martinrybka2000/openacme-pfm/v1.0/README.md

# V1.0 — legacy prototype (reference only)

This directory is the home for the **unorganized dump** of the V1.0 work, kept for reference:

- The master's thesis as PDF (Polish and English).
- The V1.0 KiCad project (`PCB/`), firmware (`Firmware_VSCode/`) and measurement data (`pomiary/`).
- Serial Studio project files (`Serial_studio_proj/`).
- Third-party libraries used by V1.0 (`scpi-parser-master/`).

**No cleanup, no support.** These files are historical reference; active development happens at the repository root (V2.0).
