martinrybka2000/openacme-pfm/docs/protocol/modbus-map.md

# Modbus map

TBD — define the register map.

Planned sections:

- **Read:** measurement registers (Urms, Irms, P, Q, S, PF, DPF, DF, THD_U, THD_I, f, peaks, …).
- **Config:** network/IP settings, calibration factors, SOGI-PLL gains, mode selection.
- **Status:** device state, fault flags.

Work in progress — see `docs/requirements/requirements.md` (REQ-C-*).
