martinrybka2000/openacme-pfm/docs/protocol/pqdif.md

# PQDIF (IEEE 1159.3)

TBD.

Plan: export measurement records in **PQDIF** so they open directly in professional power-quality analysis tools — bringing the open-source project to parity with commercial analysers (see V1.0 thesis, section 7.3).

Notes:

- Standard: IEEE Std 1159.3.
- Reference for the format and compression (zlib).
- Decide record types to support (observations, statistics).
