martinrybka2000/openacme-pfm/v1.0/PCB/V1_0_notes.sync-conflict-20260513-040853-QFY63LB.txt

ESD footprint
TPS UV/OV resistors
VCC do fault led powinno być przed TPS
R35 zbędny, R36 prawdopodobnie też 
Odstep pomiędzy wyspami zasilań 
złe rezystory do tpsa
