martinrybka2000/openacme-pfm/v1.0/PDFs/Cyfrowy Pomiar Współczynnika Mocy_ Opis, Metody i Komponenty_.pdf

## Cyfrowy Pomiar Współczynnika Mocy: Szczegółowy Opis i Metody

### Wprowadzenie do Cyfrowego Pomiaru Współczynnika Mocy

Cyfrowy pomiar współczynnika mocy (PF) to nowoczesna metoda określania efektywności wykorzystania energii elektrycznej w obwodach prądu przemiennego (AC). W przeciwieństwie do tradycyjnych metod analogowych, cyfrowe techniki pomiarowe oferują wyższą dokładność, większą wszechstronność i możliwość analizy złożonych przebiegów napięcia i prądu.

1 Metoda ta polega na wykorzystaniu zaawansowanych układów elektronicznych i algorytmów do precyzyjnego określenia współczynnika mocy, nawet w obecności zniekształceń harmonicznych.

7

### Komponenty Wykorzystywane w Cyfrowym Pomiarze Współczynnika Mocy

Do przeprowadzenia cyfrowego pomiaru współczynnika mocy wykorzystuje się szereg komponentów elektronicznych, które współpracują ze sobą w celu akwizycji, przetwarzania i wyświetlenia danych. Typowy system pomiarowy obejmuje:
1. Czujniki Napięcia i Prądu:
- Przekładniki prądowe (CT - Current Transformers): Służą do bezpiecznego i proporcjonalnego zmniejszenia wartości prądu płynącego w obwodzie do poziomu akceptowalnego dla układów pomiarowych.

13
Umożliwiają pomiar prądów o dużych wartościach bez konieczności bezpośredniego łączenia z obwodem o wysokim napięciu.

7
- Przekładniki napięciowe (PT - Potential Transformers): Podobnie jak przekładniki prądowe, służą do zmniejszenia wysokich napięć do bezpiecznych poziomów pomiarowych.

13
- Rezystory bocznikowe (Shunt Resistors): Precyzyjne rezystory o małej rezystancji, umieszczane szeregowo w obwodzie, na których mierzony jest spadek napięcia proporcjonalny do przepływającego prądu.

13
- Sondy napięciowe i prądowe (Voltage and Current Probes): Wykorzystywane w połączeniu z oscyloskopami i analizatorami jakości energii do akwizycji przebiegów napięcia i prądu.

7 Sondy prądowe, często oparte na technologii cęgowej (clamp-on), umożliwiają pomiar prądu bez przerywania obwodu.

7
2. Układy Przetwarzania Sygnałów Analogowych:
- Wzmacniacze: Wzmacniają sygnały z czujników do poziomów odpowiednich dla przetworników analogowo-cyfrowych.

26

- Filtry: Służą do eliminacji niepożądanych składowych sygnału, takich jak szumy i zakłócenia.

26
3. Przetworniki Analogowo-Cyfrowe (ADC - Analog-to-Digital Converters):
- Przekształcają ciągłe sygnały analogowe (napięcie i prąd) na ich dyskretne reprezentacje cyfrowe w postaci próbek o określonej rozdzielczości i częstotliwości próbkowania. Wyższa rozdzielczość (liczba bitów) i wyższa częstotliwość próbkowania pozwalają na dokładniejsze odwzorowanie przebiegów, zwłaszcza w przypadku sygnałów o złożonym kształcie lub zawierających harmoniczne.

26
4. Mikrokontroler lub Cyfrowy Procesor Sygnałowy (MCU/DSP -Microcontroller Unit/Digital Signal Processor):
- Stanowi centralną jednostkę obliczeniową systemu pomiarowego. Wykonuje algorytmy do obliczania wartości skutecznych napięcia i prądu, mocy czynnej, mocy pozornej oraz współczynnika mocy na podstawie danych cyfrowych z przetworników ADC.

27 DSP są zoptymalizowane do szybkiego przetwarzania sygnałów, co jest szczególnie ważne przy analizie harmonicznych i złożonych przebiegów.

27
5. Pamięć:
- Służy do przechowywania próbek danych z przetworników ADC, wyników obliczeń oraz oprogramowania sterującego mikrokontrolerem/DSP.
6. Wyświetlacz:
- Umożliwia prezentację zmierzonej wartości współczynnika mocy oraz innych parametrów elektrycznych, takich jak napięcie, prąd, moc czynna, moc bierna, częstotliwość. Wyświetlacze mogą być numeryczne lub graczne, w zależności od złożoności miernika.
7. Interfejs Komunikacyjny (Opcjonalnie):
- Niektóre zaawansowane mierniki i analizatory posiadają interfejsy komunikacyjne (np. USB, Ethernet, Wi-Fi) do przesyłania danych do komputera w celu dalszej analizy, raportowania lub zdalnego monitorowania.

### Metody Cyfrowego Pomiaru Współczynnika Mocy i Obliczenia

Cyfrowy pomiar współczynnika mocy opiera się na analizie próbek napięcia i prądu w czasie. Podstawowe kroki i związane z nimi obliczenia obejmują:
1. Pobieranie Próbek Napięcia i Prądu:
- Czujniki napięcia i prądu dostarczają sygnały analogowe proporcjonalne do mierzonych wielkości.
- Przetworniki ADC próbkują te sygnały jednocześnie z określoną częstotliwością w ciągu jednego lub więcej cykli prądu przemiennego.

2. Obliczanie Wartości Skutecznych (RMS - Root Mean Square):
- Na podstawie zebranych próbek cyfrowych obliczane są wartości skuteczne napięcia (VRMS

) i prądu (IRMS

).

7 Wartość skuteczna jest miarą efektywnej wartości sygnału AC, odpowiadającej wartości napięcia/prądu DC, która wydzieliłaby taką samą moc na rezystancji.
- Wzór na wartość skuteczną dla dyskretnych próbek:

oraz

gdzie N to liczba próbek, a vi

i i

i to poszczególne próbki napięcia i prądu.

3. Obliczanie Mocy Czynnej (P - Real Power):
- Moc czynna reprezentuje rzeczywistą moc zużywaną przez obciążenie do wykonania użytecznej pracy.

7 W cyfrowym pomiarze, moc czynną można obliczyć na dwa sposoby:
■ Metoda bezpośrednia (przez moc chwilową): Oblicza się chwilową moc (Pi = vi * i
i) dla każdej pary próbek napięcia i prądu, a następnie wyznacza się średnią wartość mocy chwilowej w danym okresie.

7

■ Metoda wykorzystująca kąt fazowy (dla przebiegów sinusoidalnych): Jeśli przebiegi napięcia i prądu są sinusoidalne, moc czynną można obliczyć znając kąt fazowy (φ) między nimi: P = VRMS * IRMS * cos(φ).

7
Kąt fazowy jest określany na podstawie analizy czasowej przebiegów.
4. Obliczanie Mocy Pozornej (S - Apparent Power):
- Moc pozorna jest iloczynem wartości skutecznych napięcia i prądu.

7

S = VRMS * IRMS

5. Obliczanie Współczynnika Mocy (PF - Power Factor):
- Współczynnik mocy jest deniowany jako stosunek mocy czynnej do mocy pozornej.

7

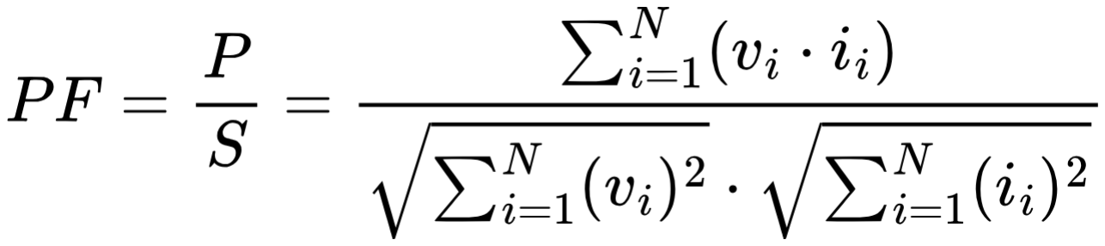
[picture p27: figure]

- Dla przebiegów sinusoidalnych: PF = cos(φ)

### Zaawansowane Aspekty Cyfrowego Pomiaru Współczynnika Mocy

W przypadku obciążeń nieliniowych, które generują harmoniczne prądu, współczynnik mocy jest bardziej złożony i obejmuje dwa komponenty:
- Współczynnik mocy przesunięcia (DPF - Displacement Power Factor): Jest to kosinus kąta fazowego między podstawowymi składowymi napięcia i prądu.

33
- Współczynnik zniekształceń (DF - Distortion Factor): Uwzględnia wpływ harmonicznych na współczynnik mocy.

34

Prawdziwy współczynnik mocy (True Power Factor) dla przebiegów niesinusoidalnych jest iloczynem współczynnika mocy przesunięcia i współczynnika zniekształceń:

True PF = DPF * DF

Analizatory jakości energii wykorzystują zaawansowane techniki, takie jak szybka transformata Fouriera (FFT), do analizy harmonicznych i dokładnego pomiaru prawdziwego współczynnika mocy.

7

### Zastosowania Cyfrowego Pomiaru Współczynnika Mocy

Cyfrowy pomiar współczynnika mocy jest szeroko stosowany w wielu aplikacjach, w tym:
- Monitorowanie i optymalizacja zużycia energii: Pozwala na identykację obciążeń o niskim współczynniku mocy i podejmowanie działań korygujących.

36
- Analiza jakości energii: Umożliwia ocenę wpływu harmonicznych na współczynnik mocy i ogólną jakość zasilania.

37
- Testowanie i certykacja urządzeń elektrycznych i elektronicznych: Sprawdzenie zgodności z normami dotyczącymi współczynnika mocy (np. IEC 61000-3-2).

44
- Diagnostyka i konserwacja systemów elektroenergetycznych: Wykrywanie problemów związanych z mocą bierną i przeciążeniami.

45

### Podsumowanie

Cyfrowy pomiar współczynnika mocy stanowi precyzyjne i wszechstronne narzędzie do oceny efektywności energetycznej systemów elektrycznych. Wykorzystanie nowoczesnych komponentów elektronicznych i zaawansowanych algorytmów umożliwia dokładny pomiar współczynnika mocy nawet w złożonych warunkach obciążenia. Zrozumienie zasady działania, wykorzystywanych komponentów oraz metod obliczeniowych jest kluczowe dla efektywnego wykorzystania tej technologii w praktyce inżynierskiej.

Cytowane prace

1. All about Power Factor Meters - A Detailed Guide - Beemet, otwierano: kwietnia 9, 2025, hps://beemet.com/power-factor-meter-guide/
2. Design of Digital power factor meter - Quest Journals, otwierano: kwietnia 9, 2025, hps://www.questjournals.org/jecer/papers/vol8-issue12/08120106.pdf
3. The Basic of Power Meter - PRODIGIT ELECTRONICS, otwierano: kwietnia 9, 2025, hps://www.prodigit.com/show/the-basic-of-power-meter.htm
4. What are the Applications and Uses of Digital Power Meter? - MEXTECH, otwierano: kwietnia 9, 2025, hps://mextechin.com/applications-uses-digital-power-meter/
5. (PDF) Digital Power Factor Meter - ResearchGate, otwierano: kwietnia 9, 2025, hps://www.researchgate.net/publication/361119529_Digital_Power_Factor_Meter
6. digital energy meter working principle - YouTube, otwierano: kwietnia 9, 2025, hps://www.youtube.com/watch?v=HcZC-_PtRk8
7. Power factor - Wikipedia, otwierano: kwietnia 9, 2025, hps://en.wikipedia.org/wiki/Power_factor
8. Fundamentals of AC Power Measurements | Tektronix, otwierano: kwietnia 9,
2025,
hps://www.tek.com/en/documents/application-note/fundamentals-ac-power-m easurements (https://www.tek.com/en/documents/application-note/fundamentals-ac-power-measurements)
9. How do you calculate the power factor of a power supply? - Electronics Stack Exchange, otwierano: kwietnia 9, 2025, hps://electronics.stackexchange.com/questions/138582/how-do-you-calculate-t he-power-factor-of-a-power-supply (https://electronics.stackexchange.com/questions/138582/how-do-you-calculate-the-power-factor-of-a-power-supply)
10. Power factor meters - how do they work, teardown, experiments - YouTube, otwierano: kwietnia 9, 2025, hps://www.youtube.com/watch?v=8WUJgbqElOc
11. Power Quality Analyzers | Instrumart, otwierano: kwietnia 9, 2025,
hps://www.instrumart.com/categories/5980/power-quality-analyzers
12. Power Analyzer: The Swiss Army Knife of Electronics Testing | Keysight Blogs,
otwierano: kwietnia 9, 2025, hps://www.keysight.com/blogs/en/tech/educ/2023/power-analyzer
13. www.uke.com, otwierano: kwietnia 9, 2025, hps://www.uke.com/en-us/learn/blog/power-quality/power-factor-formula#:~:t (https://www.fluke.com/en-us/learn/blog/power-quality/power-factor-formula)

ext=The%20lower%20the%20power%20factor,penalize%20a%20customer%20f or%20overutilization. (https://www.fluke.com/en-us/learn/blog/power-quality/power-factor-formula)
14. Fundamentals of Electric Power Measurements | Yokogawa Test&Measurement,
otwierano: kwietnia 9, 2025, hps://tmi.yokogawa.com/us/library/resources/white-papers/fundamentals-of-ele ctric-power-measurements/ (https://tmi.yokogawa.com/us/library/resources/white-papers/fundamentals-of-electric-power-measurements/)
15. Power Supply Measurement & Analysis with Bench Oscilloscopes | Tektronix,
otwierano: kwietnia 9, 2025, hps://www.tek.com/en/documents/application-note/power-supply-measuremen t-analysis-bench-oscilloscopes (https://www.tek.com/en/documents/application-note/power-supply-measurement-analysis-bench-oscilloscopes)
16. Power factor measurement and math channel for oscilloscopes - Pico Technology, otwierano: kwietnia 9, 2025, hps://www.picotech.com/library/knowledge-bases/oscilloscopes/power-factor-measurement-and-math-channel (https://www.picotech.com/library/knowledge-bases/oscilloscopes/power-factor-measurement-and-math-channel)
17. How To Measure Power Factor With An Oscilloscope, otwierano: kwietnia 9, 2025, hps://www.testandmeasuremenips.com/measure-power-factor-oscilloscope/ (https://www.testandmeasurementtips.com/measure-power-factor-oscilloscope/)
18. How to calculate Real Power and Power Factor using an Oscilloscope?, otwierano: kwietnia 9, 2025,
hps://electronics.stackexchange.com/questions/51320/how-to-calculate-real-p ower-and-power-factor-using-an-oscilloscope (https://electronics.stackexchange.com/questions/51320/how-to-calculate-real-power-and-power-factor-using-an-oscilloscope)
19. Power Factor (PF) Measurement Using a Digital Oscilloscope, otwierano: kwietnia 9, 2025,
hps://www.powerelectronicsnews.com/power-factor-pf-measurement-using-a -digital-oscilloscope/ (https://www.powerelectronicsnews.com/power-factor-pf-measurement-using-a-digital-oscilloscope/)
20. Active Power Factor Correction Verication Measurements with an Oscilloscope –– - Tektronix, otwierano: kwietnia 9, 2025, hps://download.tek.com/document/46W_60484_0_Active-Power-Factor_AN_HR .pdf (https://download.tek.com/document/46W_60484_0_Active-Power-Factor_AN_HR.pdf)
21. Measuring Power Quality with MXO Series Oscilloscopes - YouTube, otwierano: kwietnia 9, 2025, hps://www.youtube.com/watch?v=ym8kKDS3-EE
22. Measuring Power Factor with RTH Series Oscilloscopes - YouTube, otwierano: kwietnia 9, 2025, hps://www.youtube.com/watch?v=L_ebmznKGXc
23. Power factor with scope - YouTube, otwierano: kwietnia 9, 2025, hps://www.youtube.com/watch?v=x2rMCsJwAfc
24. Power Measurement Oscilloscope Style - Hackaday, otwierano: kwietnia 9, 2025, hps://hackaday.com/2019/04/24/power-measurement-oscilloscope-style/
25. PS5000 Graphical Power Quality Analyzer - PowerSight, otwierano: kwietnia 9, 2025, hps://powersight.com/products/power-analyzers/ps5000/
26. Explaining Power Factor Correction and Its Importance - Schneider Electric, otwierano: kwietnia 9, 2025, hps://eshop.se.com/in/blog/post/explaining-power-factor-correction-and-its-im portance.html (https://eshop.se.com/in/blog/post/explaining-power-factor-correction-and-its-importance.html)
27. www.uke.com, otwierano: kwietnia 9, 2025, hps://www.uke.com/en-us/learn/blog/power-quality/power-factor-formula#:~:t ext=Power%20factor%20is%20an%20expression,in%20kilovolt%20amperes%20 (https://www.fluke.com/en-us/learn/blog/power-quality/power-factor-formula)

(kVA). (https://www.fluke.com/en-us/learn/blog/power-quality/power-factor-formula)
28. What is Power Factor? | How to Calculate Power Factor Formula, otwierano:
kwietnia 9, 2025,
hps://www.uke.com/en-us/learn/blog/power-quality/power-factor-formula (https://www.fluke.com/en-us/learn/blog/power-quality/power-factor-formula)
29. Determining Power Factor Using the Two-Wameter Method - Technical Articles
- EEPower, otwierano: kwietnia 9, 2025, hps://eepower.com/technical-articles/determining-power-factor-using-the-two -wameter-method/ (https://eepower.com/technical-articles/determining-power-factor-using-the-two-wattmeter-method/)
30. Power Factor Formula: Understanding AC Circuit Eciency - The Electricity Forum, otwierano: kwietnia 9, 2025, hps://electricityforum.com/iep/power-quality/power-factor-formula
31. How do you practically nd power factor? : r/askanelectrician - Reddit, otwierano: kwietnia 9, 2025,
hps://www.reddit.com/r/askanelectrician/comments/lymglr/how_do_you_practic ally_nd_power_factor/ (https://www.reddit.com/r/askanelectrician/comments/lymglr/how_do_you_practically_find_power_factor/)
32. Power Factor - Mike Holt's Forum, otwierano: kwietnia 9, 2025, hps://forums.mikeholt.com/threads/power-factor.39833/
33. Understanding Power Factor in a UPS System: Why It Maers for Your Power Backup, otwierano: kwietnia 9, 2025, hps://www.ore-power.com/post/understanding-power-factor-in-a-ups-system -why-it-maers-for-your-power-backup (https://www.ore-power.com/post/understanding-power-factor-in-a-ups-system-why-it-matters-for-your-power-backup)
34. What is power factor | Eaton, otwierano: kwietnia 9, 2025,
hps://www.eaton.com/us/en-us/products/low-voltage-power-distribution-contr ol-systems/power-factor-correction-capacitors/what-is-power-factor.html (https://www.eaton.com/us/en-us/products/low-voltage-power-distribution-control-systems/power-factor-correction-capacitors/what-is-power-factor.html)
35. Why do we use capacitors for power factor correction and not inductors? -Reddit, otwierano: kwietnia 9, 2025, hps://www.reddit.com/r/ElectricalEngineering/comments/18zb051/why_do_we_u se_capacitors_for_power_factor/ (https://www.reddit.com/r/ElectricalEngineering/comments/18zb051/why_do_we_use_capacitors_for_power_factor/)
36. Electrodynamometer Type Power Factor Meter | PDF - Scribd, otwierano: kwietnia
9, 2025, hps://www.scribd.com/document/364107703/Power-Factor-Meters
37. Power Factor Meter To Improve Eciency - The Electricity Forum, otwierano: kwietnia 9, 2025,
hps://electricityforum.com/iep/power-quality/power-factor-meter
38. Power Quality Analyzer / Power Analyzer | PCE Instruments, otwierano: kwietnia 9,
2025,
hps://www.pce-instruments.com/us/measuring-instruments/test-meters/power -quality-analyzer-power-analyzer-kat_40071.htm (https://www.pce-instruments.com/us/measuring-instruments/test-meters/power-quality-analyzer-power-analyzer-kat_40071.htm)
39. Power Analyzers and Power Meters | Yokogawa Test&Measurement, otwierano:
kwietnia 9, 2025,
hps://tmi.yokogawa.com/us/solutions/products/power-analyzers/
40. Power Quality Data Loggers and Analyzers - MicroDAQ, otwierano: kwietnia 9, 2025, hps://microdaq.com/data-loggers/power-quality.php
41. PQube® 3 Power Analyzers - Powerside, otwierano: kwietnia 9, 2025, hps://powerside.com/products/power-quality-measurement-solutions/pqube-3 -power-analyzers/ (https://powerside.com/products/power-quality-measurement-solutions/pqube-3-power-analyzers/)

42. POWER QUALITY ANALYZER PQ3198 - Hioki, otwierano: kwietnia 9, 2025, hps://www.hioki.com/global/products/pqa/power-quality/id_6735
43. Power quality: Analyzers, meters, recorders, loggers - Fluke Corporation, otwierano: kwietnia 9, 2025, hps://www.uke.com/en-us/products/electrical-testing/power-quality (https://www.fluke.com/en-us/products/electrical-testing/power-quality)
44. Power Factor Explained - The Engineering Mindset, otwierano: kwietnia 9, 2025, hps://theengineeringmindset.com/power-factor-explained/
45. Determining power factor to use for load calculation from utility bills, otwierano: kwietnia 9, 2025,
hps://forums.mikeholt.com/threads/determining-power-factor-to-use-for-load-calculation-from-utility-bills.132045/ (https://forums.mikeholt.com/threads/determining-power-factor-to-use-for-load-calculation-from-utility-bills.132045/)
