martinrybka2000/openacme-pfm/v1.0/pomiary/FLIR0620.jpg

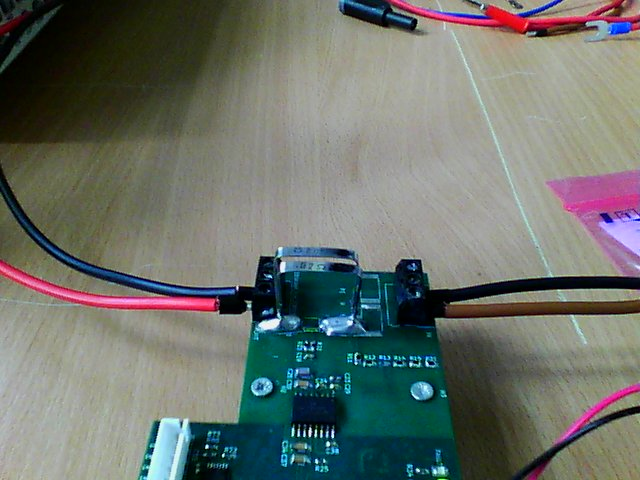
v1.0/pomiary/FLIR0620.jpg
