martinrybka2000/openacme-pfm/v1.0/pomiary/FLIR0624.jpg

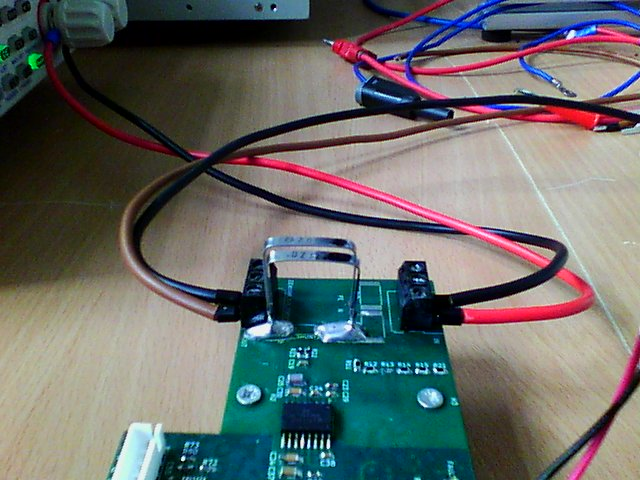
v1.0/pomiary/FLIR0624.jpg
