martinrybka2000/openacme-pfm/v1.0/pomiary/FLuke Zarowka LED/11.bmp

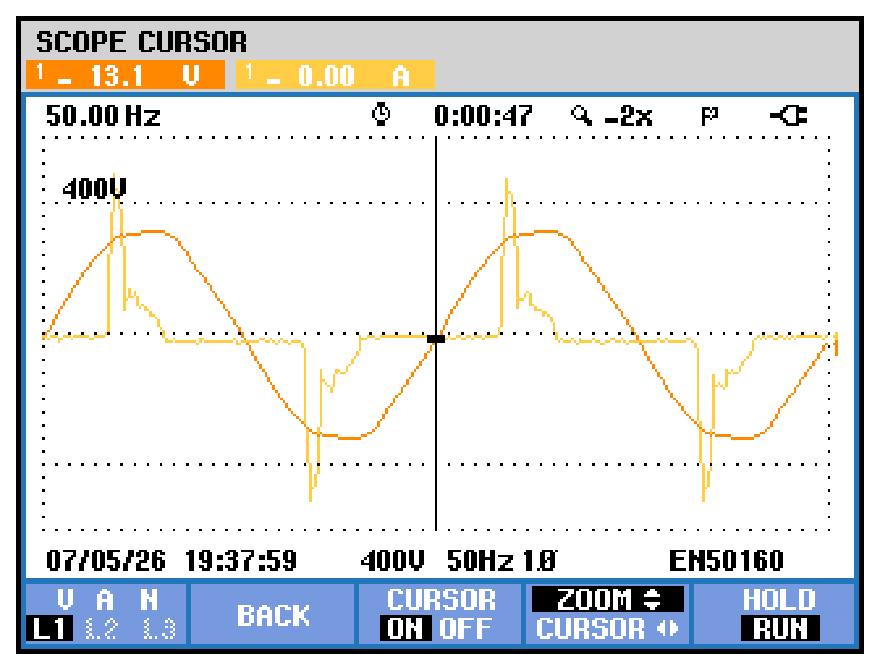
v1.0/pomiary/FLuke Zarowka LED/11.bmp
