martinrybka2000/openacme-pfm/v1.0/pomiary/FLuke Zarowka LED/all.png

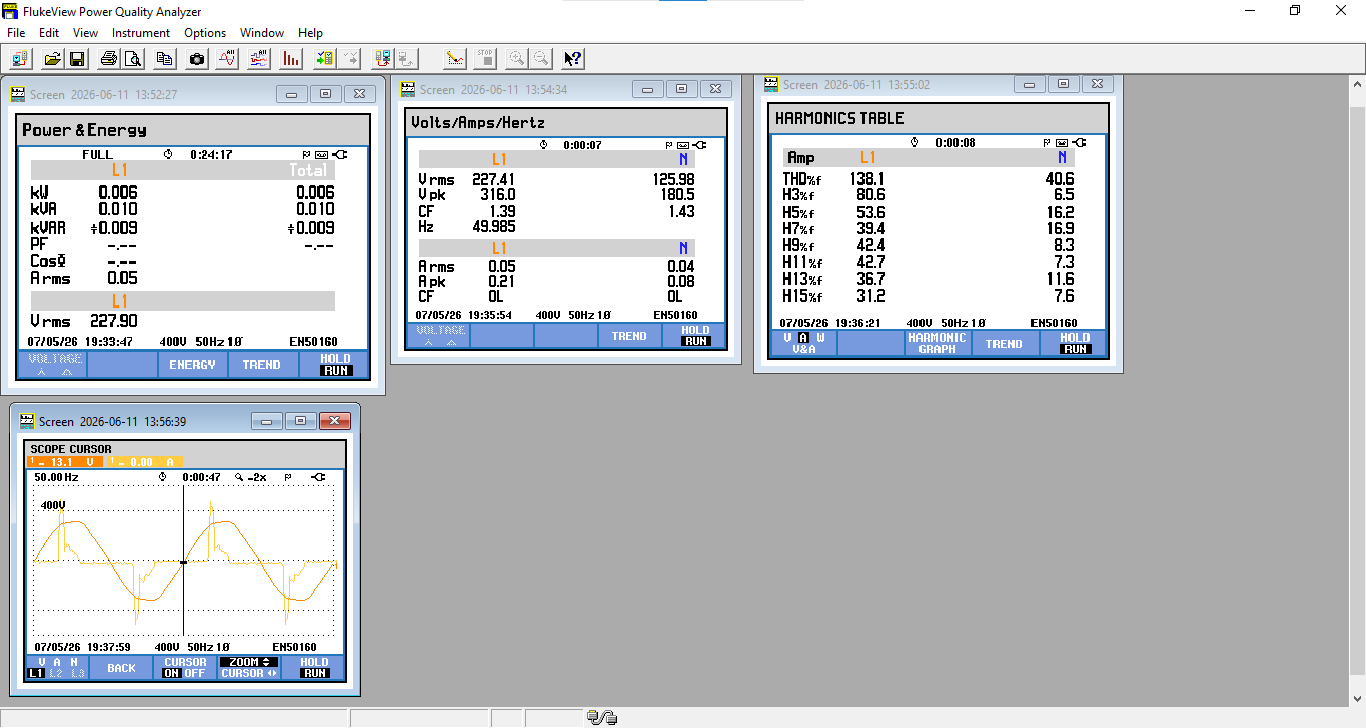
v1.0/pomiary/FLuke Zarowka LED/all.png
