martinrybka2000/openacme-pfm/v1.0/pomiary/FLuke Zarowka LED/Current.png

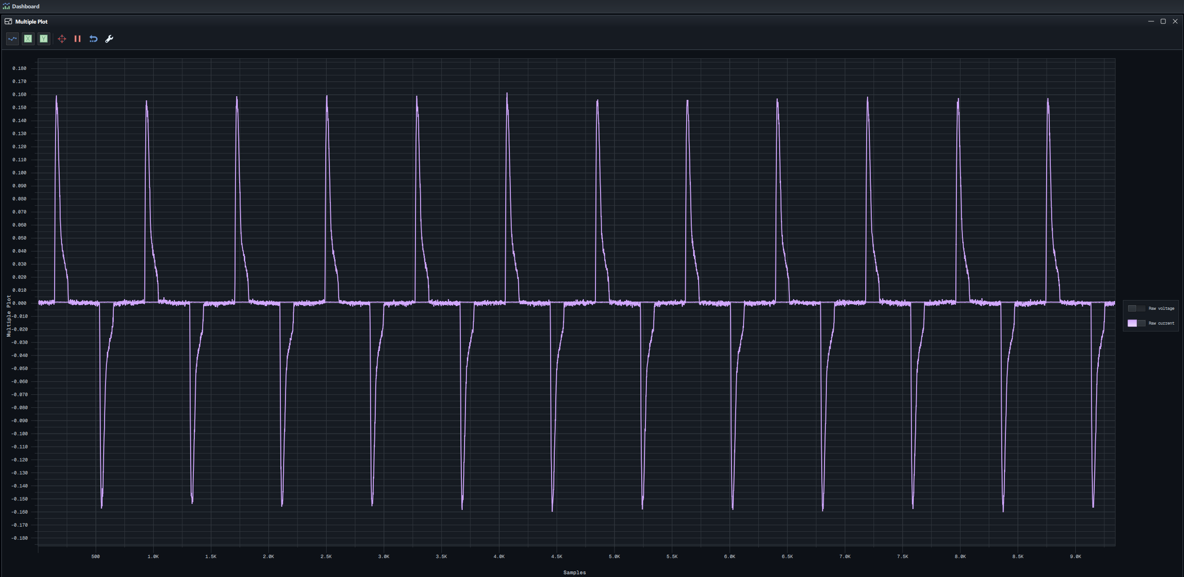
v1.0/pomiary/FLuke Zarowka LED/Current.png
