martinrybka2000/openacme-pfm/v1.0/pomiary/FLuke Zarowka LED/Mine_all.jpg

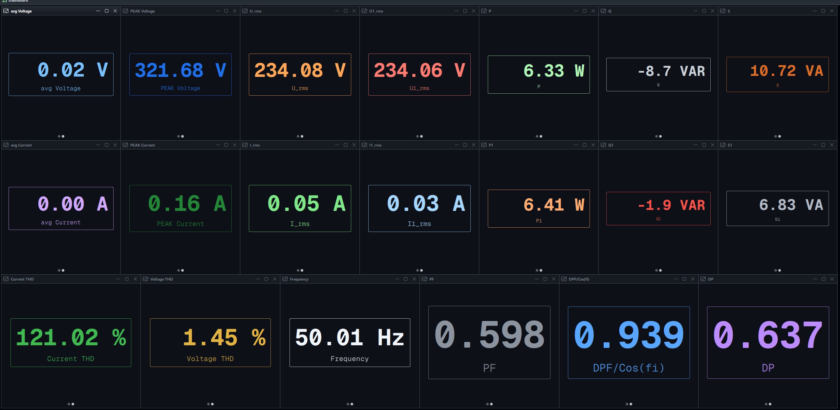
v1.0/pomiary/FLuke Zarowka LED/Mine_all.jpg
