martinrybka2000/openacme-pfm/v1.0/pomiary/Pomiary urzadzen/Grid/Bieżnia 2/Bieżnia 2_Czestotliwosc.png

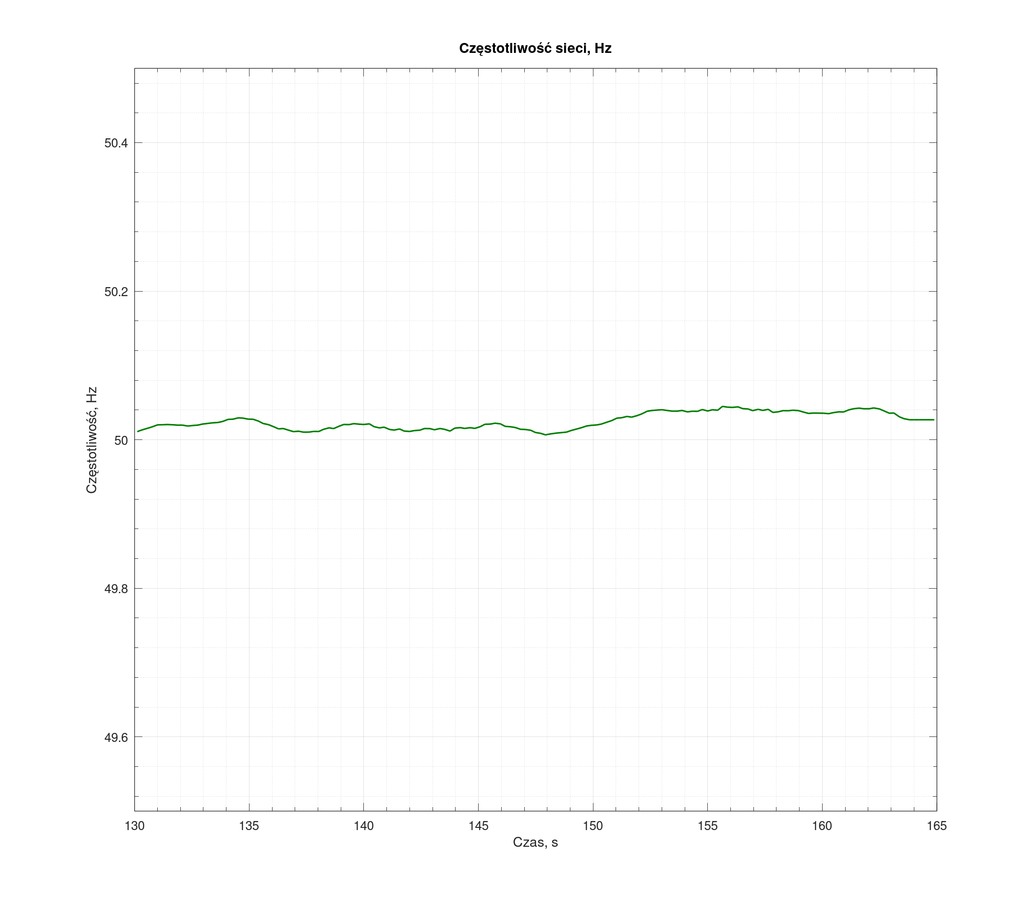
v1.0/pomiary/Pomiary urzadzen/Grid/Bieżnia 2/Bieżnia 2_Czestotliwosc.png
