martinrybka2000/openacme-pfm/v1.0/pomiary/Pomiary urzadzen/Grid/Bieżnia 2/Bieżnia 2_I_rms.png

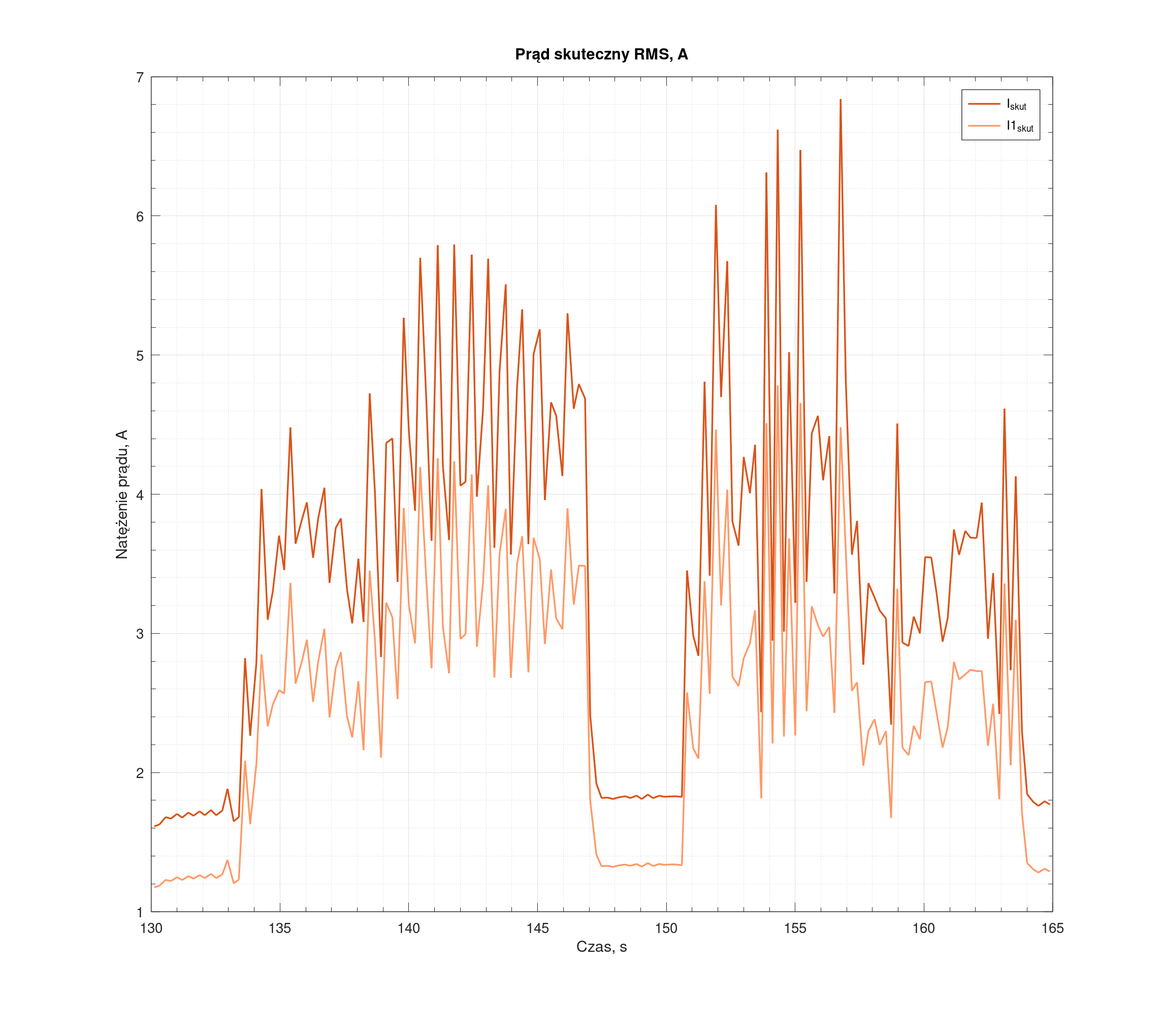
v1.0/pomiary/Pomiary urzadzen/Grid/Bieżnia 2/Bieżnia 2_I_rms.png
