martinrybka2000/openacme-pfm/v1.0/pomiary/Pomiary urzadzen/Grid/Bieżnia 2/Bieżnia 2_Peak.png

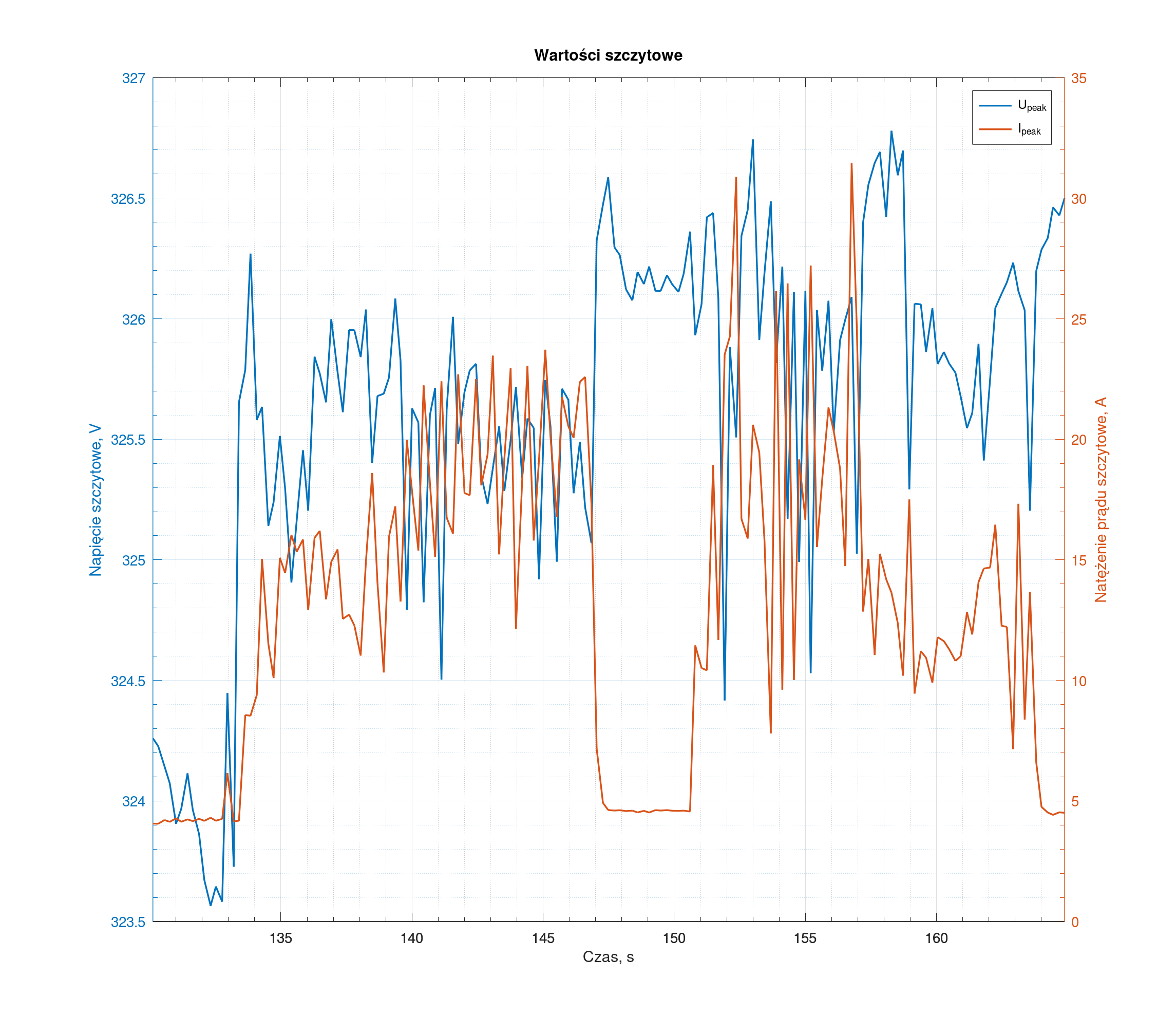
v1.0/pomiary/Pomiary urzadzen/Grid/Bieżnia 2/Bieżnia 2_Peak.png
