martinrybka2000/openacme-pfm/v1.0/pomiary/Pomiary urzadzen/Grid/Bieżnia/Bieżnia_Czestotliwosc.png

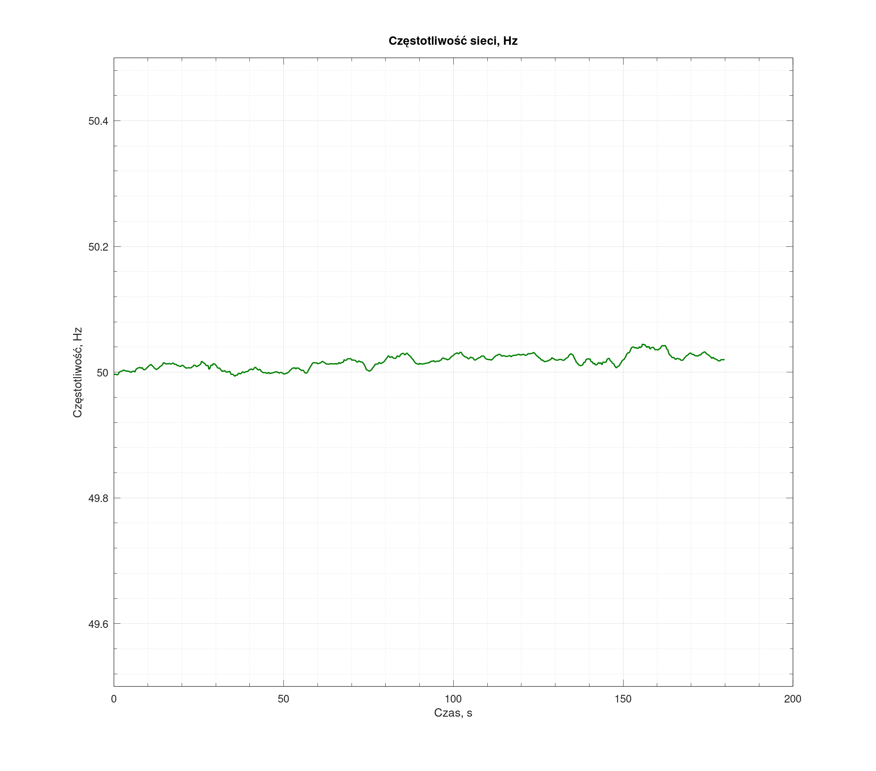
v1.0/pomiary/Pomiary urzadzen/Grid/Bieżnia/Bieżnia_Czestotliwosc.png
