martinrybka2000/openacme-pfm/v1.0/pomiary/Pomiary urzadzen/Grid/Bieżnia/Bieżnia_Moc_Calkowita.png

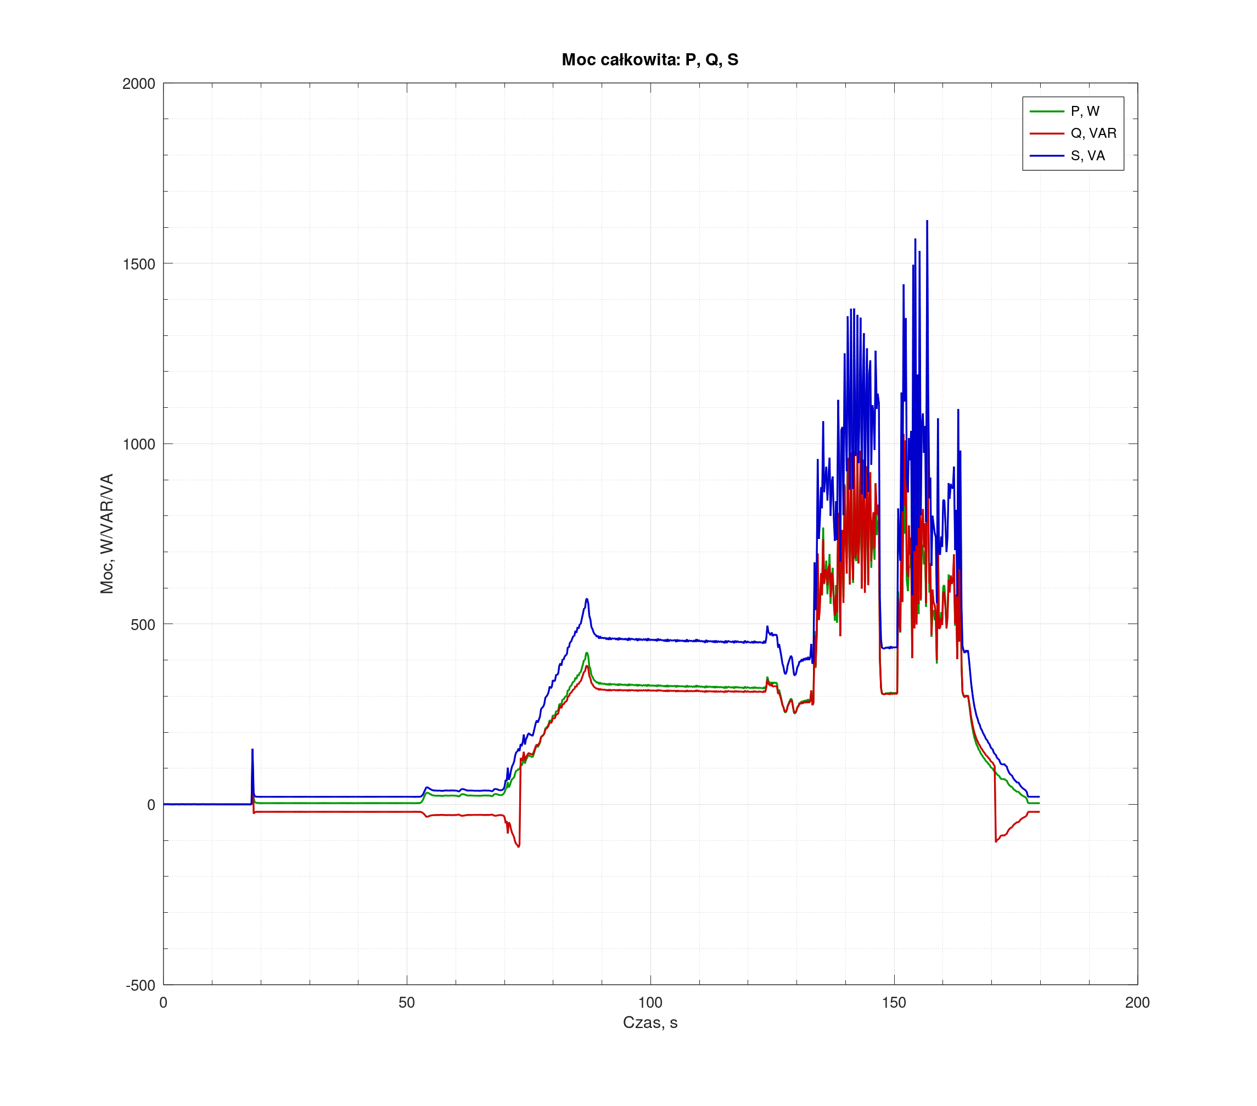
v1.0/pomiary/Pomiary urzadzen/Grid/Bieżnia/Bieżnia_Moc_Calkowita.png
