martinrybka2000/openacme-pfm/v1.0/pomiary/Pomiary urzadzen/Grid/Bieżnia/Bieżnia_THD.png

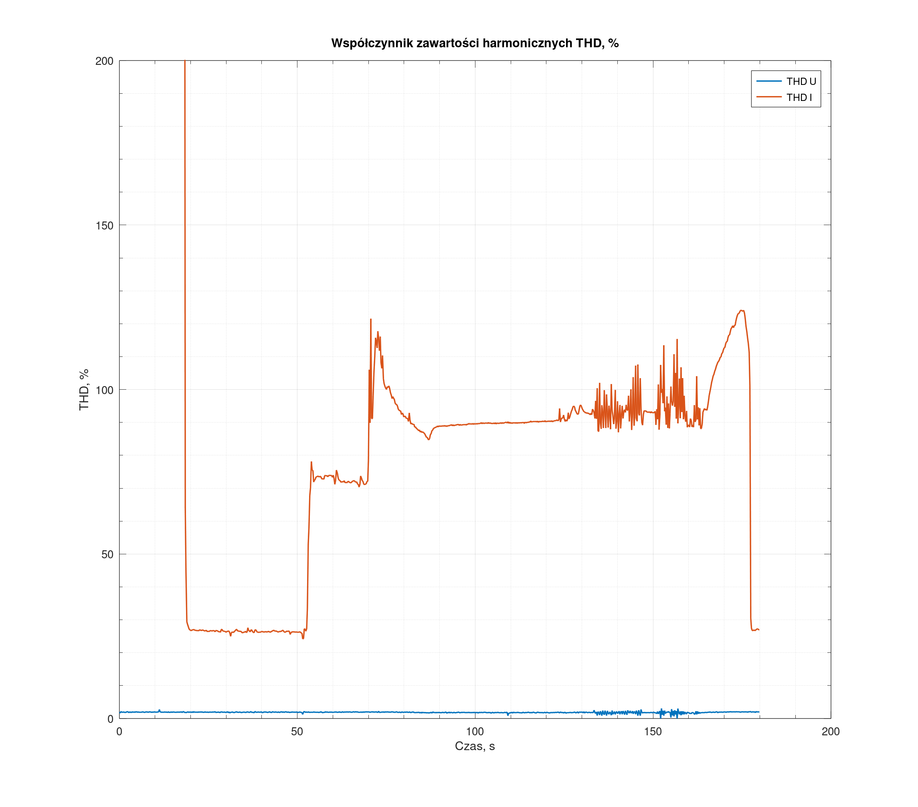
v1.0/pomiary/Pomiary urzadzen/Grid/Bieżnia/Bieżnia_THD.png
