martinrybka2000/openacme-pfm/v1.0/pomiary/Pomiary urzadzen/Grid/Bieżnia/Bieżnia_U_rms.png

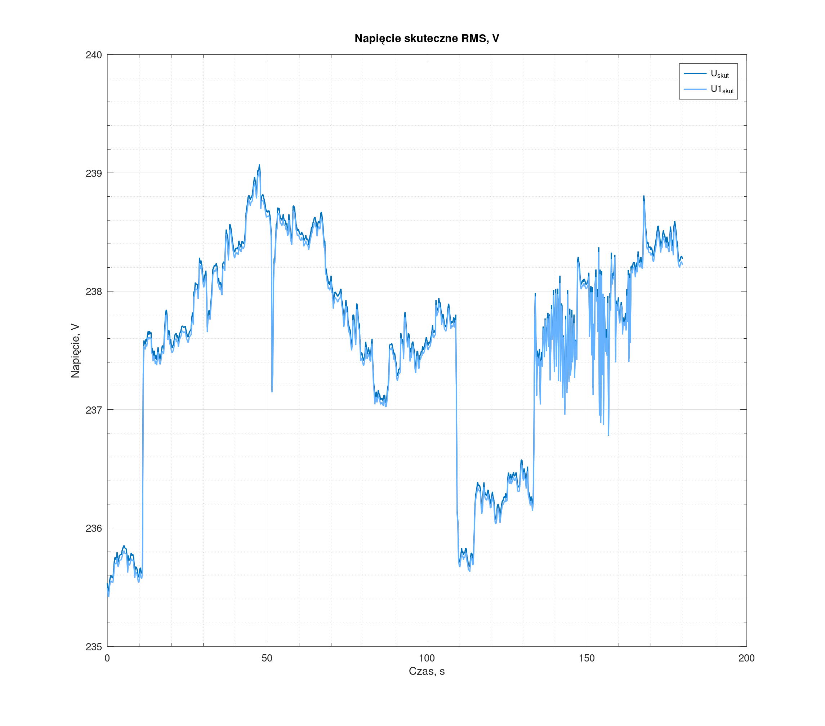
v1.0/pomiary/Pomiary urzadzen/Grid/Bieżnia/Bieżnia_U_rms.png
