martinrybka2000/openacme-pfm/v1.0/pomiary/Pomiary urzadzen/Grid/Bieżnia/Bieżnia_Zbiorczy_RMS.png

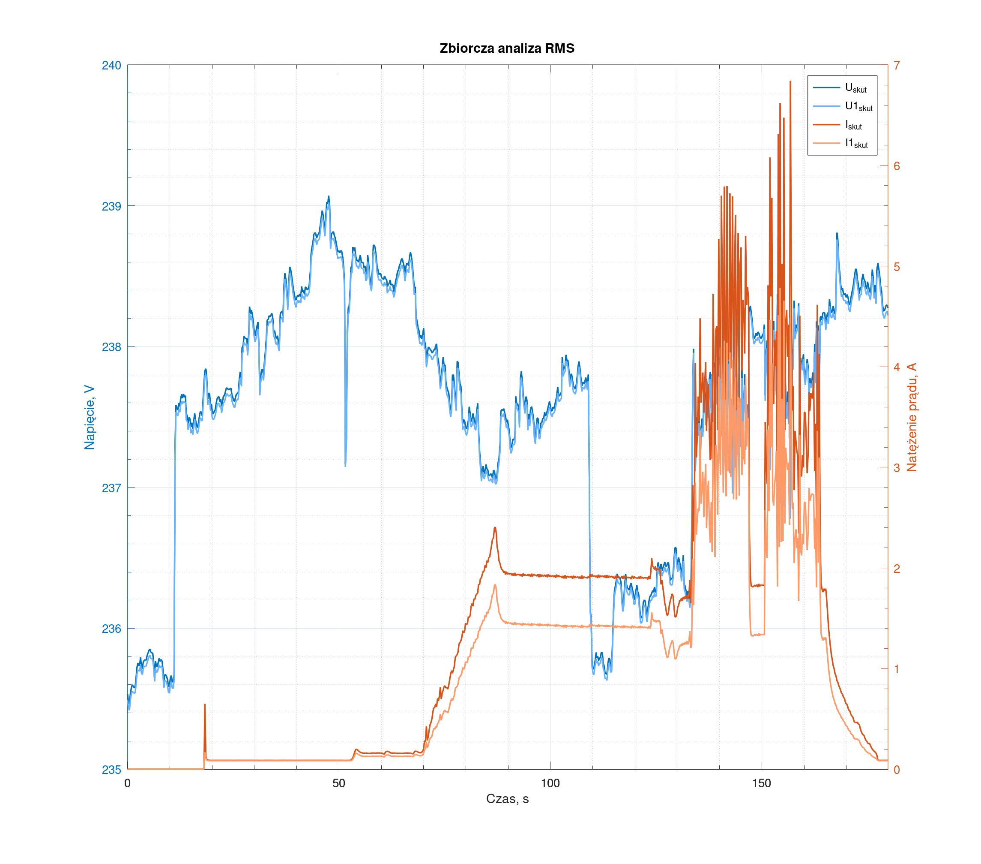
v1.0/pomiary/Pomiary urzadzen/Grid/Bieżnia/Bieżnia_Zbiorczy_RMS.png
