martinrybka2000/openacme-pfm/v1.0/pomiary/Pomiary urzadzen/Grid/Czajnik/Czajnik_Moc_Pelna.png

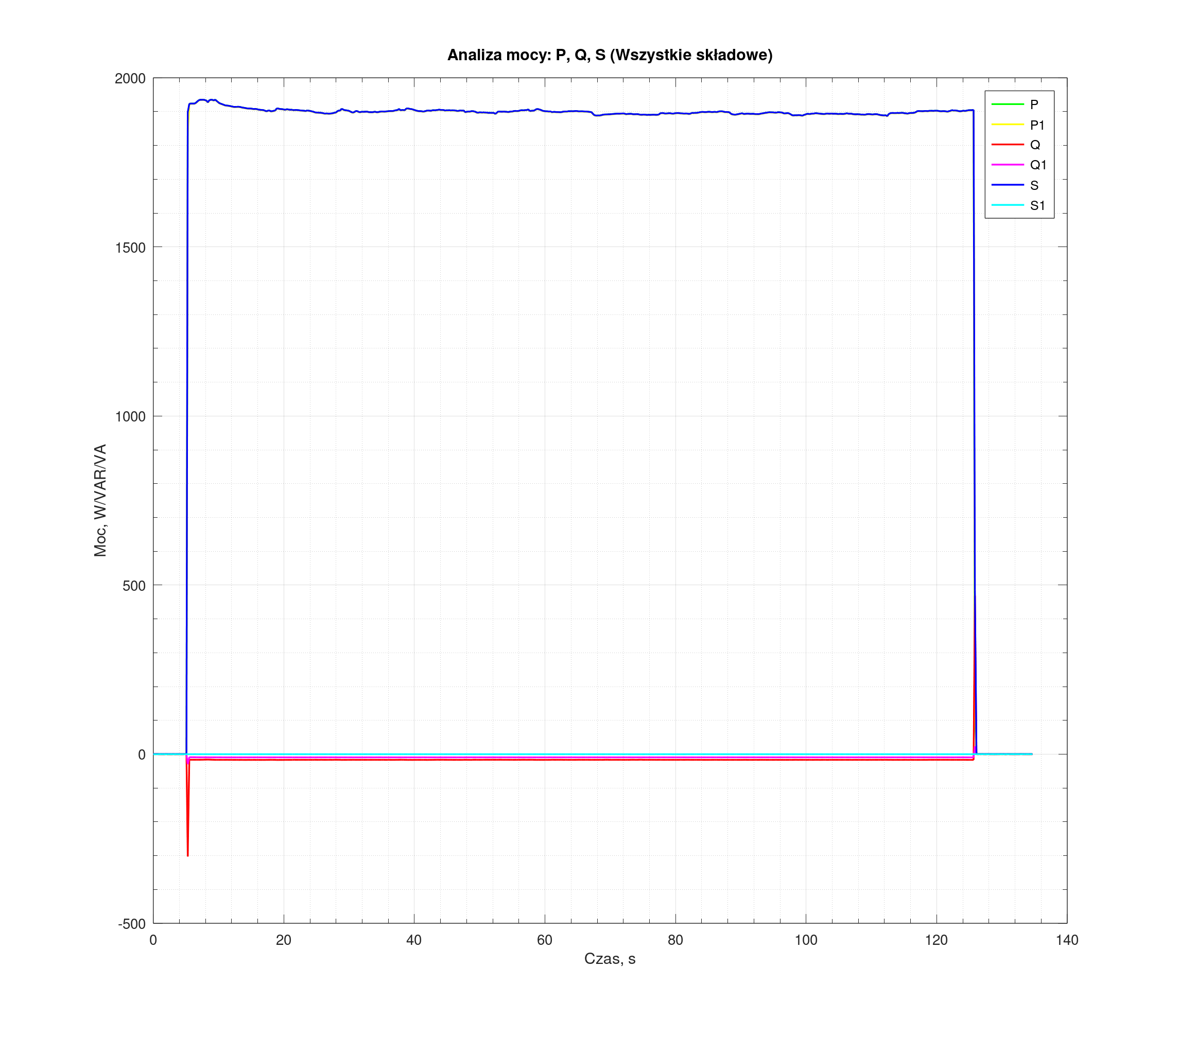
v1.0/pomiary/Pomiary urzadzen/Grid/Czajnik/Czajnik_Moc_Pelna.png
