martinrybka2000/openacme-pfm/v1.0/pomiary/Pomiary urzadzen/Grid/Komputer stacionarny/Komputer stacionarny_Moc_Pelna.png

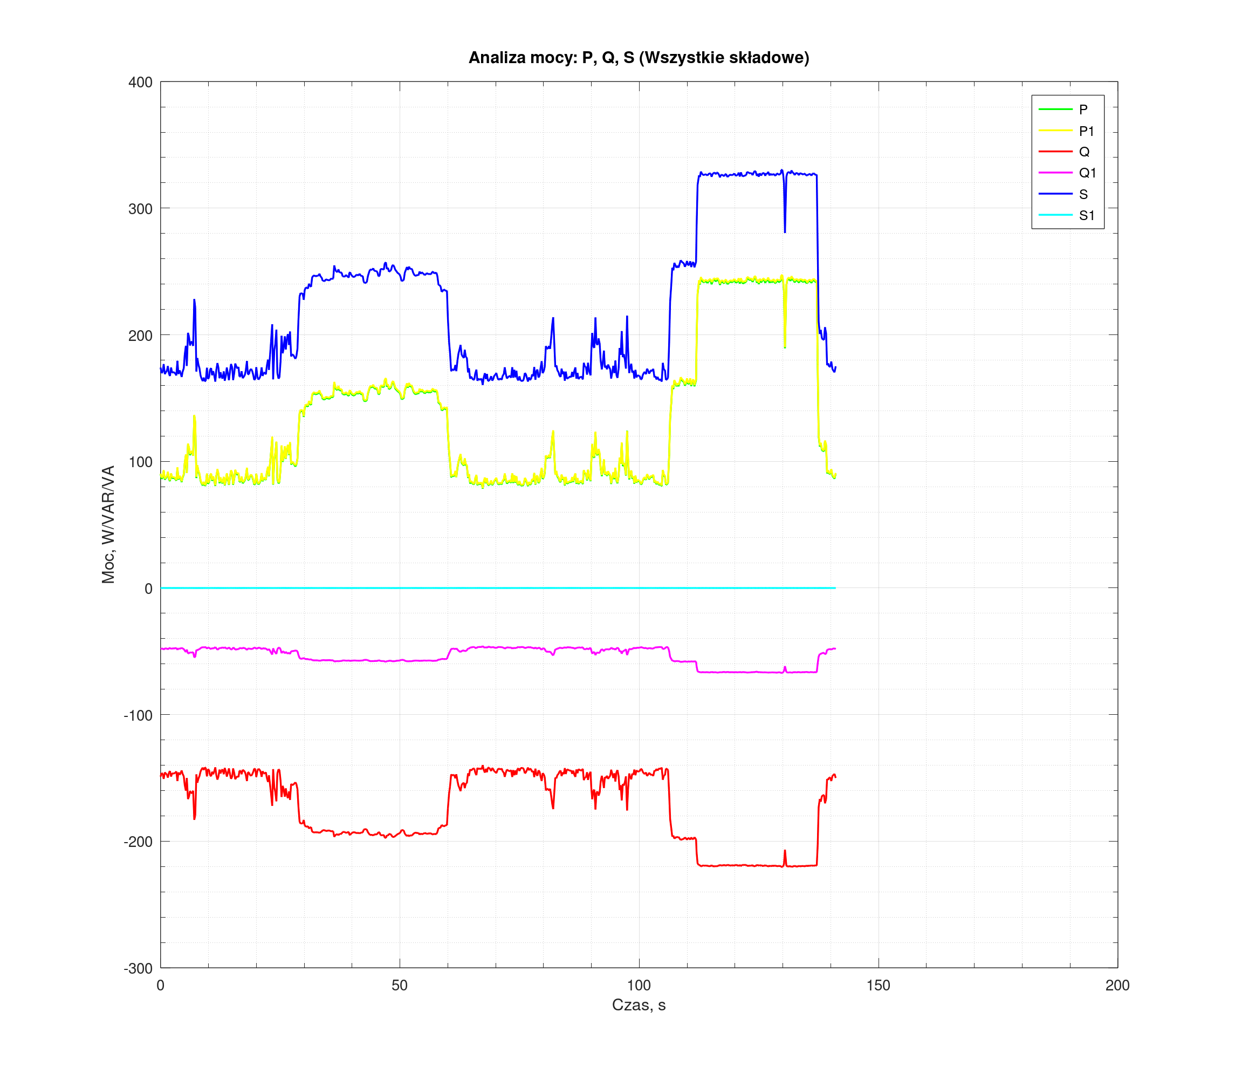
v1.0/pomiary/Pomiary urzadzen/Grid/Komputer stacionarny/Komputer stacionarny_Moc_Pelna.png
