martinrybka2000/openacme-pfm/v1.0/pomiary/Pomiary urzadzen/Grid/ladowarka_Lenowo_on.png

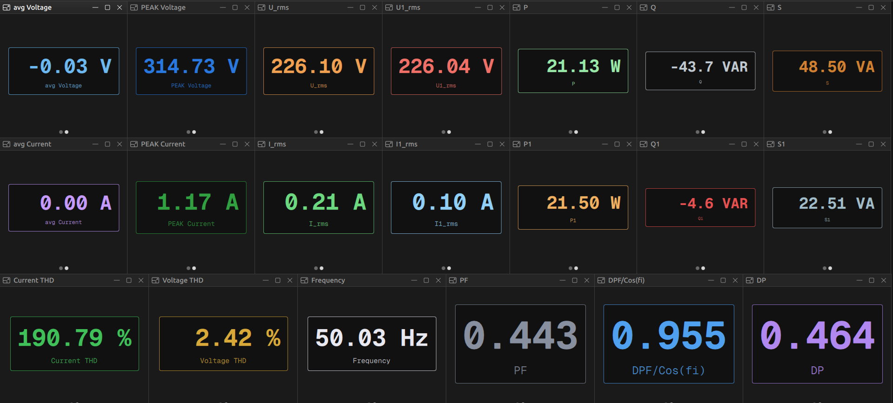
v1.0/pomiary/Pomiary urzadzen/Grid/ladowarka_Lenowo_on.png
