martinrybka2000/openacme-pfm/v1.0/pomiary/Pomiary urzadzen/Grid/Lampka nocna/Lampka nocna_Peak.png

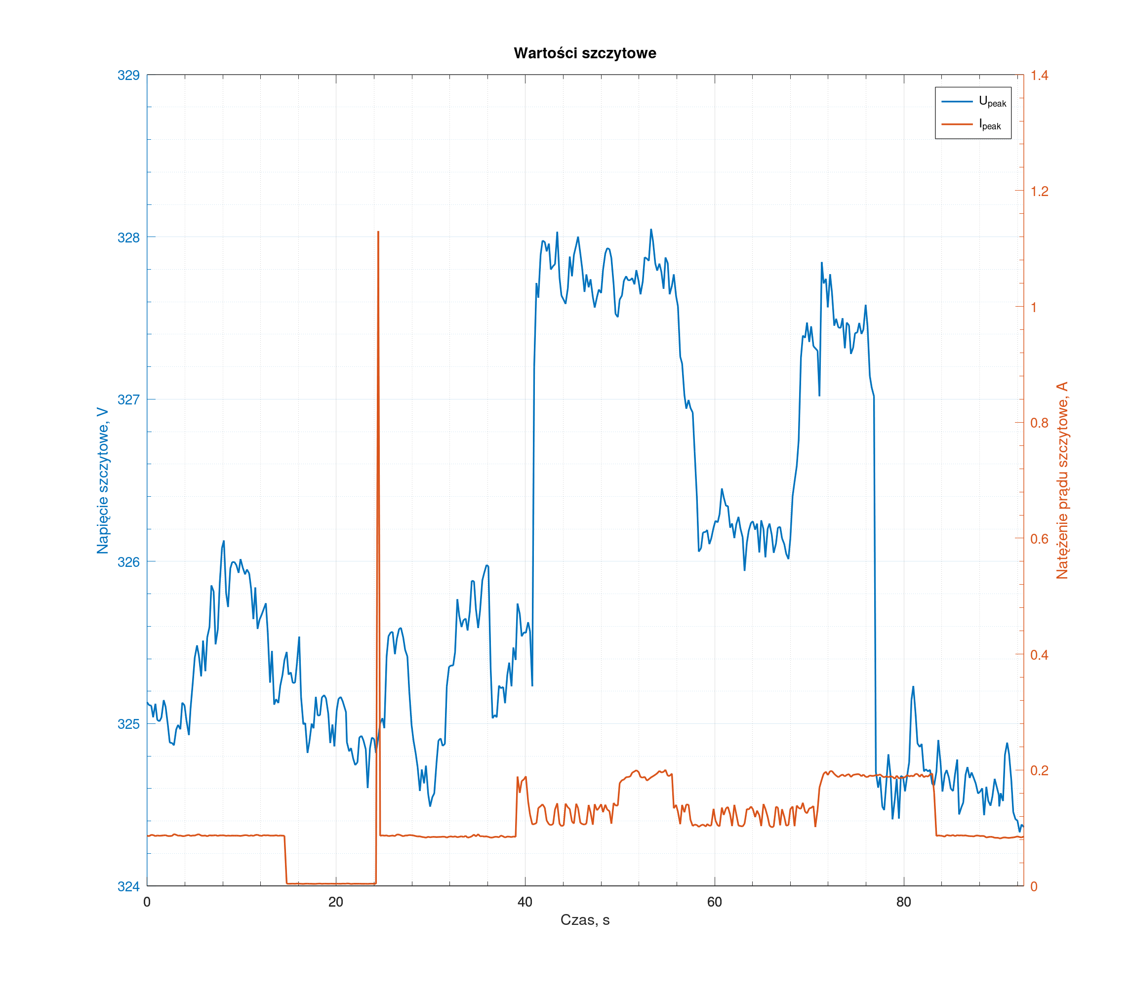
v1.0/pomiary/Pomiary urzadzen/Grid/Lampka nocna/Lampka nocna_Peak.png
