martinrybka2000/openacme-pfm/v1.0/pomiary/Pomiary urzadzen/Grid/Lampka nocna/Lampka nocna_Srednie_Symetryczne.png

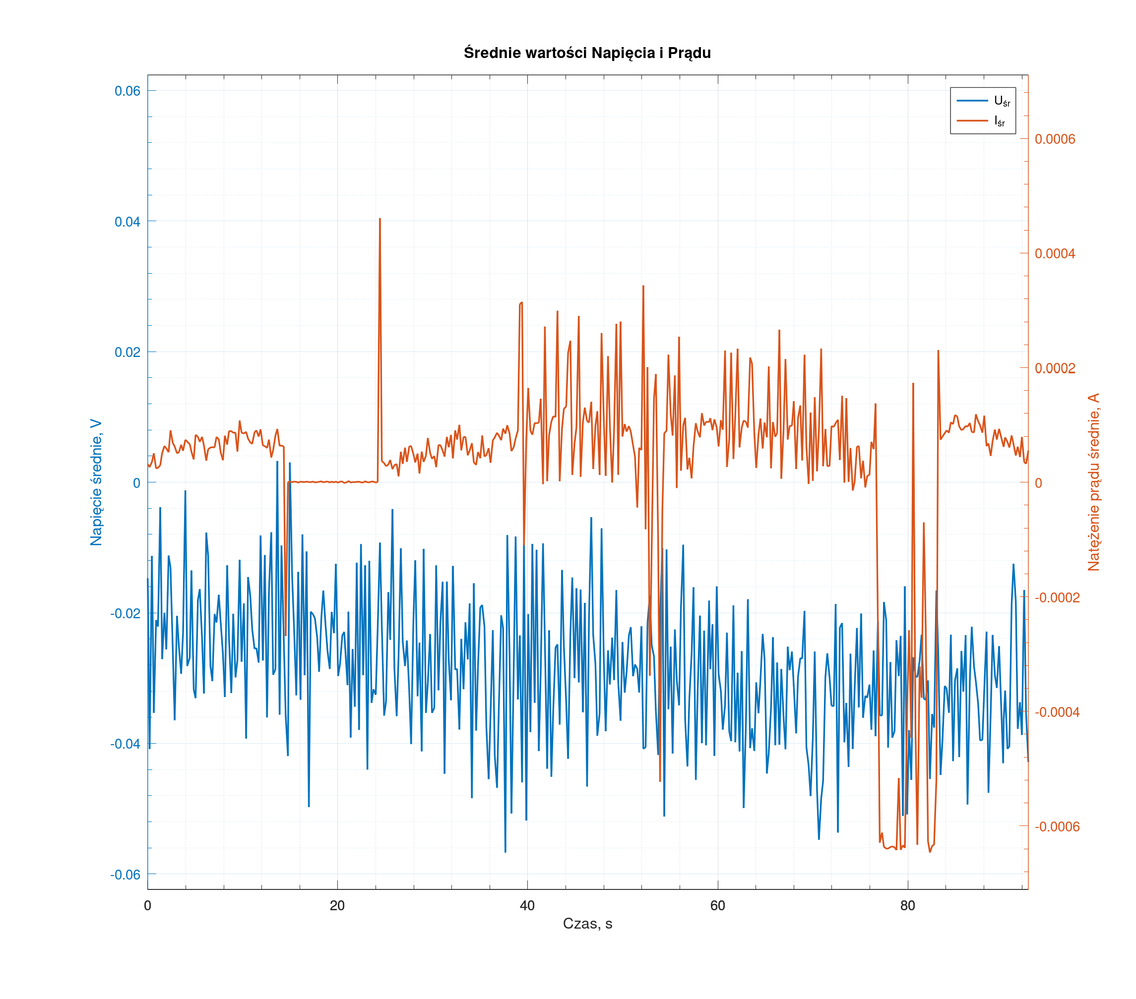
v1.0/pomiary/Pomiary urzadzen/Grid/Lampka nocna/Lampka nocna_Srednie_Symetryczne.png
