martinrybka2000/openacme-pfm/v1.0/pomiary/Pomiary urzadzen/Grid/Odkurzacz 1/Odkurzacz 1_I_rms.png

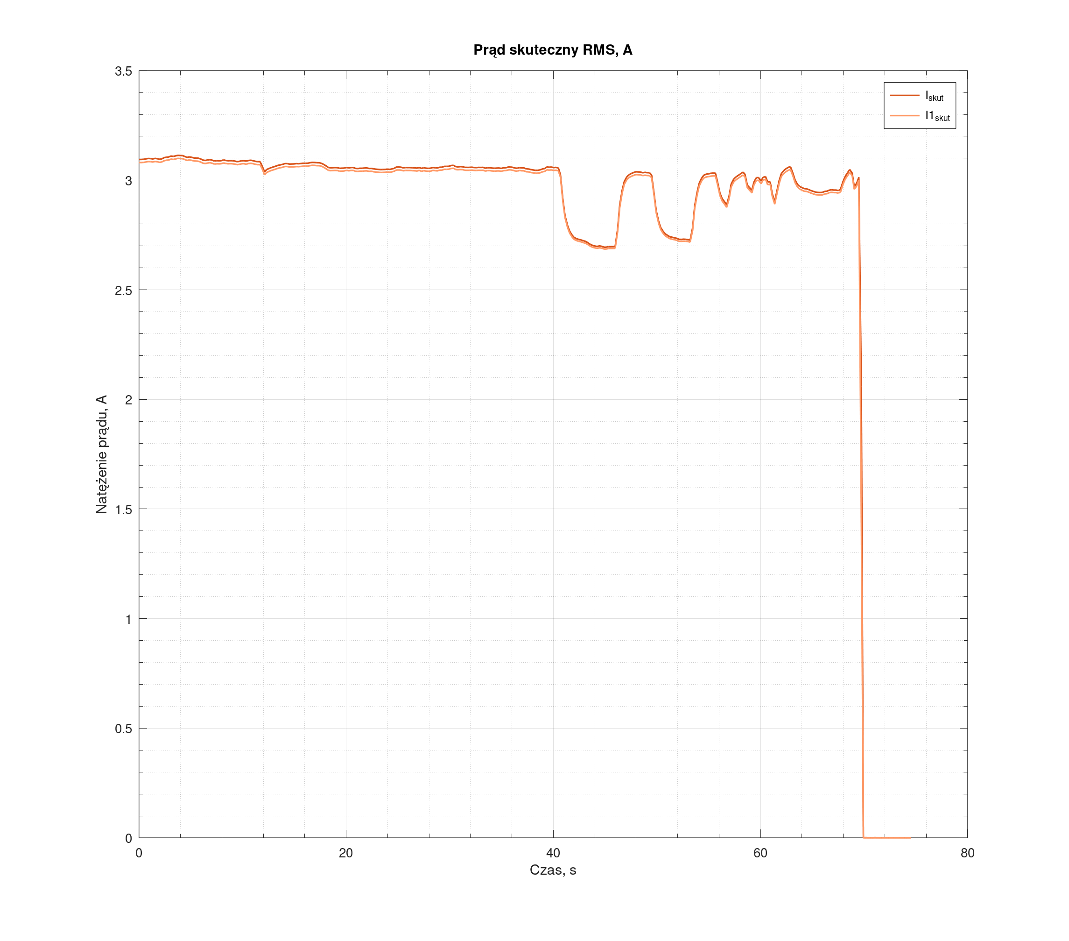
v1.0/pomiary/Pomiary urzadzen/Grid/Odkurzacz 1/Odkurzacz 1_I_rms.png
