martinrybka2000/openacme-pfm/v1.0/pomiary/Pomiary urzadzen/Grid/Odkurzacz 1/Odkurzacz 1_Srednie_Symetryczne.png

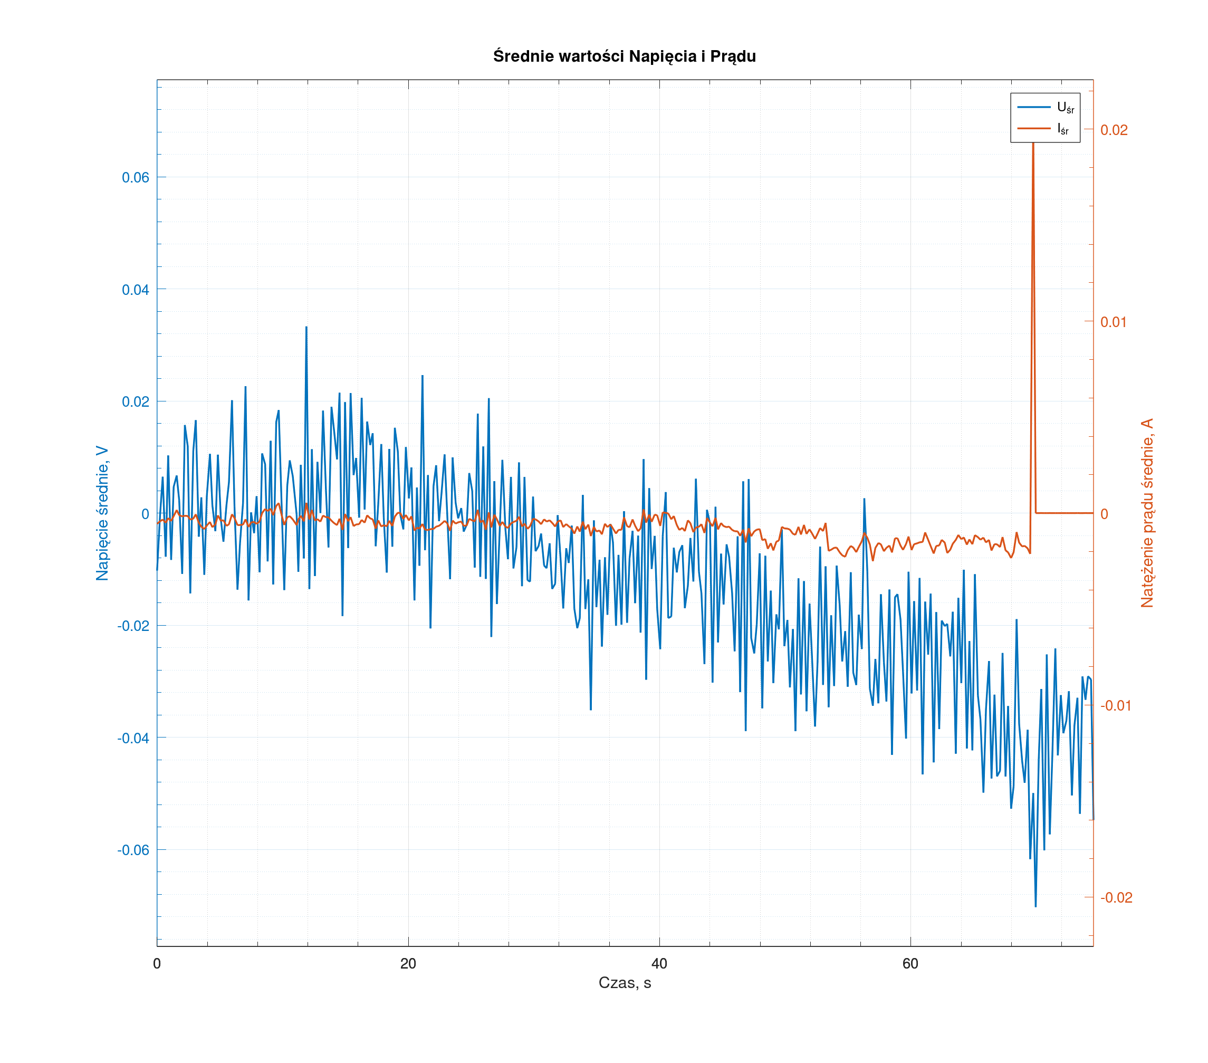
v1.0/pomiary/Pomiary urzadzen/Grid/Odkurzacz 1/Odkurzacz 1_Srednie_Symetryczne.png
