martinrybka2000/openacme-pfm/v1.0/pomiary/Pomiary urzadzen/Grid/Odkurzacz 2/Odkurzacz 2_I_rms.png

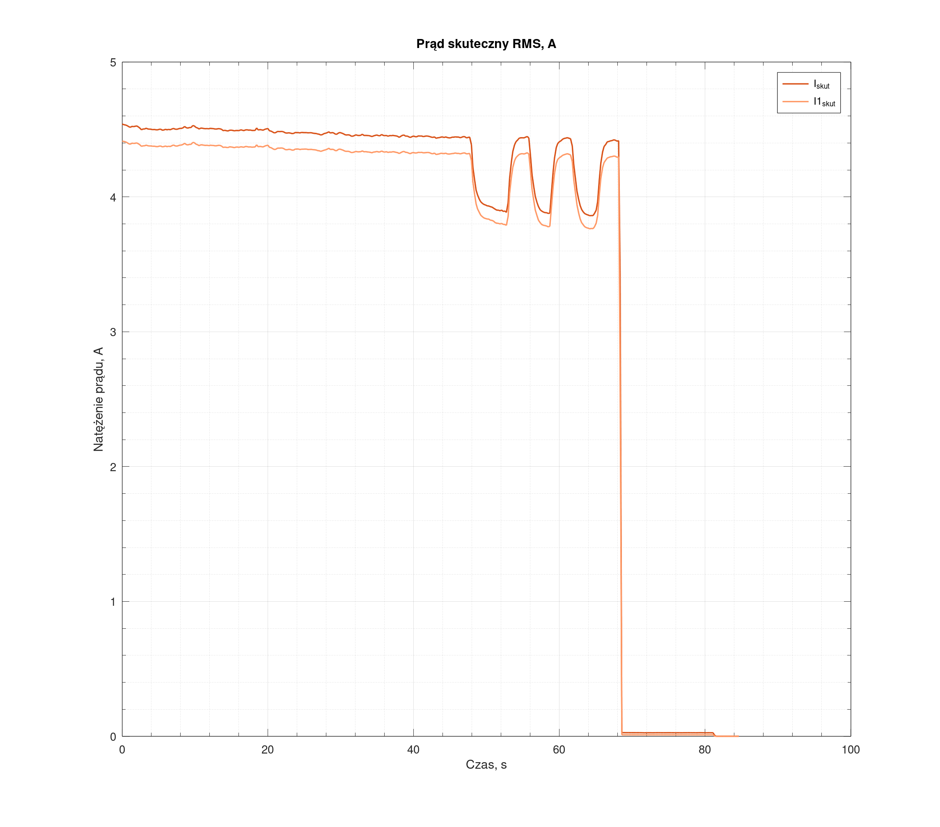
v1.0/pomiary/Pomiary urzadzen/Grid/Odkurzacz 2/Odkurzacz 2_I_rms.png
