martinrybka2000/openacme-pfm/v1.0/pomiary/Pomiary urzadzen/Grid/Odkurzacz 2/Odkurzacz 2_Srednie_Symetryczne.png

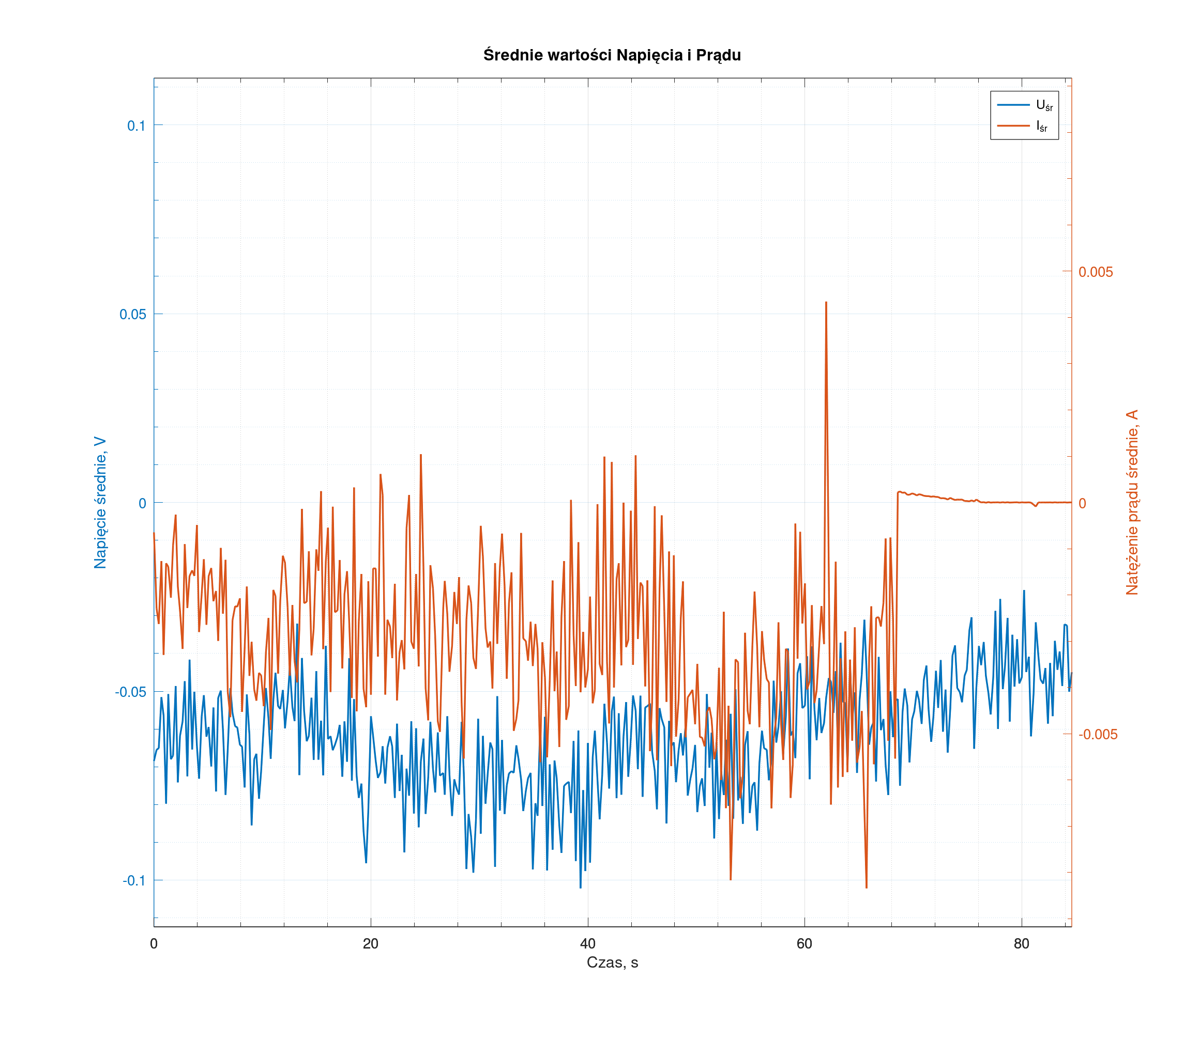
v1.0/pomiary/Pomiary urzadzen/Grid/Odkurzacz 2/Odkurzacz 2_Srednie_Symetryczne.png
