martinrybka2000/openacme-pfm/v1.0/pomiary/Pomiary urzadzen/Grid/Odkurzacz 2/odkurzacz_duzy.png

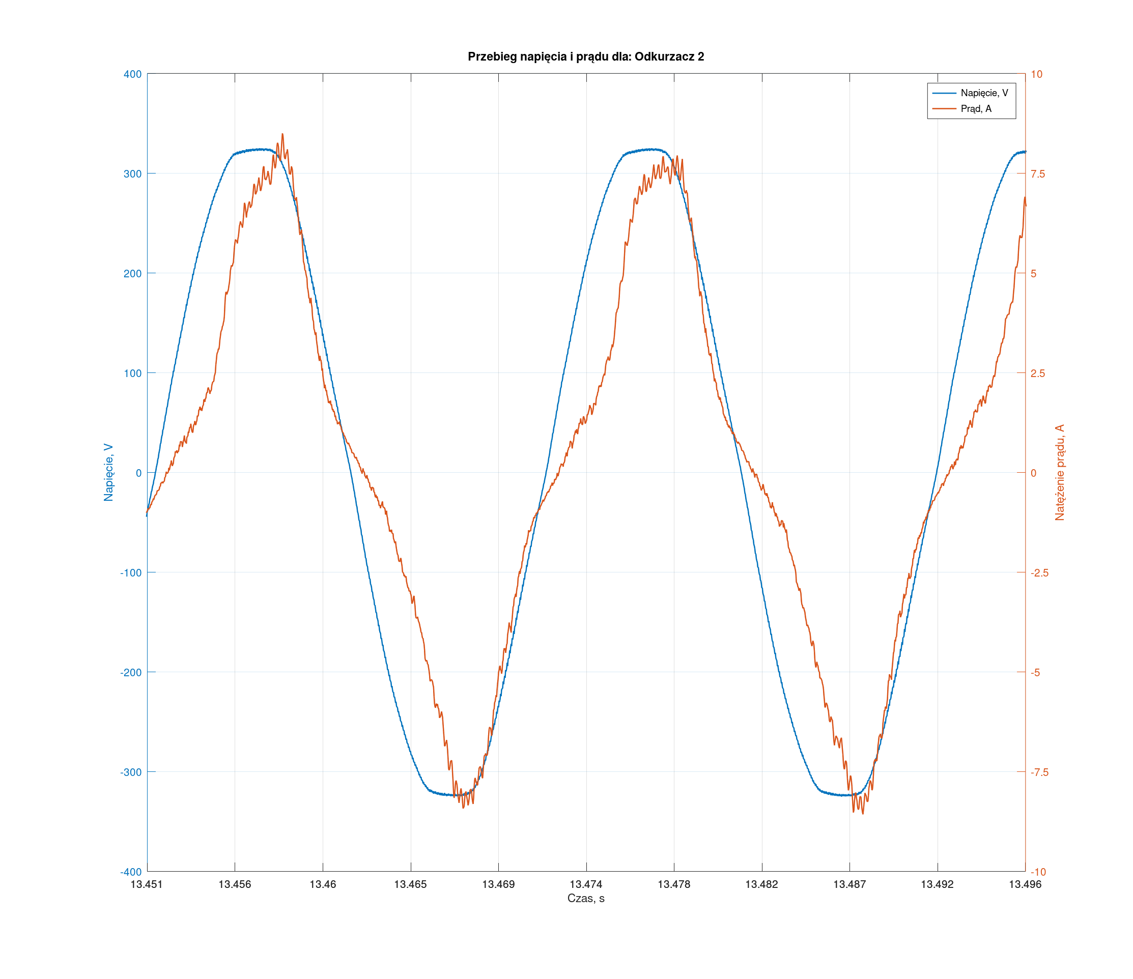
v1.0/pomiary/Pomiary urzadzen/Grid/Odkurzacz 2/odkurzacz_duzy.png
