martinrybka2000/openacme-pfm/v1.0/pomiary/Pomiary urzadzen/Grid/Wyżynarka/Wyzynarka.png

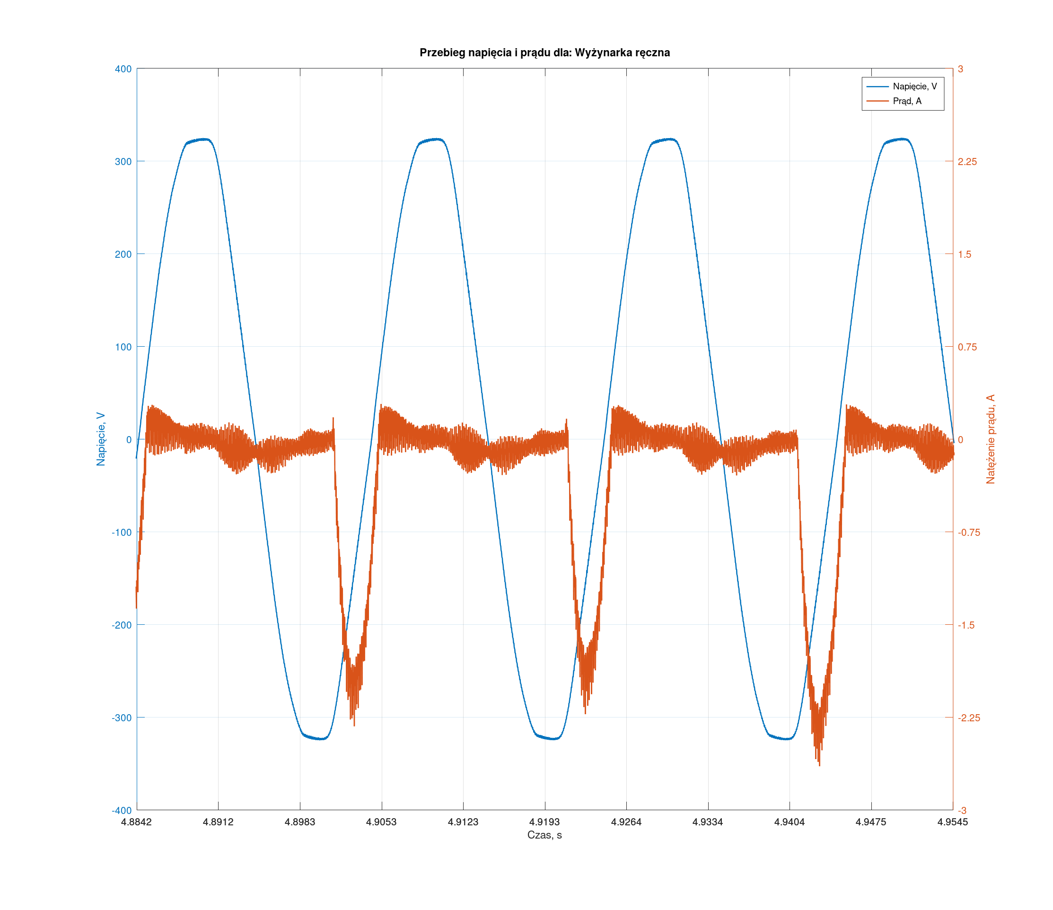
v1.0/pomiary/Pomiary urzadzen/Grid/Wyżynarka/Wyzynarka.png
