martinrybka2000/openacme-pfm/v1.0/pomiary/Pomiary urzadzen/Grid/Wyżynarka/Wyżynarka_Peak.png

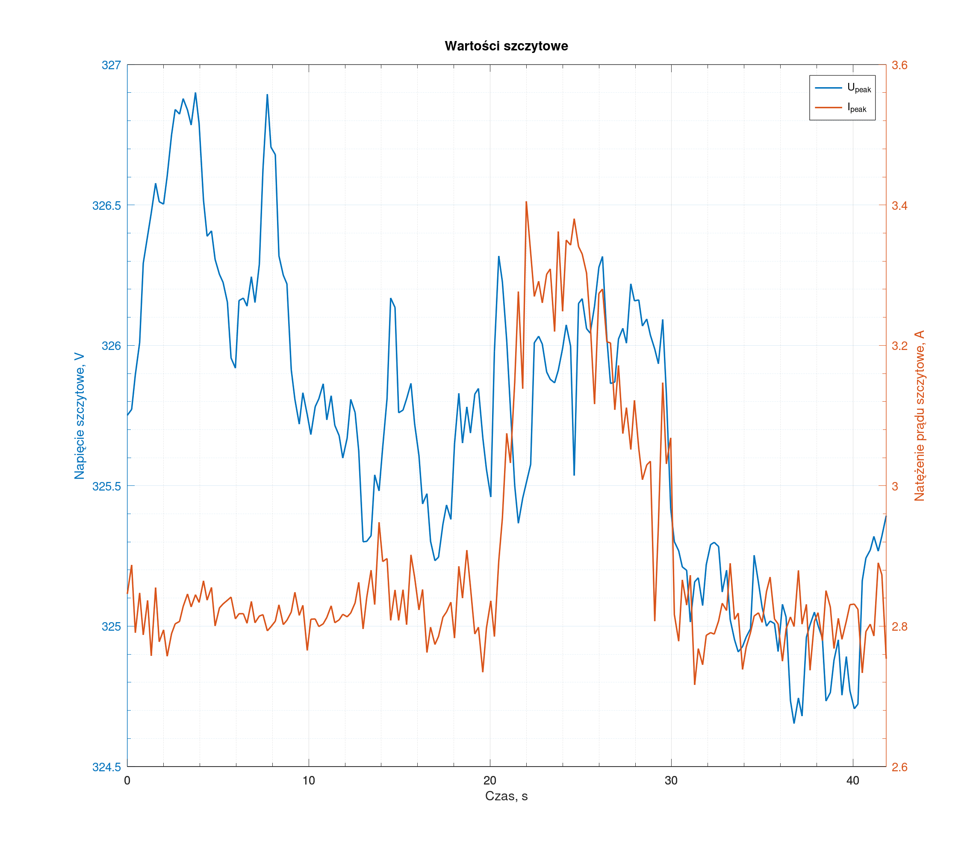
v1.0/pomiary/Pomiary urzadzen/Grid/Wyżynarka/Wyżynarka_Peak.png
