martinrybka2000/openacme-pfm/v1.0/pomiary/Pomiary urzadzen/Grid/Wyżynarka/Wyżynarka_Srednie_Symetryczne.png

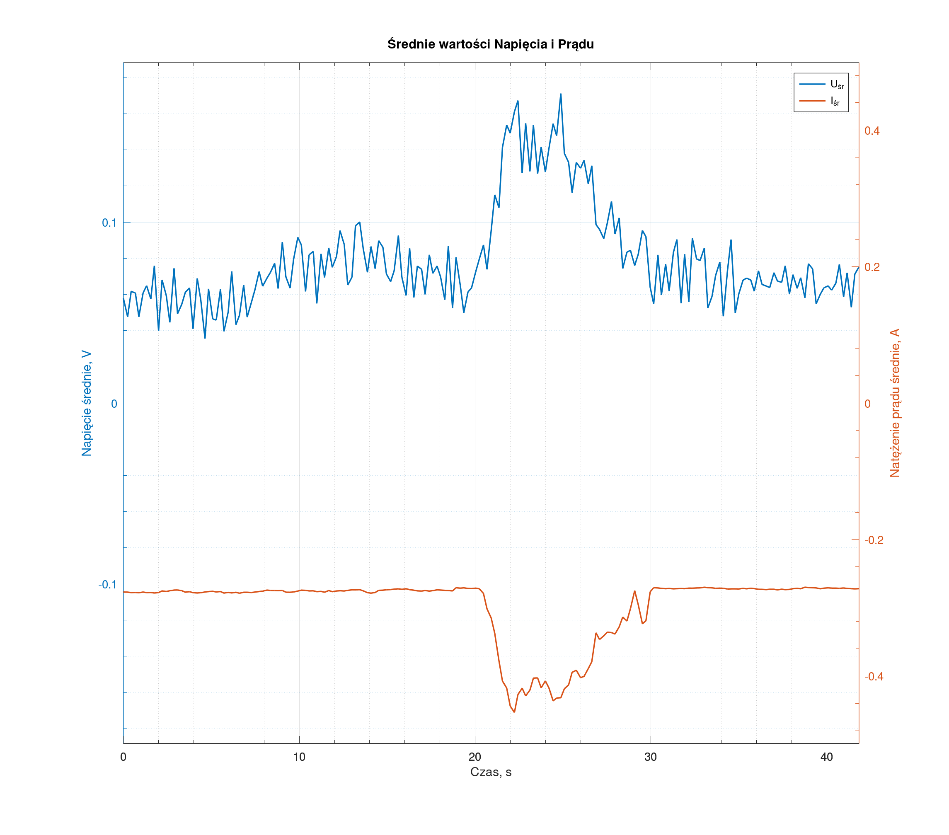
v1.0/pomiary/Pomiary urzadzen/Grid/Wyżynarka/Wyżynarka_Srednie_Symetryczne.png
