martinrybka2000/openacme-pfm/v1.0/pomiary/Pomiary urzadzen/Grid/zarowka_LED.png

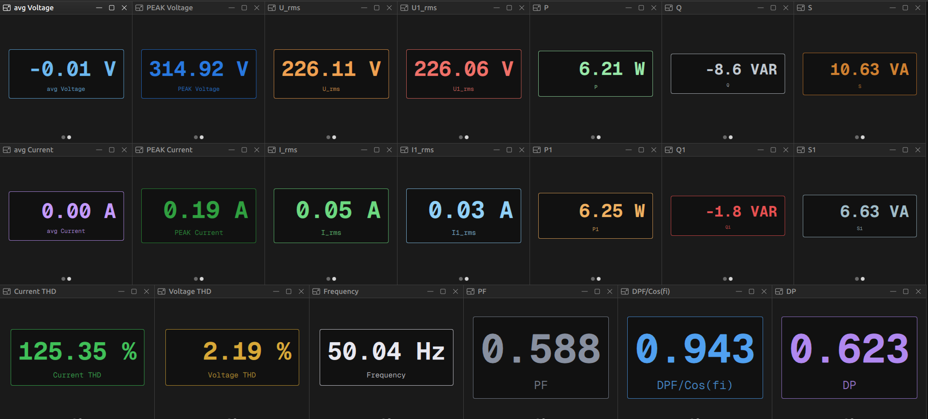
v1.0/pomiary/Pomiary urzadzen/Grid/zarowka_LED.png
