martinrybka2000/openacme-pfm/v1.0/pomiary/Pomiary urzadzen/Grid_dom/Dzien, mieszkanie/Dzien, mieszkanie_Moc_Calkowita.png

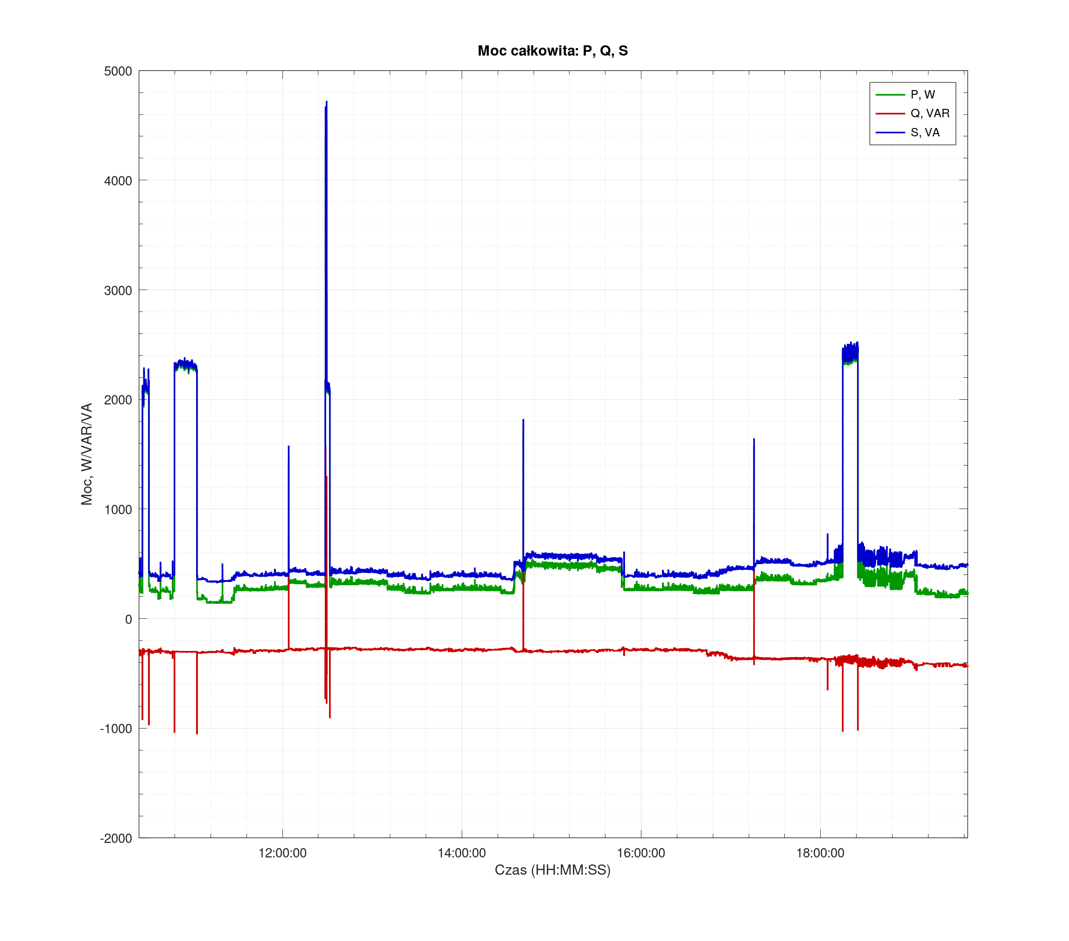
v1.0/pomiary/Pomiary urzadzen/Grid_dom/Dzien, mieszkanie/Dzien, mieszkanie_Moc_Calkowita.png
