martinrybka2000/openacme-pfm/v1.0/pomiary/Pomiary urzadzen/Grid_dom/Dzien, mieszkanie/Dzien, mieszkanie_Peak.png

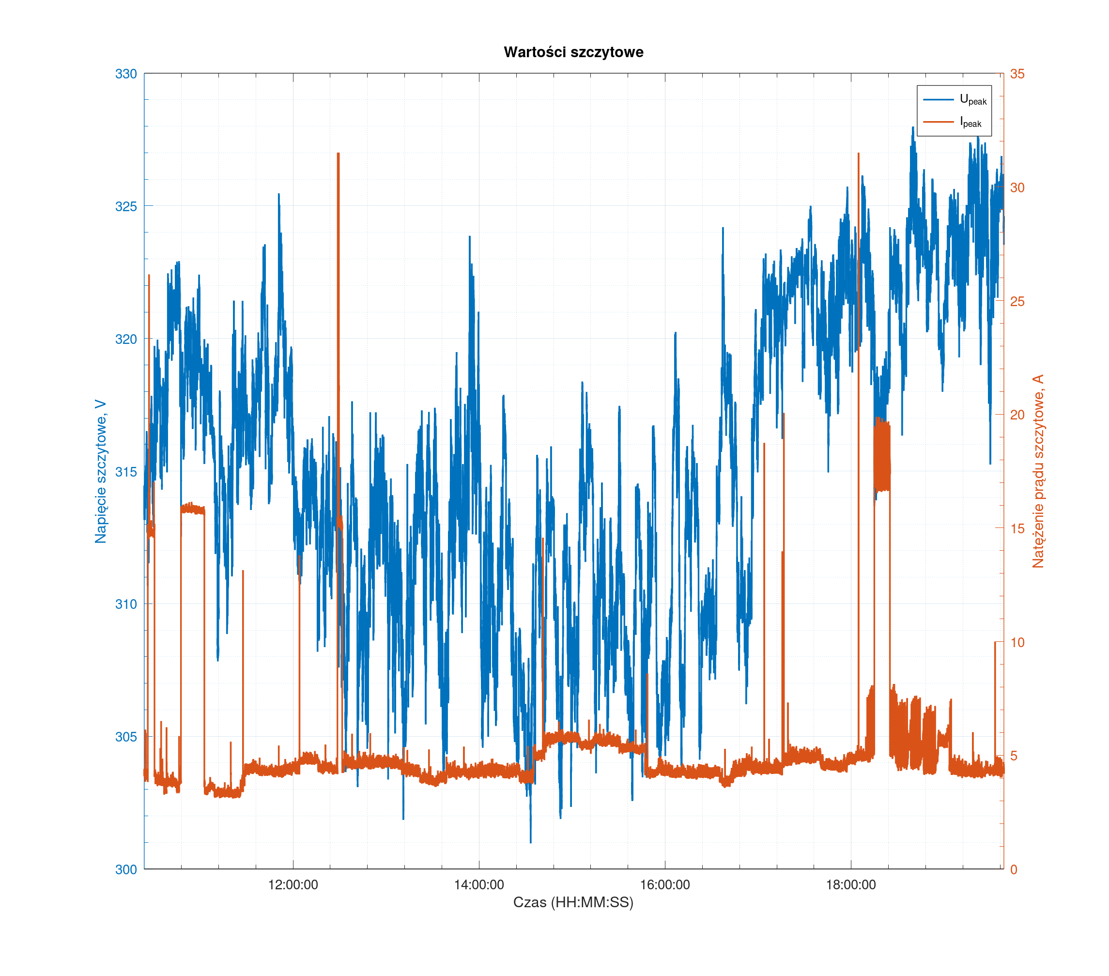
v1.0/pomiary/Pomiary urzadzen/Grid_dom/Dzien, mieszkanie/Dzien, mieszkanie_Peak.png
