martinrybka2000/openacme-pfm/v1.0/pomiary/Pomiary urzadzen/Grid_dom/Noc, mieszkanie/Noc, mieszkanie_Moc_Pelna.png

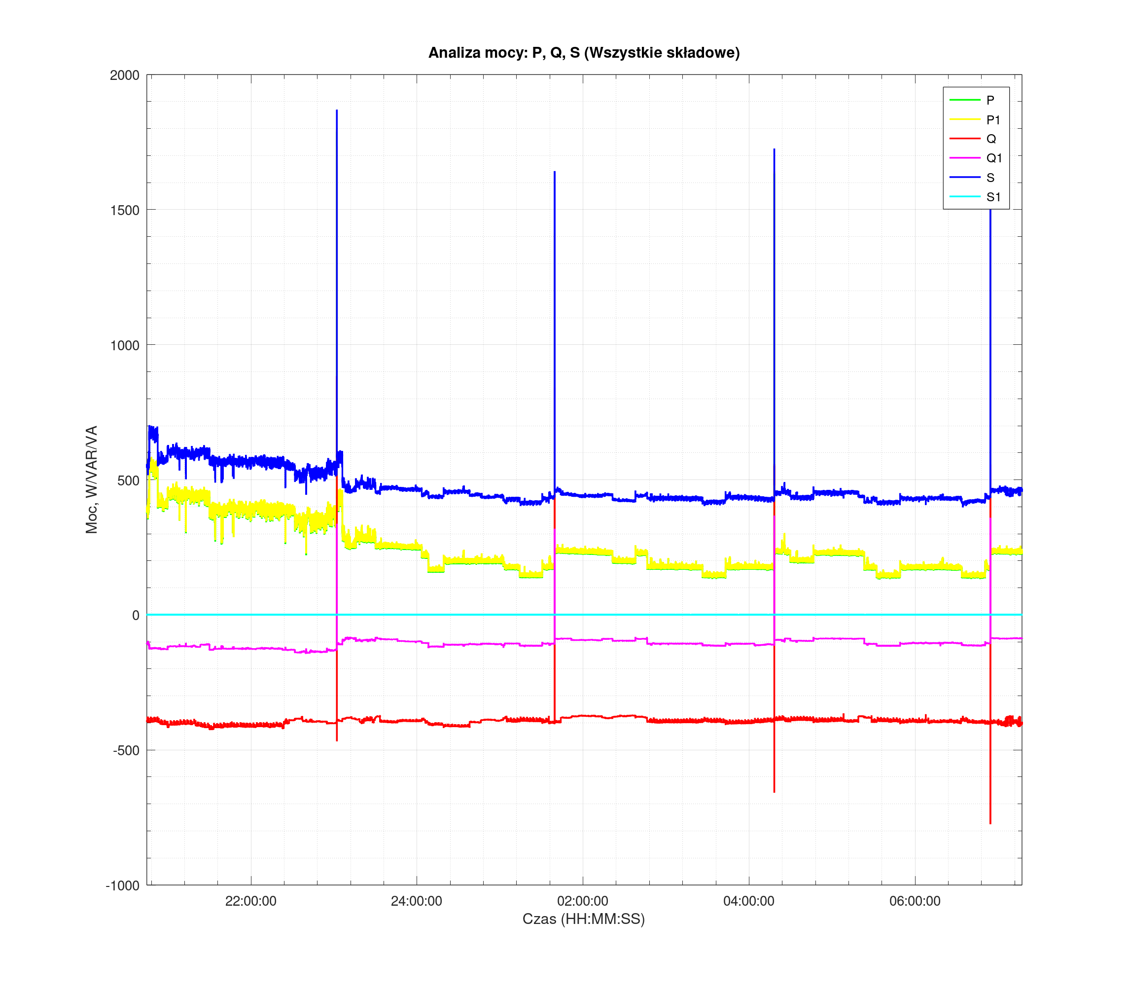
v1.0/pomiary/Pomiary urzadzen/Grid_dom/Noc, mieszkanie/Noc, mieszkanie_Moc_Pelna.png
