martinrybka2000/openacme-pfm/v1.0/pomiary/Pomiary urzadzen/Grid_dom/Noc, mieszkanie/Noc, mieszkanie_Srednie_Symetryczne.png

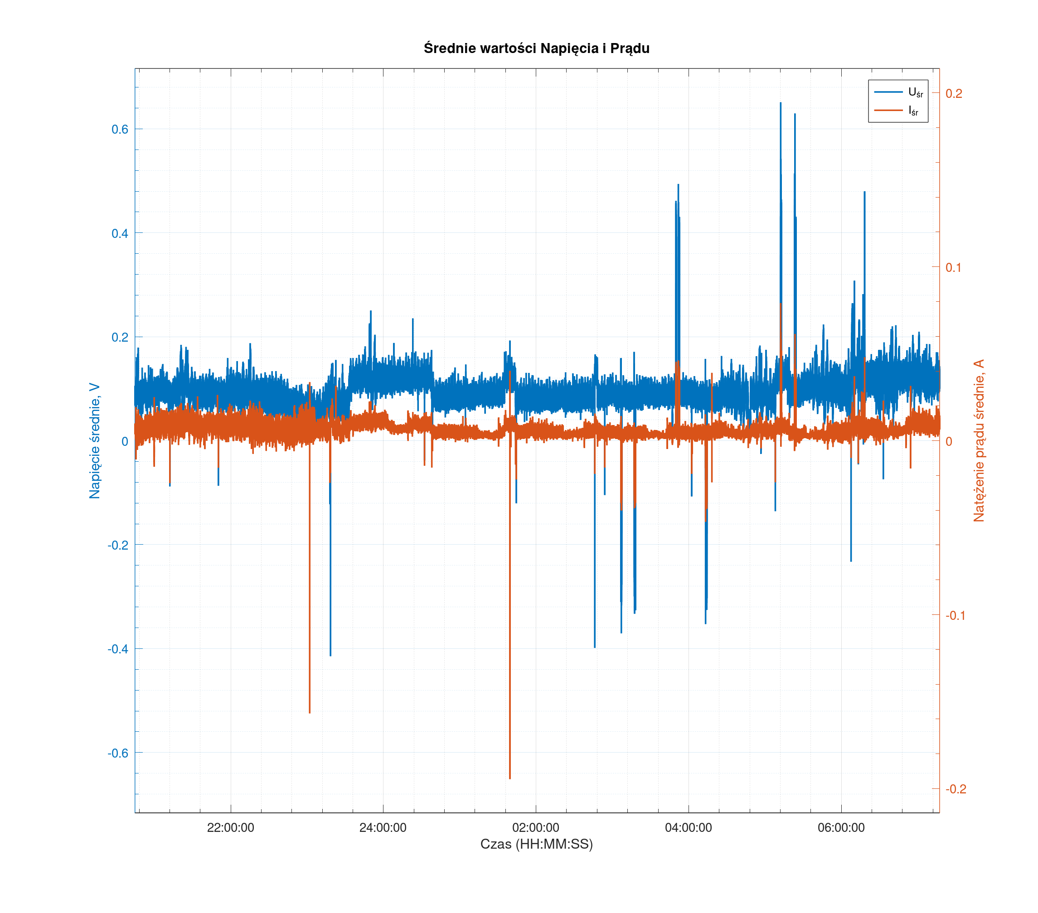
v1.0/pomiary/Pomiary urzadzen/Grid_dom/Noc, mieszkanie/Noc, mieszkanie_Srednie_Symetryczne.png
