martinrybka2000/openacme-pfm/v1.0/pomiary/Pomiary urzadzen/Grid_dom/Rano krotkie, mieszkanie/Rano krotkie, mieszkanie_Czestotliwosc.png

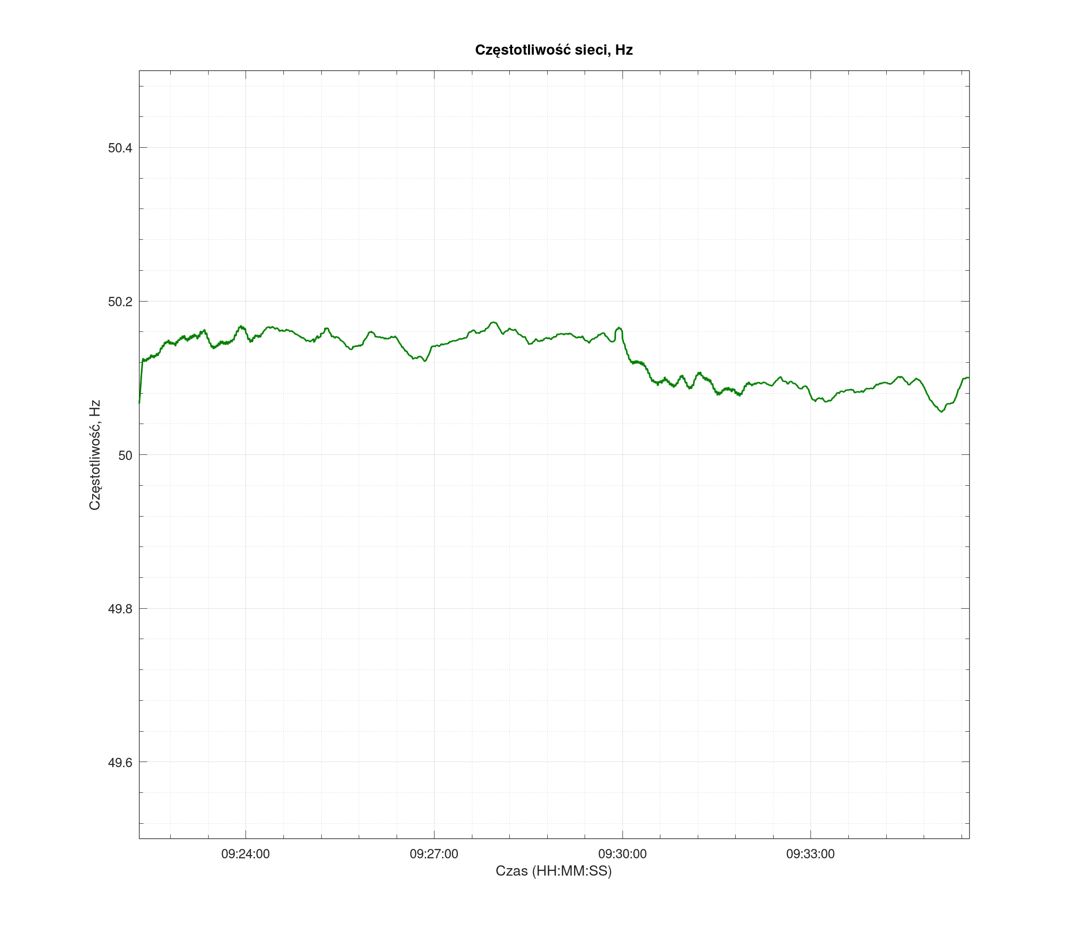
v1.0/pomiary/Pomiary urzadzen/Grid_dom/Rano krotkie, mieszkanie/Rano krotkie, mieszkanie_Czestotliwosc.png
