martinrybka2000/openacme-pfm/v1.0/pomiary/Pomiary urzadzen/Grid_dom/Rano krotkie, mieszkanie/Rano krotkie, mieszkanie_Peak.png

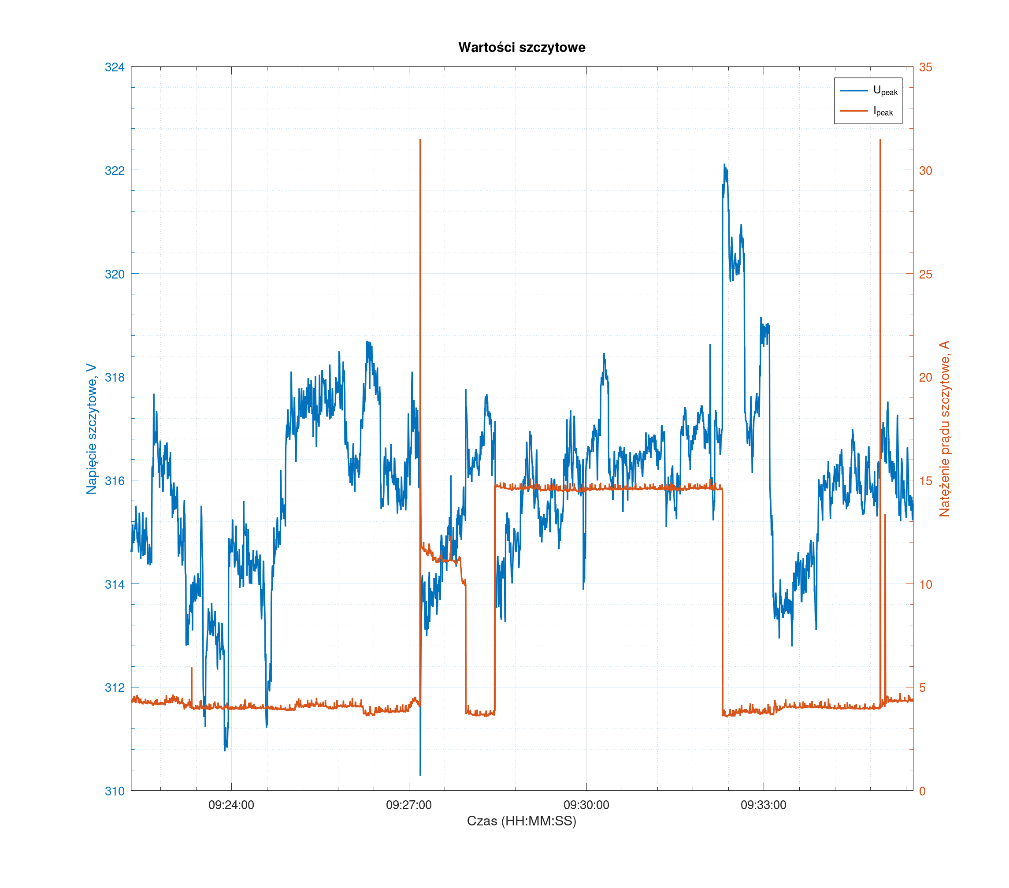
v1.0/pomiary/Pomiary urzadzen/Grid_dom/Rano krotkie, mieszkanie/Rano krotkie, mieszkanie_Peak.png
