martinrybka2000/openacme-pfm/v1.0/pomiary/Pomiary urzadzen/Grid_dom/Rano krotkie, mieszkanie/Rano krotkie, mieszkanie_Srednie_Symetryczne.png

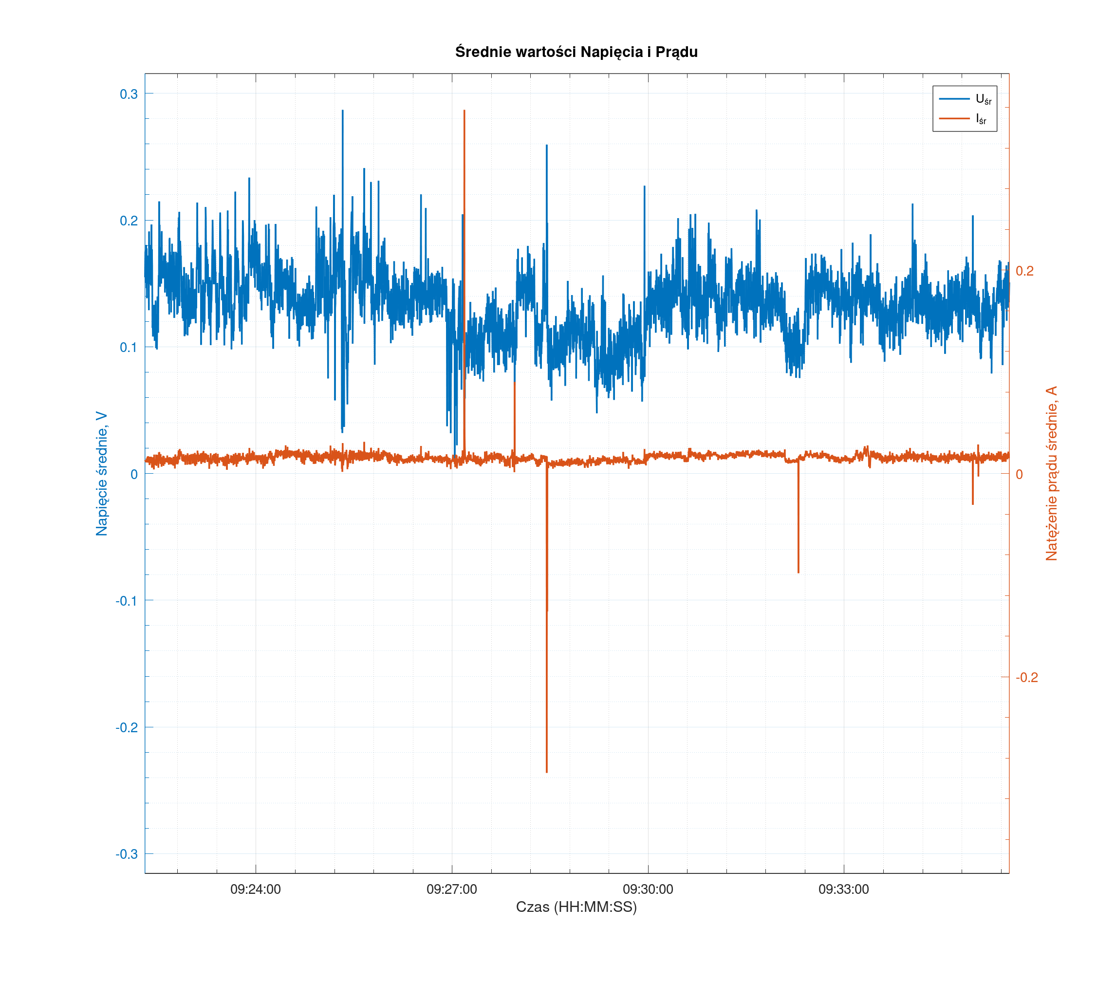
v1.0/pomiary/Pomiary urzadzen/Grid_dom/Rano krotkie, mieszkanie/Rano krotkie, mieszkanie_Srednie_Symetryczne.png
