martinrybka2000/openacme-pfm/v1.0/pomiary/Pomiary urzadzen/Grid_dom/Wieczor 3h, mieszkanie/Wieczor 3h, mieszkanie_Srednie_Symetryczne.png

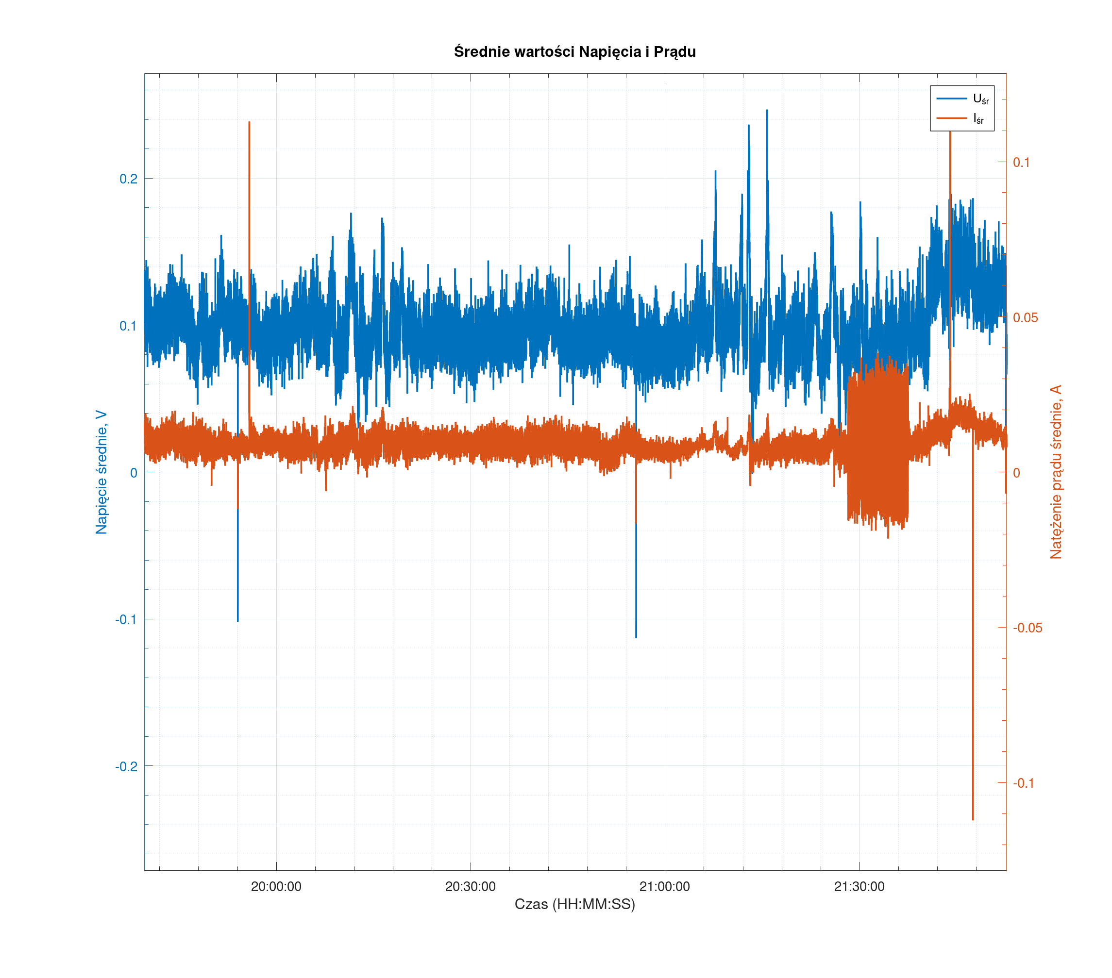
v1.0/pomiary/Pomiary urzadzen/Grid_dom/Wieczor 3h, mieszkanie/Wieczor 3h, mieszkanie_Srednie_Symetryczne.png
