martinrybka2000/openacme-pfm/v1.0/pomiary/Pomiary urzadzen/Raw/grzalka.png

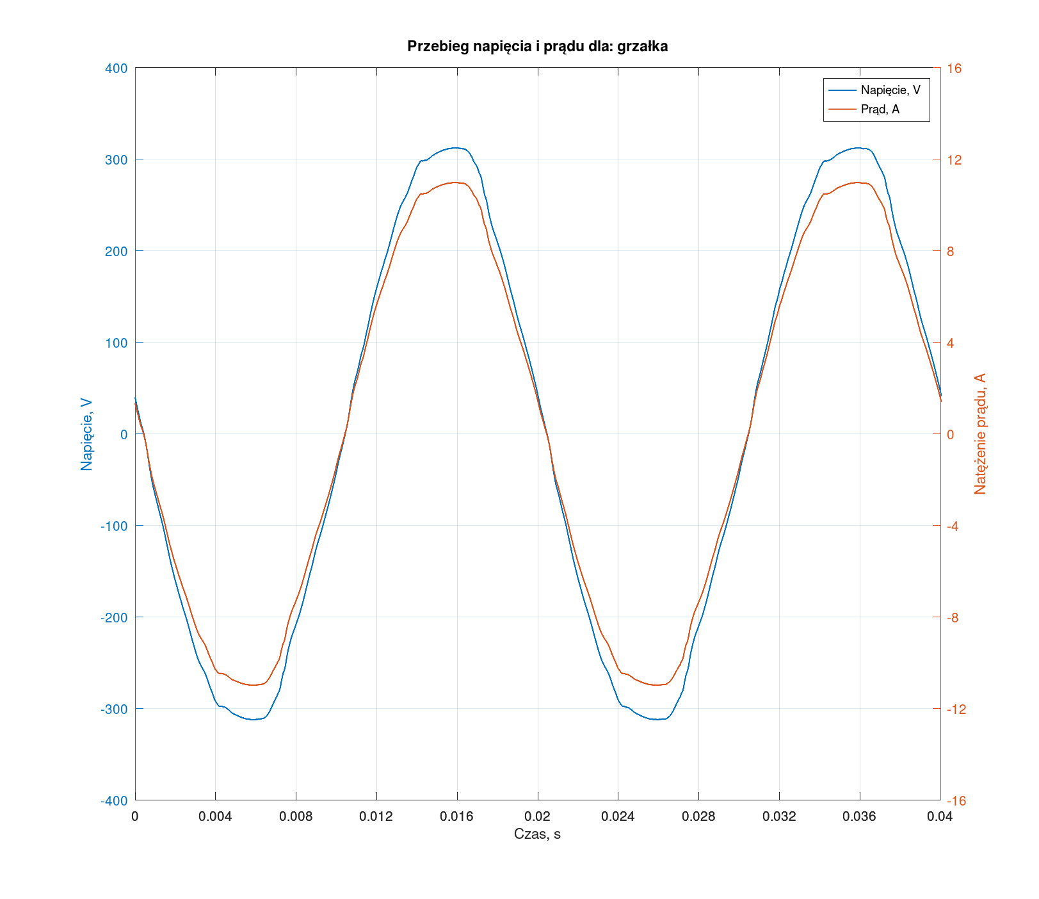
v1.0/pomiary/Pomiary urzadzen/Raw/grzalka.png
