martinrybka2000/openacme-pfm/v1.0/pomiary/Pomiary urzadzen/Raw/kompresor.png

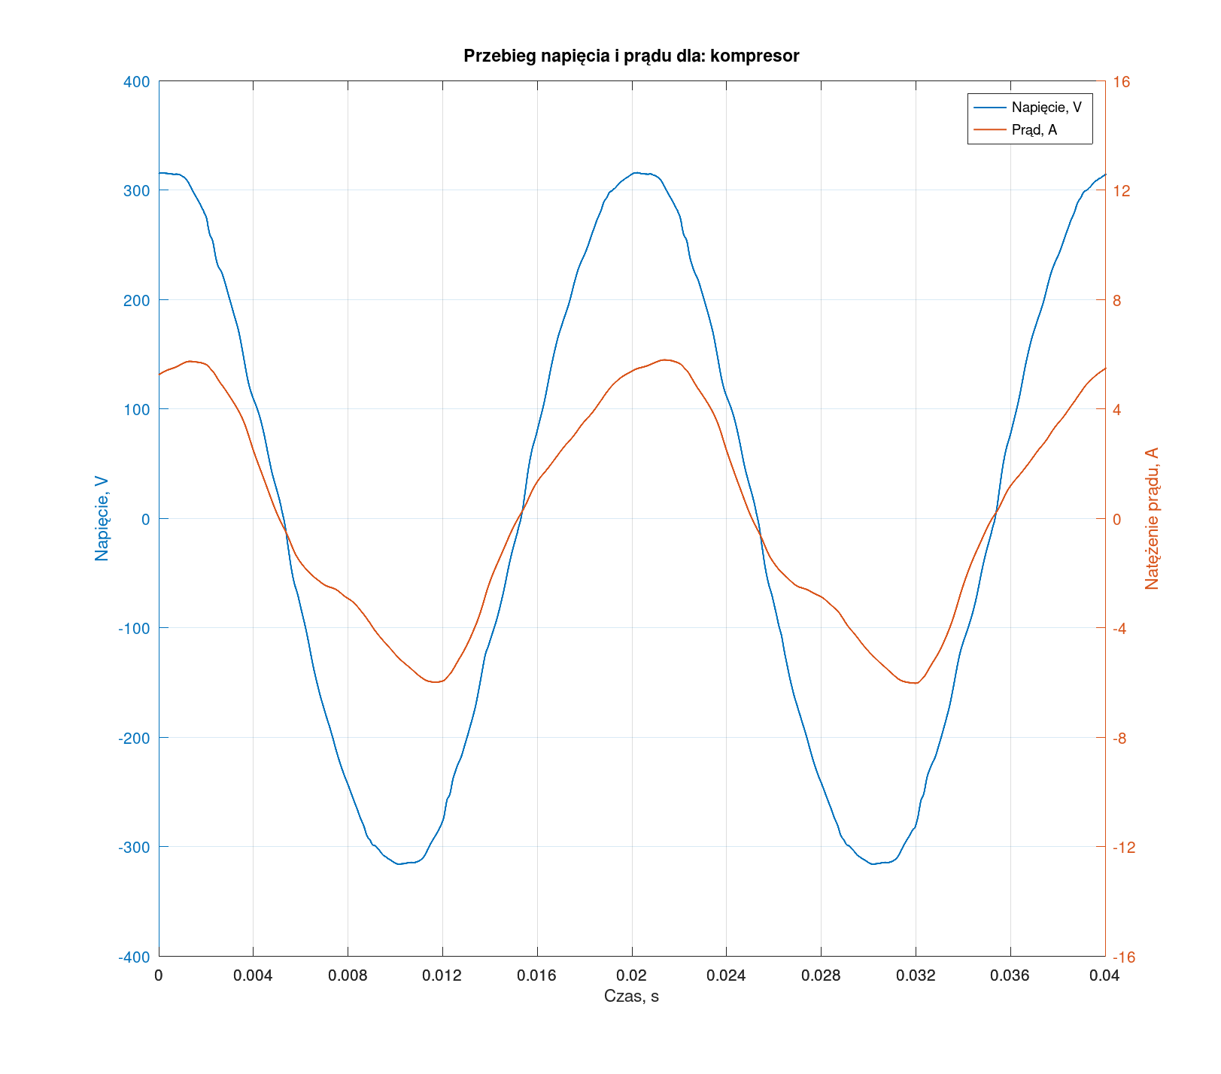
v1.0/pomiary/Pomiary urzadzen/Raw/kompresor.png
