martinrybka2000/openacme-pfm/v1.0/pomiary/Pomiary urzadzen/Raw/Ladowarka_lenovo_off.png

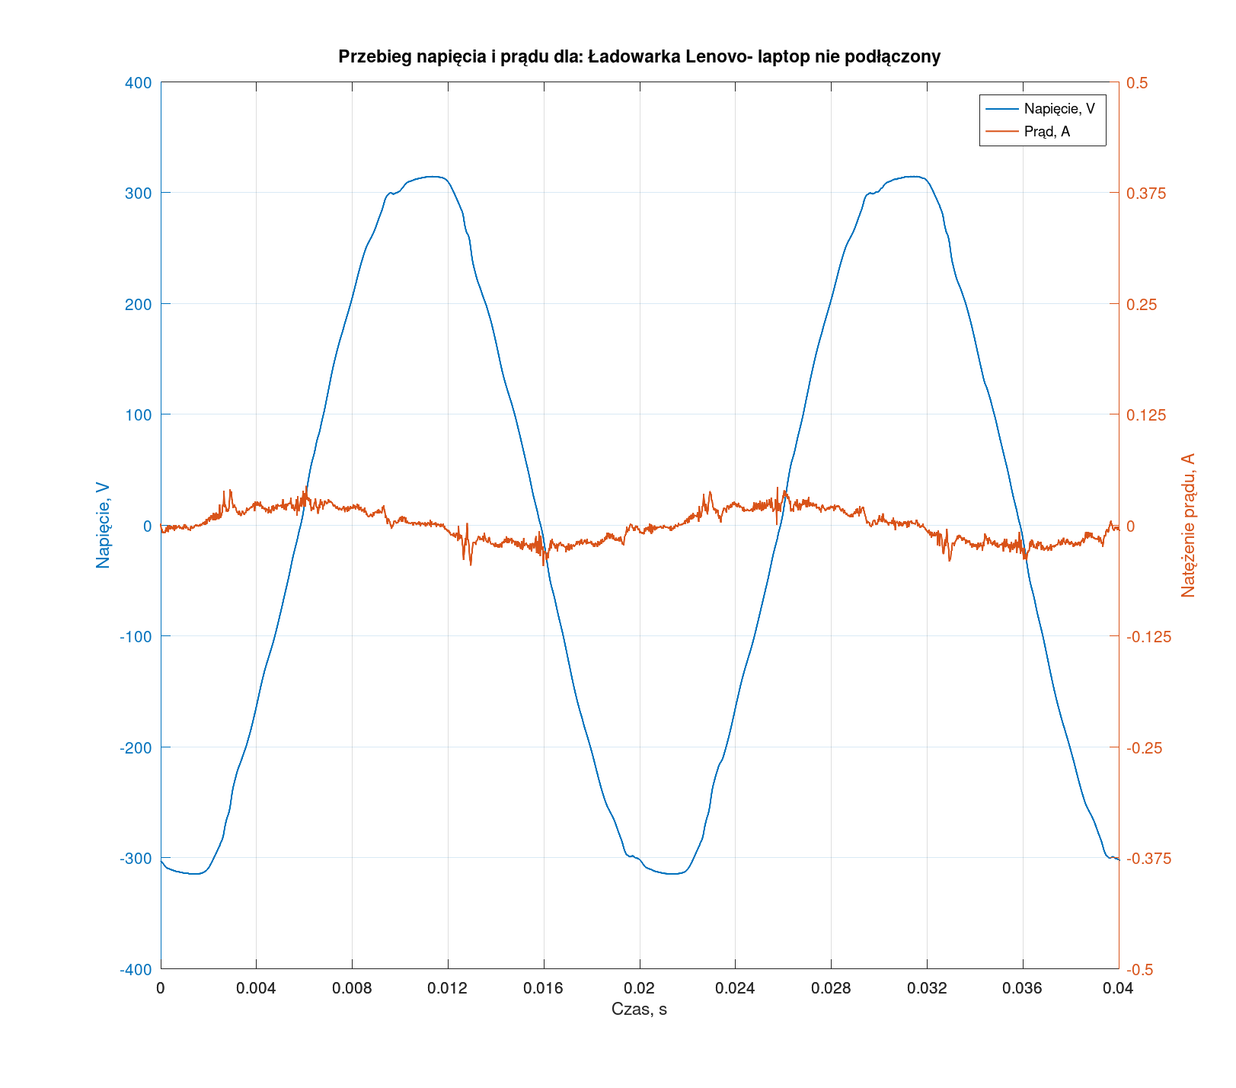
v1.0/pomiary/Pomiary urzadzen/Raw/Ladowarka_lenovo_off.png
