martinrybka2000/openacme-pfm/v1.0/pomiary/Pomiary urzadzen/Raw/Ladowarka_lenovo_on.png

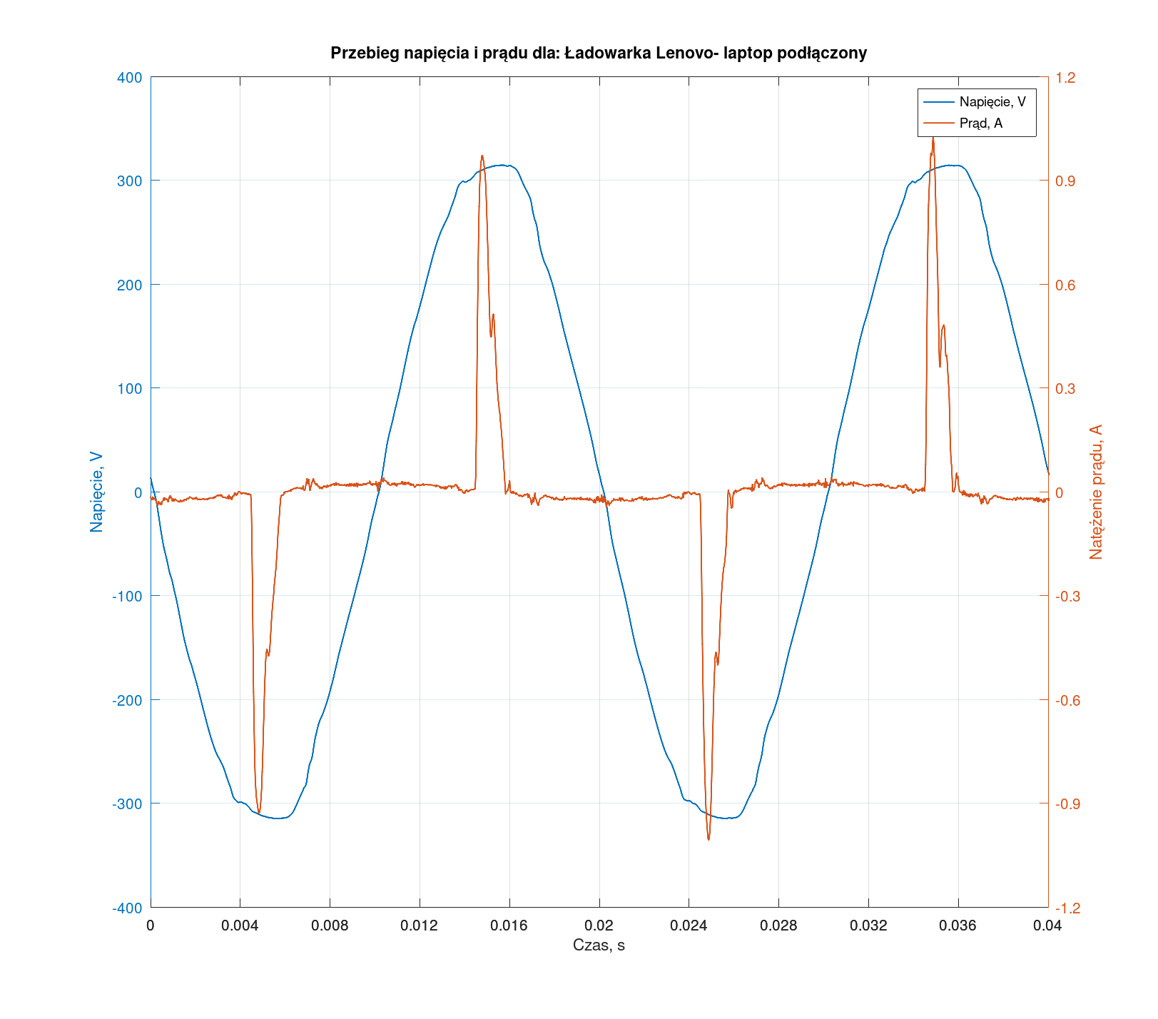
v1.0/pomiary/Pomiary urzadzen/Raw/Ladowarka_lenovo_on.png
