martinrybka2000/openacme-pfm/v1.0/pomiary/Pomiary urzadzen/Raw/ladowarka_telefon_2.png

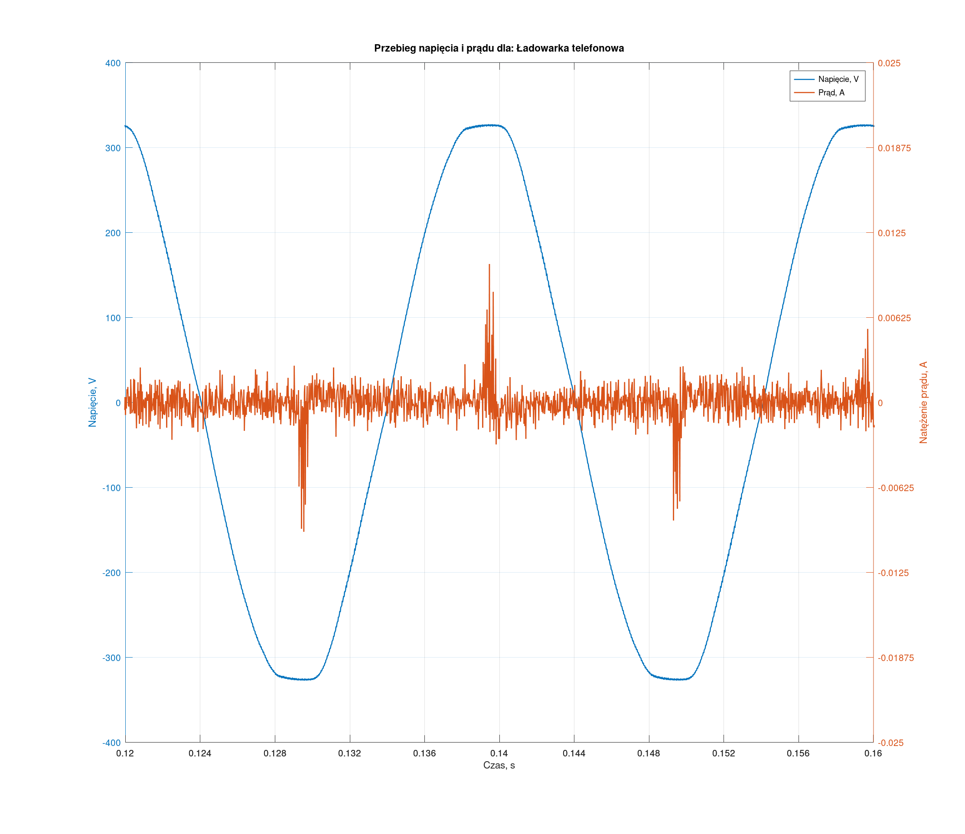
v1.0/pomiary/Pomiary urzadzen/Raw/ladowarka_telefon_2.png
