martinrybka2000/openacme-pfm/v1.0/pomiary/Pomiary urzadzen/Raw/lampka_lozkowa.png

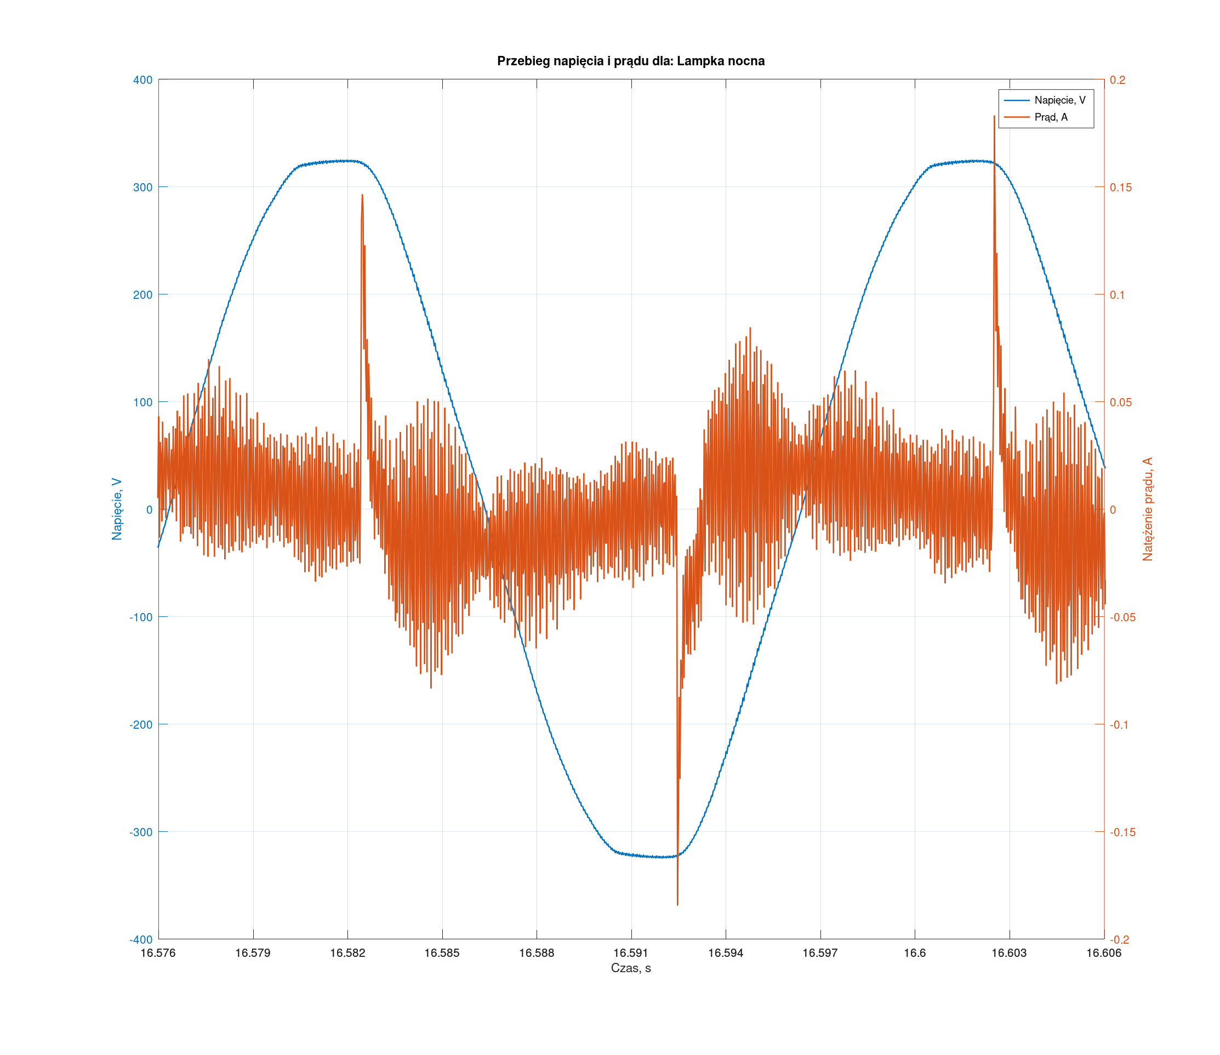
v1.0/pomiary/Pomiary urzadzen/Raw/lampka_lozkowa.png
