martinrybka2000/openacme-pfm/v1.0/pomiary/Pomiary urzadzen/Raw/odkurzacz_maly.png

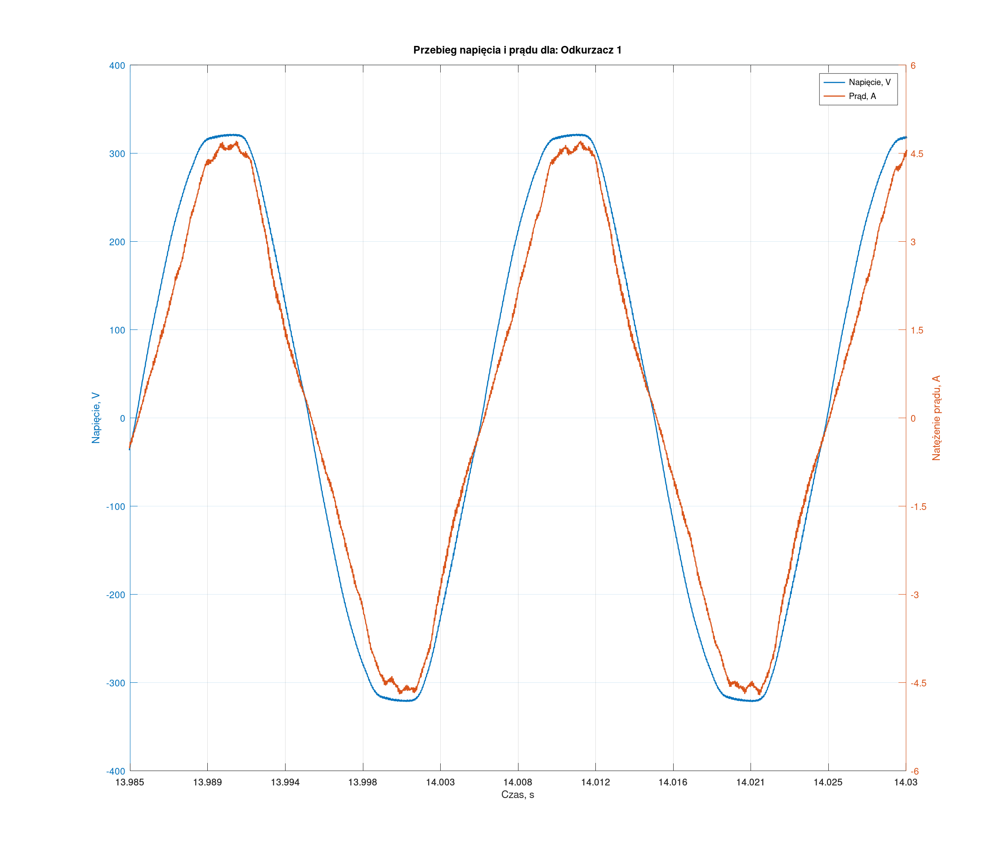
v1.0/pomiary/Pomiary urzadzen/Raw/odkurzacz_maly.png
