martinrybka2000/openacme-pfm/v1.0/pomiary/Pomiary urzadzen/Raw/PC.png

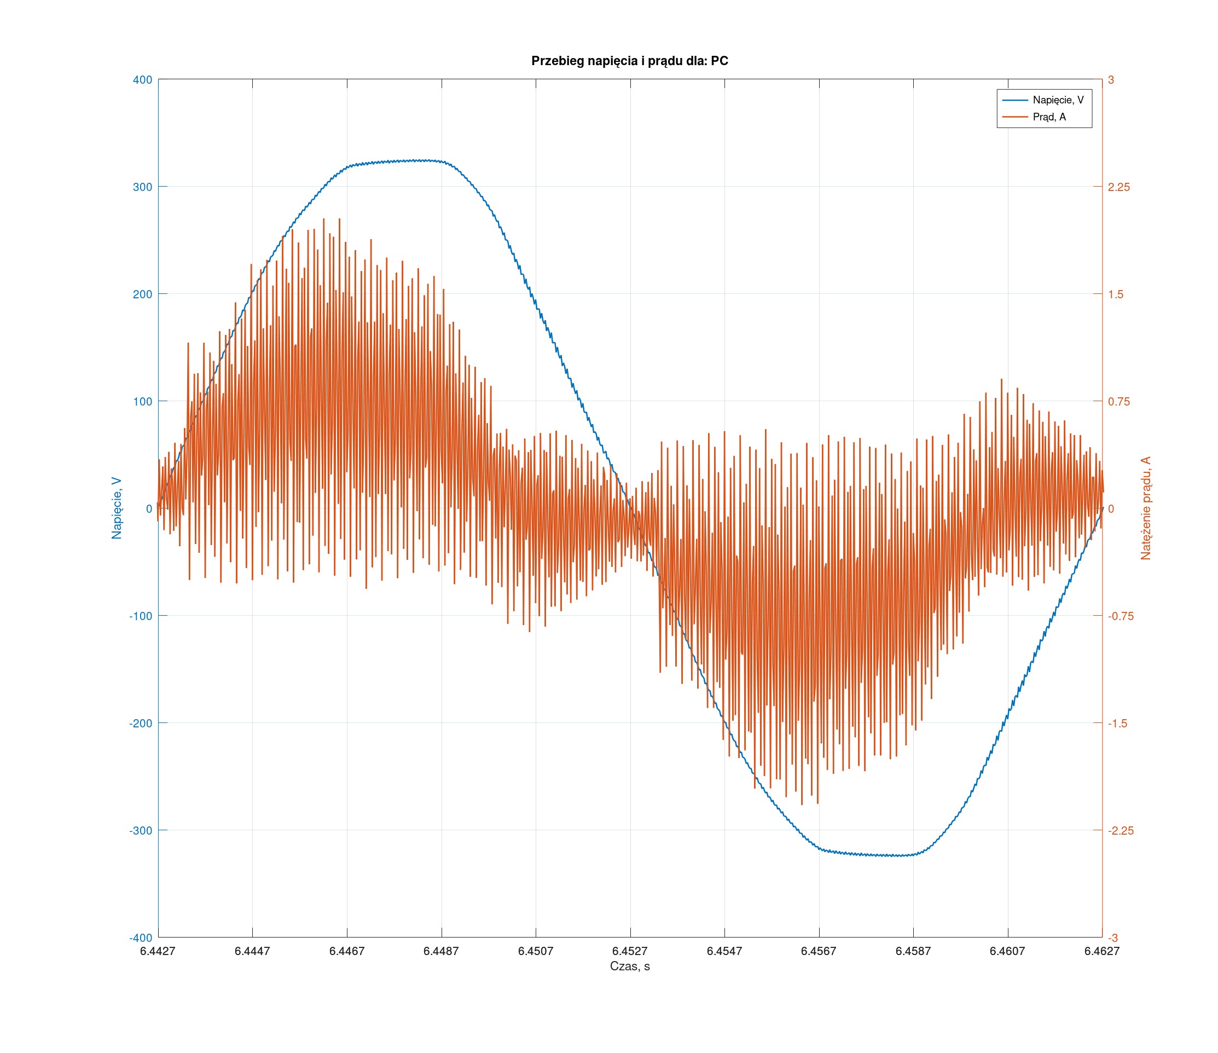
v1.0/pomiary/Pomiary urzadzen/Raw/PC.png
