martinrybka2000/openacme-pfm/v1.0/pomiary/Pomiary urzadzen/Raw/Silnik_50Hz.png

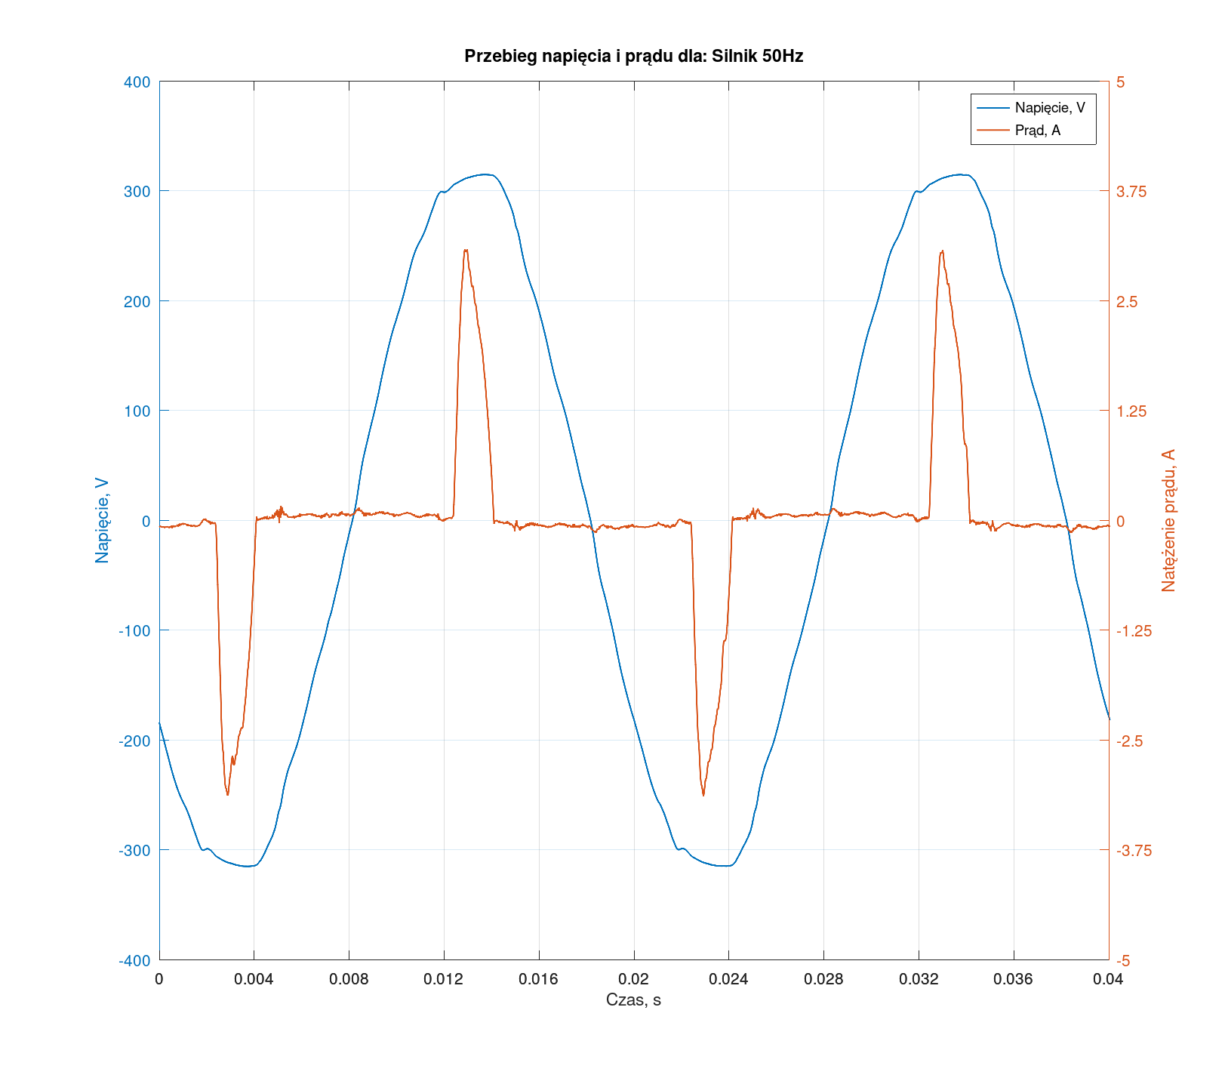
v1.0/pomiary/Pomiary urzadzen/Raw/Silnik_50Hz.png
