martinrybka2000/openacme-pfm/v1.0/pomiary/Pomiary urzadzen/Raw/Swietlowka.png

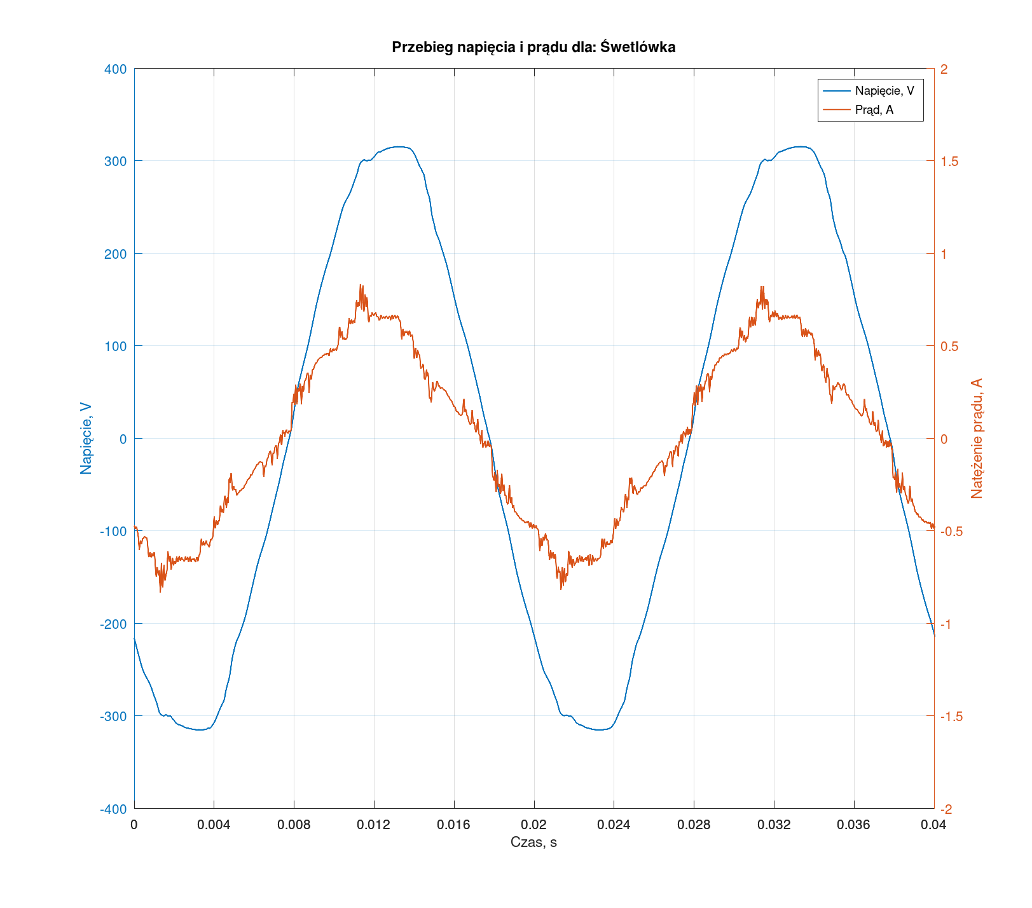
v1.0/pomiary/Pomiary urzadzen/Raw/Swietlowka.png
