martinrybka2000/openacme-pfm/v1.0/pomiary/Pomiary urzadzen/Raw/Wentylator.png

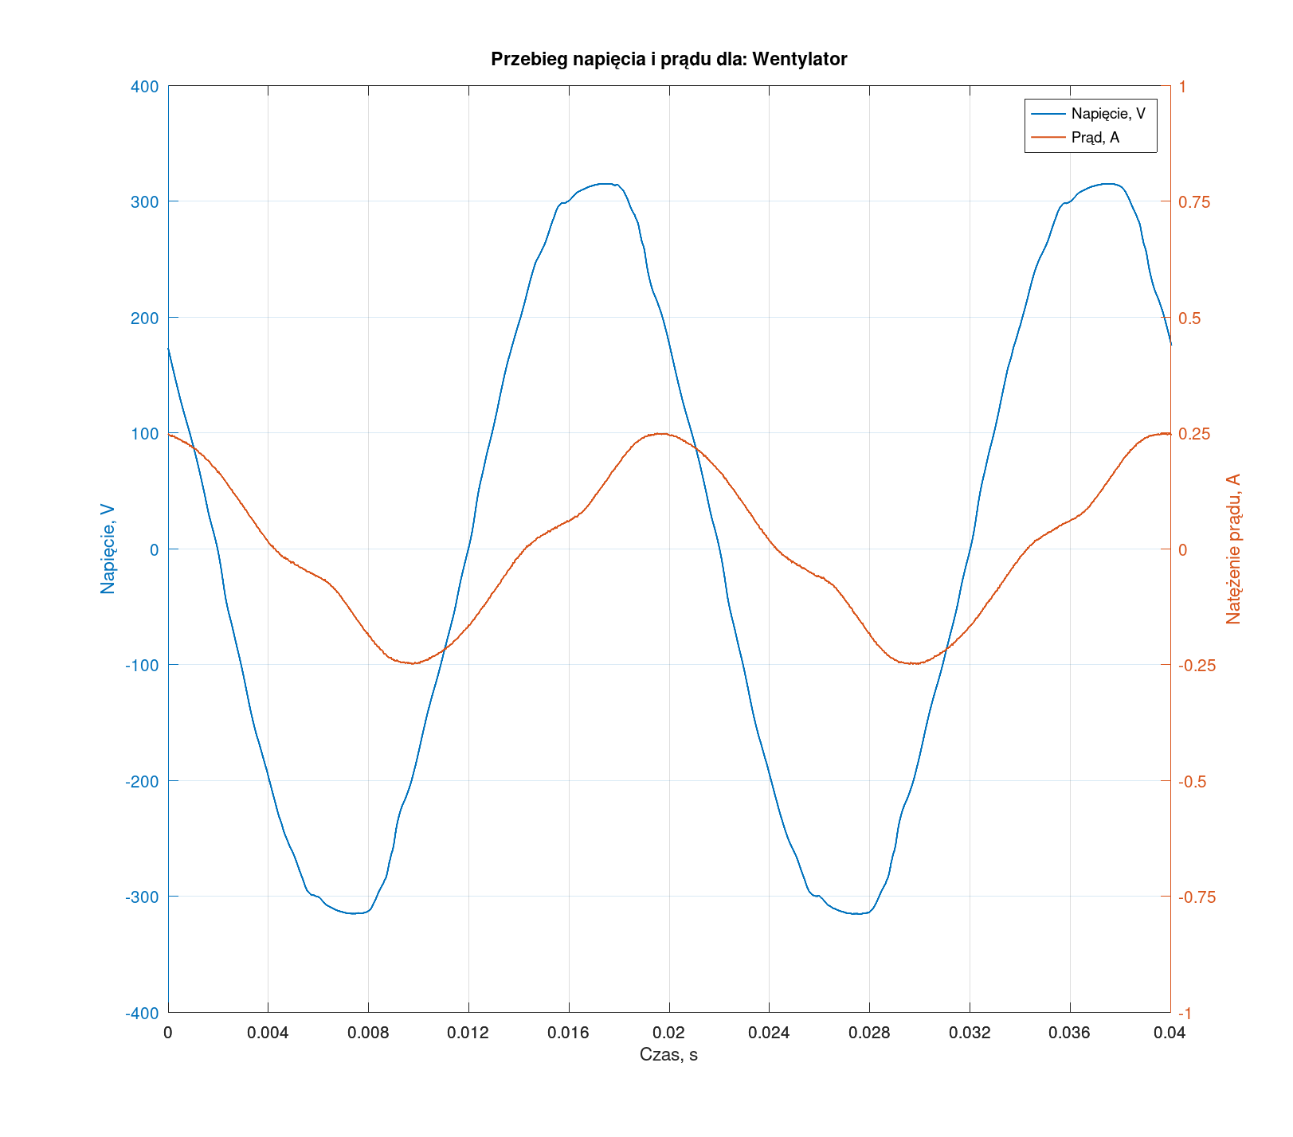
v1.0/pomiary/Pomiary urzadzen/Raw/Wentylator.png
