martinrybka2000/openacme-pfm/v1.0/pomiary/Pomiary urzadzen/Raw/Zarowka_led.png

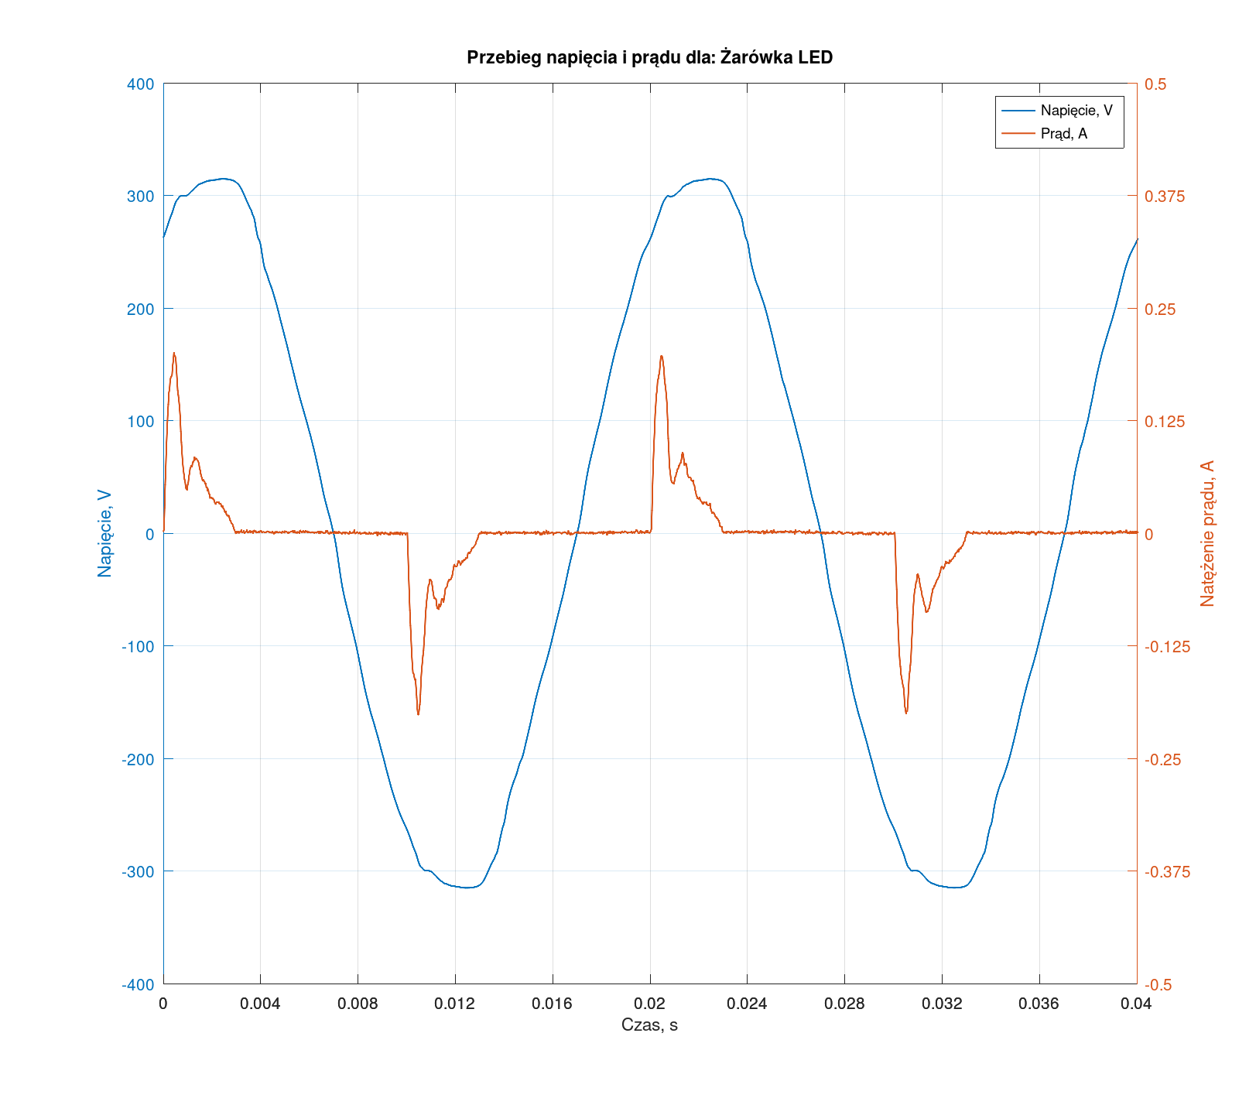
v1.0/pomiary/Pomiary urzadzen/Raw/Zarowka_led.png
