martinrybka2000/openacme-pfm/v1.0/pomiary/Pomiary urzadzen/wentylator_porownanie.png

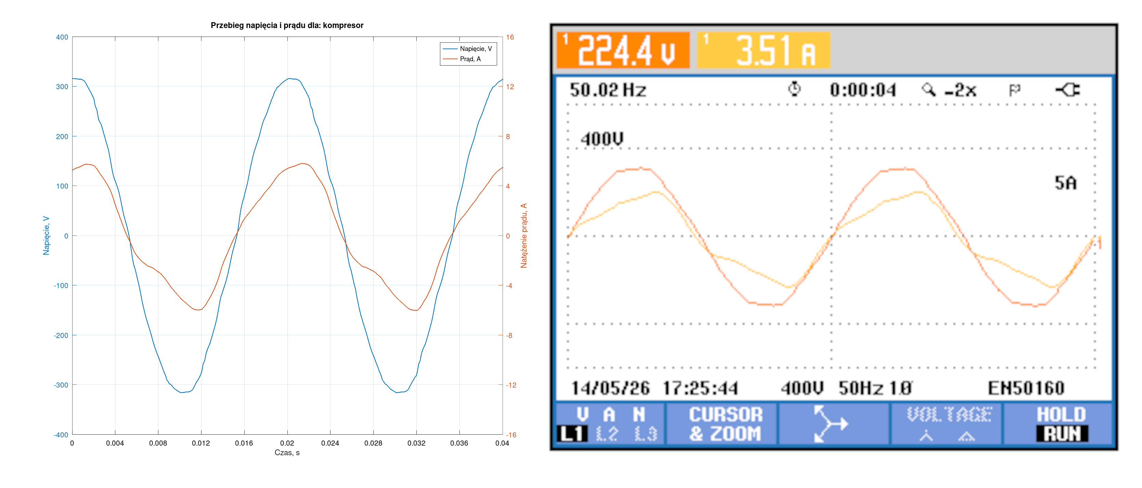
v1.0/pomiary/Pomiary urzadzen/wentylator_porownanie.png
