martinrybka2000/openacme-pfm/v1.0/PCB/BOM.txt

Ref	Qnty	Value	MPN
C1, C2, C3, C4, C5, C7, C9, C10, C11, C12, , C47, C55, C56, C57, C58, C59, C60, C61,	18	100n	On Stan
C24, C27, C36, C38	4	100n	C0603C104K5RACAUTO
C6,	1	4.7u	On Stan
C13, C14,	2	1n, 2KV	8,85342E+11
C16,	1	22n	AC0402KRX7R9BB223
C17,	1	4.7n, 2kV	1210B472K202CT
C18, C42, C43, C44,	4	10p	8,85392E+11
C19,	1	10n	06035C103JAT2A
C20, C25,	2	100n	C3216NP01H104J160AA
C21, C35, C37, C40, C51,	5	1u	12063C105KAT2A
C22,	1	22u	CL31A226MOCLNNC
C23, C26,	2	1u	CGA3E1X7R1E105K080AC
C28, C30, C33, C34,	4	1n	12065C102KAT2A
C29, C31, C32,	3	1n	C0603C102K5RAC7411
C39, C41, C49, C50,	4	2.2u	On Stan
C45, C46, C48,	3	100n	GRM155R61A104KA01J
C52,	1	470p	KGM05ACG1H471JN
C53, C54,	2	5n	08051C502KAT2A
D1,	1	LED_5V	On Stan
D2,	1	LED_RED	On Stan
D3,	1	D_TVS	ESD203B102ELE6327XTMA1
D4,	1	D_TVS	GG040205100N2P
D5,	1	LED_GR	On Stan
D6,	1	LED_USB_PW	On Stan
D7,	1	LED_3V3	On Stan
D8,	1	LED_EFAULT	On Stan
D9, D10,	2	ESDA5V3L	771-PESD36VS2UT215
FB1, FB2,	2	1000Ohm	On Stan
IC1,	1	LAN8740AI-EN-TR	579-LAN8740AI-EN-TR
IC2,	1	SN74LVC14APWRG3	595-SN74LVC14APWRG3
IC3, IC4,	2	PS2802-1-F3-A	On Stan
J1,	1	Boot	On Stan
J2,	1	USB_OTG	538-47590-0001
J3,	1	GRID_term	710-691502710003
J4,	1	5V_term	On Stan
J5,	1	OUT_term	710-691502710003
J6,	1	PROG_DEBUG	On Stan
J7,	1	RJHSE-5380	On Stan
J8,	1	UART_DEBUG	On Stan
J9,	1	OLED_I2C	On Stan
J10,	1	ADC_EXT_CONN	TBC05-03-1-G-G
J11,	1	SPI_EXT	On Stan
J12,	1	OUT_1	On Stan
J13,	1	OUT_2	On Stan
J15,	1	Free_pins	On Stan
J17,	1	Butts_conn	On Stan
Q2,	1	SI3493DDV-T1-GE3	On Stan
R3, R4, R5, R6,	4	75	ERA-2AEB750X
R7,	1	1M	RC2512JK-071ML
R8, R9, R10, R37, R64, R65,	6	49.9	On Stan
R11, R12, R14, R15, R21,	5	715k	667-ERA-6AEB7153V
R13,	1	10k, 0.1%	667-ERA-3AEB103V
R16, R17,	2	94,2	RN73H1JTTD94R2F50
R18, R24, R25, R35,	4	47k	On Stan
R19, R36,	2	1k	On Stan
R20, R27, R28, R31, R41, R69, R70, R71, R72, R73, R80,	11	10k	On Stan
R22, R23,	2	10	RCA060310R0FKEAHP
R26, R29, R30, R32, R33, R34,	6	680	On Stan
R38,	1	12.1k	RT0603FRE0712K1L
R39, R40,	2	33	On Stan
R42, R43, R44, R45, R46, R47, R48, R56, R57, R58, R59,	11	56	RT0402DRE0756RL
R49, R61,	2	1.5k	MCS04020C1501FE000
R50, R51, R52, R53, R54, R55,	6	100	RR0510P-101-D
R60,	1	4.7k	MCS04020C4701FE000
R67, R74, R75, R76,	4	150	On Stan
R_SHUNT2,	1	25m	279-TLRP3A30DR025FTE
RESET1,	1	RESET_SW	On Stan
RV1, RV2, RV3,	3	Varistor	MOVS4032V230
T1,	1	ALANL100X1-DE12DT	815-ALANL100X1DE12DT
U1,	1	STM32H750VBTx	STM32H750VBT6
U2,	1	DSC1001DI1-025.0000	998-1001DI1-025.0000
U3,	1	AMC3306M25DWE	AMC3306M25DWER
U4,	1	TPS259620DDAR	595-TPS259620DDAR
U5,	1	AMC3336	AMC3336DWER
U6,	1	USBLC6-4SC6	511-USBLC6-4SC6Y
U7,	1	TLV1117-33	595-TLV1117LV33DCYR
