martinrybka2000/openacme-pfm/v1.0/Main_ (version 1).ods

Sheet: Main
Learing tabel
Title | Type | Link | Read | Notes
PFC & LLC Ti controllers | Ti site | Link (https://www.ti.com/power-management/pfc-llc.html?keyMatch=PFC&tisearch=universal_search) | TODO
Power Factor Correction (PFC) Circuit Basics | Ti seminar | PDF (https://www.ti.com/lit/ml/zhcp224/zhcp224.pdf?ts=1744789466314) | DONE
How to Meet the Stringent Requirement for Power Factor and iTHD of Three-Phase ac Input system With Vienna PFC | Ti whitepaper | PDF (https://www.ti.com/lit/wp/slaaeo0/slaaeo0.pdf?ts=1744748959679) | TODO
Power Factor Correction (PFC) basics and classifying topologies | Ti Videos | Videos (https://www.ti.com/video/series/power-factor-correction-circuit-basics.html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) | TODO
Digitally controlled high efficiency and high power density PFC circuits | Ti Videos | Videos (https://www.ti.com/video/series/digitally-controlled-high-efficiency-and-high-power-density-pfc-.html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) | TODO
Power factor correct (PFC) basics and design considerations | Ti Videos | Videos (https://www.ti.com/video/series/power-factor-correct--pfc--basics-and-design-considerations.html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) | TODO
Power factor correction using peak current-mode control | Ti Analog Journal paper | PDF (https://www.ti.com/lit/an/slyt838/slyt838.pdf?ts=1744749107774) | DONE
Improve power density with a baby boost converter in a PFC circuit | Ti Analog Journal paper | PDF (https://www.ti.com/lit/an/slyt830/slyt830.pdf?ts=1744749204299) | DONE
How to improve PFC light-load efficiency | Ti Analog Journal paper | PDF (https://www.ti.com/lit/an/slyt785/slyt785.pdf?ts=1744749283813) | DONE
A comparative analysis of topologies for a bridgeless-boost PFC circuit | Ti Analog Journal paper | PDF (https://www.ti.com/lit/an/slyt750/slyt750.pdf?ts=1744749354744) | TODO
Control challenges in a totem-pole PFC | Ti Analog Journal paper | PDF (https://www.ti.com/lit/an/slyt718/slyt718.pdf?ts=1744749377174) | TODO
Increase power factor by digitally compensating for PFC EMI-capacitor reactive current | Ti Analog Journal paper | PDF (https://www.ti.com/lit/an/slyt673/slyt673.pdf?ts=1744749401460) | TODO
How to reduce current spikes at AC zero-crossing for totem-pole PFC | Ti Analog Journal paper | PDF (https://www.ti.com/lit/an/slyt650/slyt650.pdf?ts=1744749407505) | TODO
Design a transition-mode, bridgeless PFC with a standard PFC controller | Ti Analog Journal paper | PDF (https://www.ti.com/lit/an/slyt599/slyt599.pdf?ts=1744749414485) | TODO
AC cycle skipping improves PFC light-load efficiency | Ti Analog Journal paper | PDF (https://www.ti.com/lit/an/slyt585/slyt585.pdf?ts=1744749421217) | DONE
Digital current balancing for an interleaved boost PFC | Ti Analog Journal paper | PDF (https://www.ti.com/lit/an/slyt517/slyt517.pdf?ts=1744749428013) | TODO
UCC28517 100-W PFC power converter with 12-V, 8-W bias supply, Part 1 | Ti Analog Journal paper | PDF (https://www.ti.com/lit/an/slyt097/slyt097.pdf?ts=1744664074590) | TODO
UCC28517 100-W PFC power converter with 12-V, 8-W bias supply, Part 2 | Ti Analog Journal paper | PDF (https://www.ti.com/lit/an/slyt092/slyt092.pdf?ts=1744749432884) | TODO
ANALOG DESIGN JOURNAL article archive | Ti site | PDF (https://www.ti.com/lit/sg/slyt778c/slyt778c.pdf) | DONE
Współczynnik Mocy i PFC_ | Gemini DeepsSearch Doc | PDF | TODO
Pomiar Współczynnika Mocy_ Metody i Sposoby_ | Gemini DeepsSearch Doc | PDF | TODO
Cyfrowy Pomiar Współczynnika Mocy_ Opis, Metody i Komponenty_ | Gemini DeepsSearch Doc | PDF | TODO
PFC for not dummies | Ti Videos | Videos (https://www.ti.com/video/5567966309001?keyMatch=HVI%20PFC%20Not%20For%20Dummies&tisearch=universal_search) | TODO

Sheet: PF_I_V_isolated_measurment_
Założenia
 | Pomiar prądu I napięcia → komunikacja z prockiem → komunikacja z kompem
 | Zasilanie z sieci
 | Wysiwetlacz oled albo LCD
 | Ethernet ? |  | https://www.ti.com/video/series/precision-labs/ti-precision-labs-ethernet.html
 | USB
STM32H750B-DK | discover board z tym prockiem
 |  |  |  | Suma
 |  |  |  | 155.71 zł
Type | MPN | Datasheet | Mouser | Price
Isol ADC V | AMC3336 | Link (https://www.ti.com/lit/ds/symlink/amc3336.pdf?ts=1744696834220) | AMC3336DWER (https://www.mouser.pl/ProductDetail/Texas-Instruments/AMC3336DWER?qs=TuK3vfAjtkUFYNEetxZbpg%3D%3D) | 35.00 zł
Isol ADC I | AMC3306M25 | Link (https://www.ti.com/lit/ds/symlink/amc3306m25.pdf?ts=1744716572560) | AMC3306M25DWER (https://www.mouser.pl/ProductDetail/Texas-Instruments/AMC3306M25DWER) | 31.70 zł
Procek | Stm32 | Link (https://www.mouser.pl/datasheet/2/389/stm32h750ib-1761001.pdf) | STM32H750VBT6 (https://www.mouser.pl/ProductDetail/STMicroelectronics/STM32H750VBT6?qs=%252BEew9%252B0nqrBAeuu%2FsQQSzQ%3D%3D) | 36.70 zł
Input connector | 691502710003 | Link (https://www.we-online.com/components/products/datasheet/691502710003.pdf) | 710-691502710003 (https://www.mouser.pl/ProductDetail/Wurth-Elektronik/691502710003?qs=3RJ0PdSuLVkj2fkNlWx2NA%3D%3D) | 4.21 zł
Shunt R | TLRP3A30DR025FTE | Link (https://www.mouser.pl/datasheet/2/418/8/ENG_DS_1773449_4_C-2492014.pdf) | 279-TLRP3A30DR025FTE (https://www.mouser.pl/ProductDetail/TE-Connectivity-Holsworthy/TLRP3A30DR025FTE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) | 2.00 zł
R div BIG | ERA-6AEB7153V | Link (https://industrial.panasonic.com/cdbs/www-data/pdf/RDM0000/AOA0000C307.pdf) | 667-ERA-6AEB7153V (https://www.mouser.pl/ProductDetail/Panasonic/ERA-6AEB7153V) | 2.00 zł
R div SMALL | ERA-3AEB103V | Link (https://industrial.panasonic.com/cdbs/www-data/pdf/RDM0000/AOA0000C307.pdf) | 667-ERA-3AEB103V (https://www.mouser.pl/ProductDetail/Panasonic/ERA-3AEB103V) | 0.50 zł
eFuse | TPS259620DDAR | Link (https://www.ti.com/lit/ds/symlink/tps2596.pdf?ts=1745769595888) | 595-TPS259620DDAR | 3.00 zł
25M crystal | DSC1001DI1-025.0000 | Link (https://www.mouser.pl/datasheet/2/268/DSC1001_3_4_1_8V_3_3V_Low_Power_Precision_CMOS_Osc-3314582.pdf) | 998-1001DI1-025.0000 (https://www.mouser.pl/ProductDetail/Microchip-Technology/DSC1001DI1-025.0000?qs=moDRE%2FDosU0aQZ7kAZYZlg%3D%3D) | 3.00 zł
Usb connector | 47590-0001 | Link (https://www.molex.com/en-us/products/part-detail-pdf/475900001?display=pdf) | 538-47590-0001 (https://www.mouser.pl/ProductDetail/Molex/47590-0001?qs=B2dI1vFk2x%252BDCUfk3sC4bA%3D%3D) | 3.00 zł
USB TVS | USBLC6-4SC6Y | Link (https://www.mouser.pl/datasheet/2/389/usblc6_4sc6y-1852703.pdf) | 511-USBLC6-4SC6Y (https://www.mouser.pl/ProductDetail/STMicroelectronics/USBLC6-4SC6Y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) | 1.50 zł
3V3 LDO | TLV1117LV33DCYR | Link (https://www.ti.com/lit/ds/symlink/tlv1117lv.pdf?ts=1745918401461) | 595-TLV1117LV33DCYR (https://www.mouser.pl/ProductDetail/Texas-Instruments/TLV1117LV33DCYR?qs=tEz3BkPb1rwzXMb8FiWhow%3D%3D) | 1.00 zł
Etherenet mag | ALANL100X1-DE12DT | Link (https://www.mouser.pl/datasheet/2/3/ALANL100X1-1652341.pdf) | 815-ALANL100X1DE12DT | 10.00 zł
Etherenet PHY | LAN8740AI | Link (https://www.mouser.pl/ProductDetail/Microchip-Technology/LAN8740AI-EN-TR?qs=6qKXPk0vzx1pdBrIaNrUbA%3D%3D) | 579-LAN8740AI-EN-TR (https://www.mouser.pl/datasheet/2/268/00001987A-3443048.pdf) | 9.00 zł
SSR | VO1400AEFTR | Link (https://www.mouser.pl/datasheet/2/408/TLP176AM_datasheet_en_20230821-1320854.pdf) | 782-VO1400AEFTR (https://www.mouser.pl/ProductDetail/Vishay-Semiconductors/VO1400AEFTR) | 9.00 zł
Schmitt inv | SN74LVC14APWRG3 | Link (https://www.ti.com/lit/ds/symlink/sn74lvc14a.pdf?ts=1746355189739) | 595-SN74LVC14APWRG3 (https://www.mouser.pl/ProductDetail/Texas-Instruments/SN74LVC14APWRG3) | 1.60 zł
Out TVS | PESD36VS2UT,215 | LInk (https://assets.nexperia.com/documents/data-sheet/PESD36VS2UT.pdf) | 771-PESD36VS2UT215 (https://www.mouser.pl/ProductDetail/Nexperia/PESD36VS2UT215?qs=GcY6OjH1zdmTNUVlmhpatA%3D%3D) | 2.50 zł
 |  |  |  |  | TM4C1294NCPDT: Ethernet connection to transformer - center taps - Arm-based microcontrollers forum - Arm-based microcontrollers - TI E2E support forums
I_ADC calculation
 |  |  | REAL
Vclip | 320 | mV | 320 | mV
Vfs | 250 | mV | 250 | mV
Vshunt | 240 | mV | 240 | mV
I nom | 10 | A | 9.6 | A
I overc | 13.33 | A | 12.8 | A
Rshunt | 24 | mOhm | 25 | mOhm
Pshunt | 2.4 | W | 2.304 | W
V_ADC calculations
TPS Efuse Calculation |  |  | REAL
Ilim | 1 | A | 0.914 | A
Rlim | 913.23 | Ohm | 1000 | Ohm
UVLO | 2 | V | 2.00 | V
OVLO | 6 | V | 6.01 | V
R1 | 94.00 | Ohm | 94.2 | Ohm
R2 | 94.00 | Ohm | 94.2 | Ohm
R3 | 47 | Ohm | 47 | Ohm
R1 + R2 | 188.00 | Ohm | 188.4 | Ohm
Cd | 2200000 | pF
SR | 0.0190909090909091 | mv/us
Vin | 5 | V
Trise | 261.904761904762 | ms
Cout | 22 | uF
Irush | 0.42 | mA
Pinrush | 1.05 | mW

Sheet: USB_
Diff 90Ohm

Sheet: Ethernet
 | https://www.ti.com/video/series/precision-labs/ti-precision-labs-ethernet.html
 | https://www.mouser.pl/datasheet/2/268/00001987A-3443048.pdf
 | https://www.mouser.pl/ProductDetail/Amphenol-Commercial-Products/RJHSE-5380?qs=rM3ofmSYd5RUaPrWD7oMhw%3D%3D
 | https://www.mouser.pl/ProductDetail/ABRACON/ALANS100X1-2F10ET?qs=mAH9sUMRCttQXbNrFkUJng%3D%3D
TM4C1294NCPDT: Ethernet connection to transformer - center taps - Arm-based microcontrollers forum - Arm-based microcontrollers - TI E2E support forums
LAN schematic checklist
https://ww1.microchip.com/downloads/aemDocuments/documents/UNG/ProductDocuments/DesignChecklist/LAN8740AQFNRevASchematicChecklist.pdf

Sheet: I shunt calculations
 |  |  |  |  |  |  |  |  |  | R mOhm
 |  |  |  |  |  |  |  |  |  | 1m | R para, mOhm | 1/R | Ir, A | Pr, W | Sum 1/R | 0.208333333333333
 |  |  |  |  |  |  |  |  |  | 2m | 40 | 0.0250 | 1.92 | 0.147 | Rz, mOhm | 4.8
 |  |  |  |  |  |  |  |  |  |  | 40 | 0.0250 | 1.92 | 0.147
 |  |  |  |  |  |  |  |  |  |  | 40 | 0.0250 | 1.92 | 0.147
 |  |  |  |  |  |  |  |  |  |  | 40 | 0.0250 | 1.92 | 0.147
 |  |  |  |  |  |  |  |  |  |  | 40 | 0.0250 | 1.92 | 0.147
 |  |  |  |  |  |  |  |  |  |  | 36 | 0.0278 | 2.13 | 0.164
max shunt V | 0.25 | V |  |  |  |  |  |  |  |  | 36 | 0.0278 | 2.13 | 0.164
max RMS I | 16 | A | chosen RMS I | 16 | A | I meas | 16 | A |  |  | 36 | 0.0278 | 2.13 | 0.164
max peak I | 22.63 | A | chosen R | 0.0048 | Ohm | nom R | 0.0048 | Ohm
 |  |  |  |  |  |  |  |  | 0.0110485434560398
shunt R | 0.0110485434560398 | Ohm | max V | 0.1086 | V | tem chan | 75 | *C
shunt R | 11.05 | mOhm | shunt P | 1.2288 | W | PPM | 50
shut power | 2.83 | W |  |  |  | R diff | 0.000018 | Ohm
 |  |  |  |  |  | new R | 0.004818 | Ohm
pow div | 8 |  |  |  |  | new V | 0.077088 | V
P each | 0.1536 | W |  |  |  | new I meas | 16.06 | A
 |  |  |  |  |  | I diff | 0.0599999999999987 | A
