martinrybka2000/openacme-pfm/v1.0/PCB/BOOM.sync-conflict-20260513-040855-QFY63LB.xlsx

Sheet: PFM
Reference, | Value | MPN | Price, PLN | Footprint | Datasheet | Qty | DNP | Exclude from BOM | Exclude from Board
C1,C2,C3,C4,C5,C7,C9,C10,C11,C12,C45,C46,C47,C48,C55,C56,C57,C58,C59,C60,C61, | 100n | On Stan | 0.00 zł | Capacitor_SMD:C_0603_1608Metric_Pad1.08x0.95mm_HandSolder | ~ | 25
C24,C27,C36,C38, | 100n | C0603C104K5RACAUTO (https://www.mouser.pl/ProductDetail/KEMET/C0603C104K5RACAUTO?qs=8xX%252BF9%252BWV6EZsgKw9G0PqQ%3D%3D) | 2.00 zł | Capacitor_SMD:C_0603_1608Metric_Pad1.08x0.95mm_HandSolder
C6, | 4.7u | On Stan | 0.00 zł | Capacitor_SMD:C_0805_2012Metric_Pad1.18x1.45mm_HandSolder | ~ | 1
,C22 | 22u | CL31A226MOCLNNC (https://www.mouser.pl/ProductDetail/Samsung-Electro-Mechanics/CL31A226MOCLNNC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) | 5.00 zł | Capacitor_SMD:C_1206_3216Metric_Pad1.33x1.80mm_HandSolder
C8,C21,C35,C37,C40,,C51, | 1u | 12063C105KAT2A (https://www.mouser.pl/ProductDetail/KYOCERA-AVX/12063C105KAT2A?qs=v27vNPZSEuYOHibjub0%2F2A%3D%3D) | 6.00 zł | Capacitor_SMD:C_1206_3216Metric_Pad1.33x1.80mm_HandSolder | ~ | 10
C13,C14,C15, | 1n, 2KV | 885342208024 (https://www.mouser.pl/ProductDetail/Wurth-Elektronik/885342208024) | 1.50 zł | Capacitor_SMD:C_1206_3216Metric_Pad1.33x1.80mm_HandSolder | ~ | 3
C16, | 22n | CL05C220JB51PNC (https://www.mouser.pl/ProductDetail/Samsung-Electro-Mechanics/CL05C220JB51PNC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) | 1.90 zł | Capacitor_SMD:C_0402_1005Metric_Pad0.74x0.62mm_HandSolder | ~ | 1
C17, | 4.7n, 2kV | 1210B472K202CT (https://www.mouser.pl/ProductDetail/Walsin/1210B472K202CT) | 1.70 zł | Capacitor_SMD:C_1210_3225Metric_Pad1.33x2.70mm_HandSolder | ~ | 1
C18,C42,C43,C44, | 10p | 885392005106 (https://www.mouser.pl/ProductDetail/Wurth-Elektronik/885392005106) | 2.50 zł | Capacitor_SMD:C_0402_1005Metric_Pad0.74x0.62mm_HandSolder | ~ | 4
C19, | 10n | 06035C103JAT2A (https://www.mouser.pl/ProductDetail/KYOCERA-AVX/06035C103JAT2A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) | 1.50 zł | Capacitor_SMD:C_0603_1608Metric_Pad1.08x0.95mm_HandSolder | ~ | 1
C20,C25, | 100n | C3216NP01H104J160AA (https://www.mouser.pl/ProductDetail/TDK/C3216NP01H104J160AA?qs=xLDY6iXSiQaDgtkRRwlWSQ%3D%3D) | 5.00 zł | Capacitor_SMD:C_1206_3216Metric_Pad1.33x1.80mm_HandSolder | ~ | 2
C23,C26, | 1u | CGA3E1X7R1E105K080AC (https://www.mouser.pl/ProductDetail/TDK/CGA3E1X7R1E105K080AC?qs=NRhsANhppD9VxGl2AsmRpw%3D%3D) | 3.60 zł | Capacitor_SMD:C_0603_1608Metric_Pad1.08x0.95mm_HandSolder | ~ | 2
C28,C30,C33,C34, | 1n | 12065C102KAT2A (https://www.mouser.pl/ProductDetail/KYOCERA-AVX/12065C102KAT2A?qs=2q%252BWEwtIaala95xflKOUww%3D%3D) | 5.00 zł | Capacitor_SMD:C_1206_3216Metric_Pad1.33x1.80mm_HandSolder | kicad-embed://KGM_X7R-3223212[1].pdf,~ | 4
C29,C31,C32, | 1n | C0603C102K5RACTU (https://www.mouser.pl/ProductDetail/KEMET/C0603C102K5RACTU?qs=XGjIaNSbuEs37lO8KrbNPg%3D%3D) | 1.00 zł | Capacitor_SMD:C_0603_1608Metric_Pad1.08x0.95mm_HandSolder | ~ | 3
C39,C49,C50, C41, | 2.2u | On Stan | 0.00 zł | Capacitor_SMD:C_0603_1608Metric_Pad1.08x0.95mm_HandSolder | ~ | 1
C52, | 470p | KGM05ACG1H471JN (https://www.mouser.pl/ProductDetail/KYOCERA-AVX/KGM05ACG1H471JN) | 2.00 zł | Capacitor_SMD:C_0402_1005Metric_Pad0.74x0.62mm_HandSolder | ~ | 1
C53,C54, | 5n | 08051C502KAT2A (https://www.mouser.pl/ProductDetail/KYOCERA-AVX/08051C502KAT2A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) | 2.00 zł | Capacitor_SMD:C_0805_2012Metric | ~ | 2
D1, | LED_5V | On Stan | 0.00 zł | LED_SMD:LED_0805_2012Metric_Pad1.15x1.40mm_HandSolder | ~ | 1
D2, | LED_RED | On Stan | 0.00 zł | LED_SMD:LED_0805_2012Metric_Pad1.15x1.40mm_HandSolder | ~ | 1
D3 | D_TVS | ESD203B102ELE6327XTMA1 (https://www.mouser.pl/ProductDetail/Infineon-Technologies/ESD203B102ELE6327XTMA1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) | 1.50 zł | Diode_SMD:D_0603_1608Metric_Pad1.05x0.95mm_HandSolder
,D4, | D_TVS | GG040205100N2P (https://www.mouser.pl/ProductDetail/KYOCERA-AVX/GG040205100N2P?qs=AQlKX63v8RtEzxtu3m0x3g%3D%3D) | 1.00 zł | Diode_SMD:D_0402_1005Metric_Pad0.77x0.64mm_HandSolder | ~ | 2
D5, | LED_GR | On Stan | 0.00 zł | LED_SMD:LED_0805_2012Metric_Pad1.15x1.40mm_HandSolder | ~ | 1
D6, | LED_USB_PW | On Stan | 0.00 zł | LED_SMD:LED_0805_2012Metric_Pad1.15x1.40mm_HandSolder | ~ | 1
D7, | LED_3V3 | On Stan | 0.00 zł | LED_SMD:LED_0805_2012Metric_Pad1.15x1.40mm_HandSolder | ~ | 1
D8, | LED_EFAULT | On Stan | 0.00 zł | LED_SMD:LED_0805_2012Metric_Pad1.15x1.40mm_HandSolder | ~ | 1
D9,D10, | ESDA5V3L | 771-PESD36VS2UT215 (https://www.mouser.pl/ProductDetail/Nexperia/PESD36VS2UT215?qs=GcY6OjH1zdmTNUVlmhpatA%3D%3D) | 2.50 zł | Package_TO_SOT_SMD:SOT-23-3 | https://www.st.com/resource/en/datasheet/esdal.pdf | 2
FB1,FB2, | 1000Ohm | On Stan | 0.00 zł | Inductor_SMD:L_0603_1608Metric_Pad1.05x0.95mm_HandSolder | ~ | 2
IC1, | LAN8740AI-EN-TR | 579-LAN8740AI-EN-TR (https://www.mouser.pl/ProductDetail/Microchip-Technology/LAN8740AI-EN-TR?qs=6qKXPk0vzx1pdBrIaNrUbA%3D%3D) | 8.00 zł | ETH_PHY:QFN50P500X500X100-33N-D | https://datasheet.datasheetarchive.com/originals/distributors/DKDS-15/280025.pdf | 1
IC2, | SN74LVC14APWRG3 | 595-SN74LVC14APWRG3 (https://www.mouser.pl/ProductDetail/Texas-Instruments/SN74LVC14APWRG3) | 1.60 zł | Schmitt:SOP65P640X120-14N | http://www.ti.com/lit/gpn/sn74lvc14a | 1
J1, | Boot | On Stan | 0.00 zł | Connector_JST:JST_XH_B3B-XH-AM_1x03_P2.50mm_Vertical | ~ | 1
J2, | USB_OTG | 538-47590-0001 (https://www.mouser.pl/ProductDetail/Molex/47590-0001?qs=B2dI1vFk2x%252BDCUfk3sC4bA%3D%3D) | 3.00 zł | Connector_USB:USB_Micro-AB_Molex_47590-0001 | ~ | 1
J3, | GRID_term | 710-691502710003 (https://www.mouser.pl/ProductDetail/Wurth-Elektronik/691502710003?qs=3RJ0PdSuLVkj2fkNlWx2NA%3D%3D) | 4.00 zł | TerminalBlock:TerminalBlock_Altech_AK300-3_P5.00mm | ~ | 1
J4, | 5V_term | On Stan | 0.00 zł | TerminalBlock:TerminalBlock_Altech_AK300-2_P5.00mm | ~ | 1
J5, | OUT_term | 710-691502710003 (https://www.mouser.pl/ProductDetail/Wurth-Elektronik/691502710003?qs=3RJ0PdSuLVkj2fkNlWx2NA%3D%3D) | 4.00 zł | TerminalBlock:TerminalBlock_Altech_AK300-3_P5.00mm | ~ | 1
J6, | PROG_DEBUG | On Stan | 0.00 zł | Connector_PinHeader_2.54mm:PinHeader_1x03_P2.54mm_Vertical | ~ | 1
J7, | RJHSE-5380 | On Stan | 0.00 zł | Connector_RJ:RJ45_HALO_HFJ11-x2450HRL_Horizontal | https://cdn.amphenol-cs.com/media/wysiwyg/files/drawing/rjhsex380.pdf | 1
J8, | UART_DEBUG | On Stan | 0.00 zł | Connector_PinHeader_2.54mm:PinHeader_1x03_P2.54mm_Vertical | ~ | 1
J9, | OLED_I2C | On Stan | 0.00 zł | Connector_JST:JST_XH_B4B-XH-AM_1x04_P2.50mm_Vertical | ~ | 1
J10, | ADC_EXT_CONN | TBC05-03-1-G-G (https://www.mouser.pl/ProductDetail/GCT/TBC05-03-1-G-G) | 4.00 zł | Connector:FanPinHeader_1x03_P2.54mm_Vertical | ~ | 1
J11, | SPI_EXT | On Stan | 0.00 zł | Connector_JST:JST_XH_B5B-XH-AM_1x05_P2.50mm_Vertical | ~ | 1
J12, | OUT_1 | On Stan | 0.00 zł | TerminalBlock:TerminalBlock_Altech_AK300-2_P5.00mm | ~ | 1
J13, | OUT_2 | On Stan | 0.00 zł | TerminalBlock:TerminalBlock_Altech_AK300-2_P5.00mm | ~ | 1
J14, | Butts_conn | On Stan | 0.00 zł | Connector_JST:JST_XH_B8B-XH-AM_1x08_P2.50mm_Vertical | ~ | 1
J15, | Free_pins | On Stan | 0.00 zł | Connector_JST:JST_XH_B8B-XH-AM_1x08_P2.50mm_Vertical | ~ | 1
K1,K2, | PS2802-1-F3-A | On Stan | 0.00 zł | SOIC127P700X210-4N | http://toshiba.semicon-storage.com/info/docget.jsp?did=60600&prodName=TLP176AM | 2
Q1, | SI3493DDV-T1-GE3 | On Stan | 0.00 zł | Package_TO_SOT_SMD:SOT-23_Handsoldering | https://www.onsemi.com/pub/Collateral/BC860-D.pdf | 1
R1,R2, | 0 | On Stan | 0.00 zł | Resistor_SMD:R_0402_1005Metric | ~ | 2 | DNP | Excluded from BOM
R3,R4,R5,R6, | 75 | ERA-2AEB750X (https://www.mouser.pl/ProductDetail/Panasonic/ERA-2AEB750X?qs=sGAEpiMZZMtlubZbdhIBILRDuhBknqQk92rJ9C9nRy0%3D) | 3.50 zł | Resistor_SMD:R_0402_1005Metric_Pad0.72x0.64mm_HandSolder | ~ | 4
R7, | 1M | RC2512JK-071ML (https://www.mouser.pl/ProductDetail/YAGEO/RC2512JK-071ML?qs=sGAEpiMZZMtlubZbdhIBIIe0KCL5sPzhsvStfdyCaC8%3D) | 0.60 zł | Resistor_SMD:R_2512_6332Metric_Pad1.40x3.35mm_HandSolder | ~ | 1
R11,R12,R14,R15,R21, | 715k | 667-ERA-6AEB7153V (https://www.mouser.pl/ProductDetail/Panasonic/ERA-6AEB7153V) | 2.50 zł | Resistor_SMD:R_0805_2012Metric_Pad1.20x1.40mm_HandSolder | ~ | 5
R13 | 10k, 0.1% | 667-ERA-3AEB103V (https://www.mouser.pl/ProductDetail/Panasonic/ERA-3AEB103V) | 2.50 zł | Resistor_SMD:R_0603_1608Metric_Pad0.98x0.95mm_HandSolder
,R20,R27,R28,R31,R41,R68,R69,R70,R71,R72,R73, | 10k | On Stan | 0.00 zł | Resistor_SMD:R_0603_1608Metric_Pad0.98x0.95mm_HandSolder | ~ | 12
R16,R17, | 94.2 | RN73H1JTTD94R2F50 (https://www.mouser.pl/ProductDetail/KOA-Speer/RN73H1JTTD94R2F50?qs=pJKkPLTLvBgHgE4xusW2QQ%3D%3D) | 4.00 zł | Resistor_SMD:R_0603_1608Metric_Pad0.98x0.95mm_HandSolder | ~ | 2
R18,R24,R25,R35, | 47k | On Stan | 0.00 zł | Resistor_SMD:R_0603_1608Metric_Pad0.98x0.95mm_HandSolder | ~ | 4
R19,R36, | 1k | On Stan | 0.00 zł | Resistor_SMD:R_0603_1608Metric_Pad0.98x0.95mm_HandSolder | ~ | 2
R22,R23, | 10 | RCA060310R0FKEAHP (https://www.mouser.pl/ProductDetail/Vishay-Draloric/RCA060310R0FKEAHP) | 2.30 zł | Resistor_SMD:R_0603_1608Metric_Pad0.98x0.95mm_HandSolder | ~ | 2
R26,R29,R30,R32,R33,R34, | 680 | On Stan | 0.00 zł | Resistor_SMD:R_0603_1608Metric_Pad0.98x0.95mm_HandSolder | ~ | 6
R38, | 12.1k | RT0603FRE0712K1L (https://www.mouser.pl/ProductDetail/YAGEO/RT0603FRE0712K1L?qs=sGAEpiMZZMtlubZbdhIBILjYW2Gkblj8tpC0PfbogpM%3D) | 0.60 zł | Capacitor_SMD:C_0603_1608Metric_Pad1.08x0.95mm_HandSolder | ~ | 1
R39,R40, | 33 | On Stan | 0.00 zł | Resistor_SMD:R_0603_1608Metric_Pad0.98x0.95mm_HandSolder | ~ | 2
R42,R43,R44,R45,R46,R47,R48,R50,R51,R52,R53,R54,R55,R56,R57,R58,R59, | 100 | RR0510P-101-D (https://www.mouser.pl/ProductDetail/Susumu/RR0510P-101-D?qs=sGAEpiMZZMtlubZbdhIBIHPiT0YkkodQvbyWB4riPVA%3D) | 2.00 zł | Resistor_SMD:R_0402_1005Metric_Pad0.72x0.64mm_HandSolder | ~ | 17
R60, | 4.7k | On Stan | 0.00 zł | Resistor_SMD:R_0603_1608Metric_Pad0.98x0.95mm_HandSolder | ~ | 1
R61, R49, | 1.5k | On Stan | 0.00 zł | Resistor_SMD:R_0603_1608Metric_Pad0.98x0.95mm_HandSolder | ~ | 1
R62,R63, | 0 | On Stan | 0.00 zł | Resistor_SMD:R_01005_0402Metric | ~ | 2 | DNP | Excluded from BOM
R64,R65, R8,R9,R10,R37, | 49.9 | On Stan | 0.00 zł | Resistor_SMD:R_0402_1005Metric_Pad0.72x0.64mm_HandSolder | ~ | 2
R66,R74,R75,R76 | 150 | On Stan | 0.00 zł | Resistor_SMD:R_0603_1608Metric_Pad0.98x0.95mm_HandSolder | ~ | 2
RV1,RV2,RV3, | Varistor | MOVS4032V230 (https://www.mouser.pl/ProductDetail/Eaton-Electronics/MOVS4032V230?qs=CiayqK2gdcIfc2V9FwqqWg%3D%3D) | 17.00 zł | Resistor_SMD:R_4020_10251Metric_Pad1.65x5.30mm_HandSolder | ~ | 3
R_SHUNT2, | 25m | 279-TLRP3A30DR025FTE (https://www.mouser.pl/ProductDetail/TE-Connectivity-Holsworthy/TLRP3A30DR025FTE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) | 2.00 zł | Resistor_SMD:R_2512_6332Metric | ~ | 1
SW1, | RESET_SW | On Stan | 0.00 zł | Button_Switch_SMD:SW_DIP_SPSTx01_Slide_9.78x4.72mm_W8.61mm_P2.54mm | http://www.apem.com/int/index.php?controller=attachment&id_attachment=1371 | 1
T1, | ALANL100X1-DE12DT | 815-ALANL100X1DE12DT (https://www.mouser.pl/ProductDetail/ABRACON/ALANL100X1-DE12DT?qs=BJlw7L4Cy79emB2iS%2FU5sA%3D%3D) | 10.00 zł | ETH_MAG:SOIC12_ALANL100X1_ABR | ALANL100X1-DE12DT | 1
U1, | STM32H750VBTx | STM32H750VBT6 (https://www.mouser.pl/ProductDetail/STMicroelectronics/STM32H750VBT6?qs=%252BEew9%252B0nqrBAeuu%2FsQQSzQ%3D%3D) | 36.00 zł | Package_QFP:LQFP-100_14x14mm_P0.5mm | https://www.st.com/resource/en/datasheet/stm32h750vb.pdf | 1
U2, | DSC1001DI1-025.0000 | 998-1001DI1-025.0000 (https://www.mouser.pl/ProductDetail/Microchip-Technology/DSC1001DI1-025.0000?qs=moDRE%2FDosU0aQZ7kAZYZlg%3D%3D) | 3.00 zł | 25MHz:CDFN4_2P5X2_MCH | DSC1001DI1-025.0000 | 1
U3, | AMC3306M25DWE | AMC3306M25DWER (https://www.mouser.pl/ProductDetail/Texas-Instruments/AMC3306M25DWER) | 32.00 zł | AMC:DWE0016A-IPC_A | AMC3306M25DWE | 1
U4, | TPS259620DDAR | 595-TPS259620DDAR (https://www.mouser.pl/ProductDetail/Texas-Instruments/TPS259620DDAR?qs=XeJtXLiO41RogCpRV1l%252BSg%3D%3D) | 3.00 zł | TI_TPS:SOIC_20DDAR_TEX | TPS259620DDAR | 1
U5, | AMC3336 | AMC3336DWER (https://www.mouser.pl/ProductDetail/Texas-Instruments/AMC3336DWER?qs=TuK3vfAjtkUFYNEetxZbpg%3D%3D) | 38.00 zł | Package_SO:SOIC-16W_7.5x10.3mm_P1.27mm | https://www.ti.com/lit/ds/symlink/amc3336.pdf | 1
U6, | USBLC6-4SC6 | 511-USBLC6-4SC6Y (https://www.mouser.pl/ProductDetail/STMicroelectronics/USBLC6-4SC6Y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) | 1.50 zł | Package_TO_SOT_SMD:SOT-23-6 | https://www.st.com/resource/en/datasheet/usblc6-4.pdf | 1
U7, | TLV1117-33 | 595-TLV1117LV33DCYR (https://www.mouser.pl/ProductDetail/Texas-Instruments/TLV1117LV33DCYR?qs=tEz3BkPb1rwzXMb8FiWhow%3D%3D) | 1.00 zł | Package_TO_SOT_SMD:SOT-223-3_TabPin2 | http://www.ti.com/lit/ds/symlink/tlv1117.pdf | 1
 |  |  | 231.80 zł

Sheet: New
Ref | Qnty | Value | MPN | Price, PLN | Footprint | Description
C1, C2, C3, C4, C5, C7, C9, C10, C11, C12, , C47, C55, C56, C57, C58, C59, C60, C61, | 18 | 100n | On Stan | 0.00 zł | Capacitor_SMD:C_0603_1608Metric_Pad1.08x0.95mm_HandSolder | Unpolarized capacitor, small symbol
C24, C27, C36, C38 | 4 | 100n | C0603C104K5RACAUTO (https://www.mouser.pl/ProductDetail/KEMET/C0603C104K5RACAUTO?qs=8xX%252BF9%252BWV6EZsgKw9G0PqQ%3D%3D) | 2.00 zł | Capacitor_SMD:C_0603_1608Metric_Pad1.08x0.95mm_HandSolder
C6, | 1 | 4.7u | On Stan | 0.00 zł | Capacitor_SMD:C_0805_2012Metric_Pad1.18x1.45mm_HandSolder | Polarized capacitor, small symbol
C13, C14, | 2 | 1n, 2KV | 885342208024 (https://www.mouser.pl/ProductDetail/Wurth-Elektronik/885342208024) | 1.50 zł | Capacitor_SMD:C_1206_3216Metric_Pad1.33x1.80mm_HandSolder | Unpolarized capacitor, small symbol
C16, | 1 | 22n | AC0402KRX7R9BB223 (https://www.mouser.pl/ProductDetail/YAGEO/AC0402KRX7R9BB223) | 1.90 zł | Capacitor_SMD:C_0402_1005Metric_Pad0.74x0.62mm_HandSolder | Unpolarized capacitor, small symbol
C17, | 1 | 4.7n, 2kV | 1210B472K202CT (https://www.mouser.pl/ProductDetail/Walsin/1210B472K202CT) | 1.70 zł | Capacitor_SMD:C_1210_3225Metric_Pad1.33x2.70mm_HandSolder | Unpolarized capacitor, small symbol
C18, C42, C43, C44, | 4 | 10p | 885392005106 (https://www.mouser.pl/ProductDetail/Wurth-Elektronik/885392005106) | 2.50 zł | Capacitor_SMD:C_0402_1005Metric_Pad0.74x0.62mm_HandSolder | Unpolarized capacitor, small symbol
C19, | 1 | 10n | 06035C103JAT2A (https://www.mouser.pl/ProductDetail/KYOCERA-AVX/06035C103JAT2A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) | 1.50 zł | Capacitor_SMD:C_0603_1608Metric_Pad1.08x0.95mm_HandSolder | Unpolarized capacitor, small symbol
C20, C25, | 2 | 100n | C3216NP01H104J160AA (https://www.mouser.pl/ProductDetail/TDK/C3216NP01H104J160AA?qs=xLDY6iXSiQaDgtkRRwlWSQ%3D%3D) | 5.00 zł | Capacitor_SMD:C_1206_3216Metric_Pad1.33x1.80mm_HandSolder | Unpolarized capacitor, small symbol
C21, C35, C37, C40, C51, | 5 | 1u | 12063C105KAT2A (https://www.mouser.pl/ProductDetail/KYOCERA-AVX/12063C105KAT2A?qs=v27vNPZSEuYOHibjub0%2F2A%3D%3D) | 6.00 zł | Capacitor_SMD:C_1206_3216Metric_Pad1.33x1.80mm_HandSolder | Polarized capacitor, small symbol
C22, | 1 | 22u | CL31A226MOCLNNC (https://www.mouser.pl/ProductDetail/Samsung-Electro-Mechanics/CL31A226MOCLNNC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) | 5.00 zł | Capacitor_SMD:C_1206_3216Metric_Pad1.33x1.80mm_HandSolder | Unpolarized capacitor
C23, C26, | 2 | 1u | CGA3E1X7R1E105K080AC (https://www.mouser.pl/ProductDetail/TDK/CGA3E1X7R1E105K080AC?qs=NRhsANhppD9VxGl2AsmRpw%3D%3D) | 3.60 zł | Capacitor_SMD:C_0603_1608Metric_Pad1.08x0.95mm_HandSolder | Unpolarized capacitor, small symbol
C28, C30, C33, C34, | 4 | 1n | 12065C102KAT2A (https://www.mouser.pl/ProductDetail/KYOCERA-AVX/12065C102KAT2A?qs=2q%252BWEwtIaala95xflKOUww%3D%3D) | 5.00 zł | Capacitor_SMD:C_1206_3216Metric_Pad1.33x1.80mm_HandSolder | Unpolarized capacitor
C29, C31, C32, | 3 | 1n | C0603C102K5RAC7411 (https://www.mouser.pl/ProductDetail/KEMET/C0603C102K5RAC7411?qs=6vAnWmThf5WkJm2k7MMrkg%3D%3D) | 1.00 zł | Capacitor_SMD:C_0603_1608Metric_Pad1.08x0.95mm_HandSolder | Unpolarized capacitor, small symbol
C39, C41, C49, C50, | 4 | 2.2u | On Stan | 0.00 zł | Capacitor_SMD:C_0603_1608Metric_Pad1.08x0.95mm_HandSolder | Polarized capacitor, small symbol
C45, C46, C48, | 3 | 100n | GRM155R61A104KA01J (https://www.mouser.pl/ProductDetail/Murata-Electronics/GRM155R61A104KA01J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) | 1.00 zł | Capacitor_SMD:C_0402_1005Metric | Unpolarized capacitor, small symbol
C52, | 1 | 470p | KGM05ACG1H471JN (https://www.mouser.pl/ProductDetail/KYOCERA-AVX/KGM05ACG1H471JN) | 2.00 zł | Capacitor_SMD:C_0402_1005Metric | Unpolarized capacitor, small symbol
C53, C54, | 2 | 5n | 08051C502KAT2A (https://www.mouser.pl/ProductDetail/KYOCERA-AVX/08051C502KAT2A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) | 2.00 zł | Capacitor_SMD:C_0805_2012Metric | Unpolarized capacitor, small symbol
D1, | 1 | LED_5V | On Stan | 0.00 zł | LED_SMD:LED_0805_2012Metric_Pad1.15x1.40mm_HandSolder | Light emitting diode
D2, | 1 | LED_RED | On Stan | 0.00 zł | LED_SMD:LED_0805_2012Metric_Pad1.15x1.40mm_HandSolder | Light emitting diode
D3, | 1 | D_TVS | ESD203B102ELE6327XTMA1 (https://www.mouser.pl/ProductDetail/Infineon-Technologies/ESD203B102ELE6327XTMA1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) | 1.50 zł | Diode_SMD:D_0603_1608Metric_Pad1.05x0.95mm_HandSolder | Bidirectional transient-voltage-suppression diode
D4, | 1 | D_TVS | GG040205100N2P (https://www.mouser.pl/ProductDetail/KYOCERA-AVX/GG040205100N2P?qs=AQlKX63v8RtEzxtu3m0x3g%3D%3D) | 1.00 zł | Diode_SMD:D_0402_1005Metric_Pad0.77x0.64mm_HandSolder | Bidirectional transient-voltage-suppression diode
D5, | 1 | LED_GR | On Stan | 0.00 zł | LED_SMD:LED_0805_2012Metric_Pad1.15x1.40mm_HandSolder | Light emitting diode
D6, | 1 | LED_USB_PW | On Stan | 0.00 zł | LED_SMD:LED_0805_2012Metric_Pad1.15x1.40mm_HandSolder | Light emitting diode
D7, | 1 | LED_3V3 | On Stan | 0.00 zł | LED_SMD:LED_0805_2012Metric_Pad1.15x1.40mm_HandSolder | Light emitting diode
D8, | 1 | LED_EFAULT | On Stan | 0.00 zł | LED_SMD:LED_0805_2012Metric_Pad1.15x1.40mm_HandSolder | Light emitting diode
D9, D10, | 2 | ESDA5V3L | 771-PESD36VS2UT215 (https://www.mouser.pl/ProductDetail/Nexperia/PESD36VS2UT215?qs=GcY6OjH1zdmTNUVlmhpatA%3D%3D) | 2.50 zł | Package_TO_SOT_SMD:SOT-23-3 | TVS Diode Array, 5.5V Standoff, 2 Channels, SOT23
FB1, FB2, | 2 | 1000Ohm | On Stan | 0.00 zł | Inductor_SMD:L_0603_1608Metric_Pad1.05x0.95mm_HandSolder | Ferrite bead, small symbol
IC1, | 1 | LAN8740AI-EN-TR | 579-LAN8740AI-EN-TR (https://www.mouser.pl/ProductDetail/Microchip-Technology/LAN8740AI-EN-TR?qs=6qKXPk0vzx1pdBrIaNrUbA%3D%3D) | 8.00 zł | ETH_PHY:QFN50P500X500X100-33N-D | Ethernet ICs Small Footprint MII/RMII 10/100 Energy Efficient Ethernet Transceiver
IC2, | 1 | SN74LVC14APWRG3 | 595-SN74LVC14APWRG3 (https://www.mouser.pl/ProductDetail/Texas-Instruments/SN74LVC14APWRG3) | 1.60 zł | Schmitt:SOP65P640X120-14N | Hex Schmitt-Trigger Inverter
IC3, IC4, | 2 | PS2802-1-F3-A | On Stan | 0.00 zł | PS_opto:SOIC127P700X210-4N | The PS2802-1 and PS2802-4 are optically coupled isolators containing a GaAs light emitting diode and an NPN silicon darlington-connected photo transistor in a plastic SSOP for high density applications. This package has shield effect to cut off ambient light.
J1, | 1 | Boot | On Stan | 0.00 zł | Connector_PinHeader_2.54mm:PinHeader_1x03_P2.54mm_Vertical | Generic connector, single row, 01x03, script generated (kicad-library-utils/schlib/autogen/connector/)
J2, | 1 | USB_OTG | 538-47590-0001 (https://www.mouser.pl/ProductDetail/Molex/47590-0001?qs=B2dI1vFk2x%252BDCUfk3sC4bA%3D%3D) | 3.00 zł | Connector_USB:USB_Micro-AB_Molex_47590-0001 | USB mini/micro connector
J3, | 1 | GRID_term | 710-691502710003 (https://www.mouser.pl/ProductDetail/Wurth-Elektronik/691502710003?qs=3RJ0PdSuLVkj2fkNlWx2NA%3D%3D) | 4.00 zł | TerminalBlock:TerminalBlock_Altech_AK300-3_P5.00mm | Generic screw terminal, single row, 01x03, script generated (kicad-library-utils/schlib/autogen/connector/)
J4, | 1 | 5V_term | On Stan | 0.00 zł | TerminalBlock:TerminalBlock_Altech_AK300-2_P5.00mm | Generic screw terminal, single row, 01x02, script generated (kicad-library-utils/schlib/autogen/connector/)
J5, | 1 | OUT_term | 710-691502710003 (https://www.mouser.pl/ProductDetail/Wurth-Elektronik/691502710003?qs=3RJ0PdSuLVkj2fkNlWx2NA%3D%3D) | 4.00 zł | TerminalBlock:TerminalBlock_Altech_AK300-3_P5.00mm | Generic screw terminal, single row, 01x03, script generated (kicad-library-utils/schlib/autogen/connector/)
J6, | 1 | PROG_DEBUG | On Stan | 0.00 zł | Connector_PinHeader_2.54mm:PinHeader_1x03_P2.54mm_Vertical | Generic connector, single row, 01x03, script generated (kicad-library-utils/schlib/autogen/connector/)
J7, | 1 | RJHSE-5380 | On Stan | 0.00 zł | Connector_RJ:RJ45_HALO_HFJ11-x2450HRL_Horizontal | Jack Modular Connector 8p8c (RJ45, Ethernet) 90 Angle (Right) Shielded, EMI Finger , 125VAC , 1.5A , -55C ~ 85C
J8, | 1 | UART_DEBUG | On Stan | 0.00 zł | Connector_PinHeader_2.54mm:PinHeader_1x03_P2.54mm_Vertical | Generic connector, single row, 01x03, script generated (kicad-library-utils/schlib/autogen/connector/)
J9, | 1 | OLED_I2C | On Stan | 0.00 zł | Connector_JST:JST_XH_B4B-XH-AM_1x04_P2.50mm_Vertical | Generic connector, single row, 01x04, script generated (kicad-library-utils/schlib/autogen/connector/)
J10, | 1 | ADC_EXT_CONN | TBC05-03-1-G-G (https://www.mouser.pl/ProductDetail/GCT/TBC05-03-1-G-G) | 4.00 zł | Connector:FanPinHeader_1x03_P2.54mm_Vertical | Generic connector, single row, 01x03, script generated (kicad-library-utils/schlib/autogen/connector/)
J11, | 1 | SPI_EXT | On Stan | 0.00 zł | Connector_JST:JST_XH_B5B-XH-AM_1x05_P2.50mm_Vertical | Generic connector, single row, 01x05, script generated (kicad-library-utils/schlib/autogen/connector/)
J12, | 1 | OUT_1 | On Stan | 0.00 zł | TerminalBlock:TerminalBlock_Altech_AK300-2_P5.00mm | Generic screw terminal, single row, 01x02, script generated (kicad-library-utils/schlib/autogen/connector/)
J13, | 1 | OUT_2 | On Stan | 0.00 zł | TerminalBlock:TerminalBlock_Altech_AK300-2_P5.00mm | Generic screw terminal, single row, 01x02, script generated (kicad-library-utils/schlib/autogen/connector/)
J15, | 1 | Free_pins | On Stan | 0.00 zł | Connector_JST:JST_XH_B8B-XH-AM_1x08_P2.50mm_Vertical | Generic connector, single row, 01x08, script generated (kicad-library-utils/schlib/autogen/connector/)
J17, | 1 | Butts_conn | On Stan | 0.00 zł | Connector_JST:JST_XH_B8B-XH-AM_1x08_P2.50mm_Vertical | Generic connector, single row, 01x08, script generated (kicad-library-utils/schlib/autogen/connector/)
Q2, | 1 | SI3493DDV-T1-GE3 | On Stan | 0.00 zł | SI3493DDV-T1-GE3:SOT95P284X110-6N | MOSFET -20V Vds 8V Vgs TSOP-6
R3, R4, R5, R6, | 4 | 75 | ERA-2AEB750X (https://www.mouser.pl/ProductDetail/Panasonic/ERA-2AEB750X?qs=sGAEpiMZZMtlubZbdhIBILRDuhBknqQk92rJ9C9nRy0%3D) | 3.50 zł | Resistor_SMD:R_0402_1005Metric_Pad0.72x0.64mm_HandSolder | Resistor, small symbol
R7, | 1 | 1M | RC2512JK-071ML (https://www.mouser.pl/ProductDetail/YAGEO/RC2512JK-071ML?qs=sGAEpiMZZMtlubZbdhIBIIe0KCL5sPzhsvStfdyCaC8%3D) | 0.60 zł | Resistor_SMD:R_2512_6332Metric_Pad1.40x3.35mm_HandSolder | Resistor, small symbol
R8, R9, R10, R37, R64, R65, | 6 | 49.9 | On Stan | 0.00 zł | Resistor_SMD:R_0402_1005Metric_Pad0.72x0.64mm_HandSolder | Resistor
R11, R12, R14, R15, R21, | 5 | 715k | 667-ERA-6AEB7153V (https://www.mouser.pl/ProductDetail/Panasonic/ERA-6AEB7153V) | 2.50 zł | Resistor_SMD:R_0805_2012Metric_Pad1.20x1.40mm_HandSolder | Resistor
R13, | 1 | 10k, 0.1% | 667-ERA-3AEB103V (https://www.mouser.pl/ProductDetail/Panasonic/ERA-3AEB103V) | 2.50 zł | Resistor_SMD:R_0603_1608Metric_Pad0.98x0.95mm_HandSolder | Resistor
R16, R17, | 2 | 94.2 | RN73H1JTTD94R2F50 (https://www.mouser.pl/ProductDetail/KOA-Speer/RN73H1JTTD94R2F50?qs=pJKkPLTLvBgHgE4xusW2QQ%3D%3D) | 4.00 zł | Resistor_SMD:R_0603_1608Metric_Pad0.98x0.95mm_HandSolder | Resistor
R18, R24, R25, R35, | 4 | 47k | On Stan | 0.00 zł | Resistor_SMD:R_0603_1608Metric_Pad0.98x0.95mm_HandSolder | Resistor
R19, R36, | 2 | 1k | On Stan | 0.00 zł | Resistor_SMD:R_0603_1608Metric_Pad0.98x0.95mm_HandSolder | Resistor
R20, R27, R28, R31, R41, R69, R70, R71, R72, R73, R80, | 11 | 10k | On Stan | 0.00 zł | Resistor_SMD:R_0603_1608Metric_Pad0.98x0.95mm_HandSolder | Resistor
R22, R23, | 2 | 10 | RCA060310R0FKEAHP (https://www.mouser.pl/ProductDetail/Vishay-Draloric/RCA060310R0FKEAHP) | 2.30 zł | Resistor_SMD:R_0603_1608Metric_Pad0.98x0.95mm_HandSolder | Resistor
R26, R29, R30, R32, R33, R34, | 6 | 680 | On Stan | 0.00 zł | Resistor_SMD:R_0603_1608Metric_Pad0.98x0.95mm_HandSolder | Resistor
R38, | 1 | 12.1k | RT0603FRE0712K1L (https://www.mouser.pl/ProductDetail/YAGEO/RT0603FRE0712K1L?qs=sGAEpiMZZMtlubZbdhIBILjYW2Gkblj8tpC0PfbogpM%3D) | 0.60 zł | Capacitor_SMD:C_0603_1608Metric_Pad1.08x0.95mm_HandSolder | Resistor, small symbol
R39, R40, | 2 | 33 | On Stan | 0.00 zł | Resistor_SMD:R_0603_1608Metric_Pad0.98x0.95mm_HandSolder | Resistor
R42, R43, R44, R45, R46, R47, R48, R56, R57, R58, R59, | 11 | 56 | RT0402DRE0756RL (https://www.mouser.pl/ProductDetail/YAGEO/RT0402DRE0756RL?qs=gY0y7AQI9SNTJcw5GpBL1g%3D%3D) | 2.00 zł | Resistor_SMD:R_0402_1005Metric | Resistor, small symbol
R49, R61, | 2 | 1.5k | MCS04020C1501FE000 (https://www.mouser.pl/ProductDetail/Vishay-Beyschlag/MCS04020C1501FE000?qs=7ZE6F4QMOBb1CssuhAOnZw%3D%3D) | 1.00 zł | Resistor_SMD:R_0402_1005Metric | Resistor, small symbol
R50, R51, R52, R53, R54, R55, | 6 | 100 | RR0510P-101-D (https://www.mouser.pl/ProductDetail/Susumu/RR0510P-101-D?qs=sGAEpiMZZMtlubZbdhIBIHPiT0YkkodQvbyWB4riPVA%3D) | 2.00 zł | Resistor_SMD:R_0402_1005Metric_Pad0.72x0.64mm_HandSolder | Resistor, small symbol
R60, | 1 | 4.7k | MCS04020C4701FE000 (https://www.mouser.pl/ProductDetail/Vishay-Beyschlag/MCS04020C4701FE000?qs=wTZ%2FFzl837ZcJxw4gRO3jA%3D%3D) | 1.00 zł | Resistor_SMD:R_0402_1005Metric | Resistor, small symbol
R67, R74, R75, R76, | 4 | 150 | On Stan | 0.00 zł | Resistor_SMD:R_0603_1608Metric_Pad0.98x0.95mm_HandSolder | Resistor
R_SHUNT2, | 1 | 25m | 279-TLRP3A30DR025FTE (https://www.mouser.pl/ProductDetail/TE-Connectivity-Holsworthy/TLRP3A30DR025FTE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) | 2.00 zł | Resistor_SMD:R_2512_6332Metric | Resistor
RESET1, | 1 | RESET_SW | On Stan | 0.00 zł | Button_Switch_SMD:SW_DIP_SPSTx01_Slide_9.78x4.72mm_W8.61mm_P2.54mm | Push button switch, generic, two pins
RV1, RV2, RV3, | 3 | Varistor | MOVS4032V230 (https://www.mouser.pl/ProductDetail/Eaton-Electronics/MOVS4032V230?qs=CiayqK2gdcIfc2V9FwqqWg%3D%3D) | 17.00 zł | Resistor_SMD:R_4020_10251Metric_Pad1.65x5.30mm_HandSolder | Voltage dependent resistor
T1, | 1 | ALANL100X1-DE12DT | 815-ALANL100X1DE12DT (https://www.mouser.pl/ProductDetail/ABRACON/ALANL100X1-DE12DT?qs=BJlw7L4Cy79emB2iS%2FU5sA%3D%3D) | 10.00 zł | ETH_MAG:SOIC12_ALANL100X1_ABR
U1, | 1 | STM32H750VBTx | STM32H750VBT6 (https://www.mouser.pl/ProductDetail/STMicroelectronics/STM32H750VBT6?qs=%252BEew9%252B0nqrBAeuu%2FsQQSzQ%3D%3D) | 36.00 zł | Package_QFP:LQFP-100_14x14mm_P0.5mm
U2, | 1 | DSC1001DI1-025.0000 | 998-1001DI1-025.0000 (https://www.mouser.pl/ProductDetail/Microchip-Technology/DSC1001DI1-025.0000?qs=moDRE%2FDosU0aQZ7kAZYZlg%3D%3D) | 3.00 zł | 25MHz:CDFN4_2P5X2_MCH
U3, | 1 | AMC3306M25DWE | AMC3306M25DWER (https://www.mouser.pl/ProductDetail/Texas-Instruments/AMC3306M25DWER) | 32.00 zł | AMC:DWE0016A-IPC_A
U4, | 1 | TPS259620DDAR | 595-TPS259620DDAR (https://www.mouser.pl/ProductDetail/Texas-Instruments/TPS259620DDAR?qs=XeJtXLiO41RogCpRV1l%252BSg%3D%3D) | 3.00 zł | TI_TPS:SOIC_20DDAR_TEX
U5, | 1 | AMC3336 | AMC3336DWER (https://www.mouser.pl/ProductDetail/Texas-Instruments/AMC3336DWER?qs=TuK3vfAjtkUFYNEetxZbpg%3D%3D) | 38.00 zł | Package_SO:SOIC-16W_7.5x10.3mm_P1.27mm
U6, | 1 | USBLC6-4SC6 | 511-USBLC6-4SC6Y (https://www.mouser.pl/ProductDetail/STMicroelectronics/USBLC6-4SC6Y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) | 1.50 zł | Package_TO_SOT_SMD:SOT-23-6
U7, | 1 | TLV1117-33 | 595-TLV1117LV33DCYR (https://www.mouser.pl/ProductDetail/Texas-Instruments/TLV1117LV33DCYR?qs=tEz3BkPb1rwzXMb8FiWhow%3D%3D) | 1.00 zł | Package_TO_SOT_SMD:SOT-223-3_TabPin2
 |  |  |  | 236.80 zł
 |  | analog switch | SN74LVC2G66DCUR (https://www.mouser.pl/ProductDetail/Texas-Instruments/SN74LVC2G66DCUR?qs=N6WZOzgtpqWMpNL31DMvDQ%3D%3D) | 2zl
