martinrybka2000/openacme-pfm/v1.0/PCB/PFM_9/gerber/PFM-F_Cu.dxf

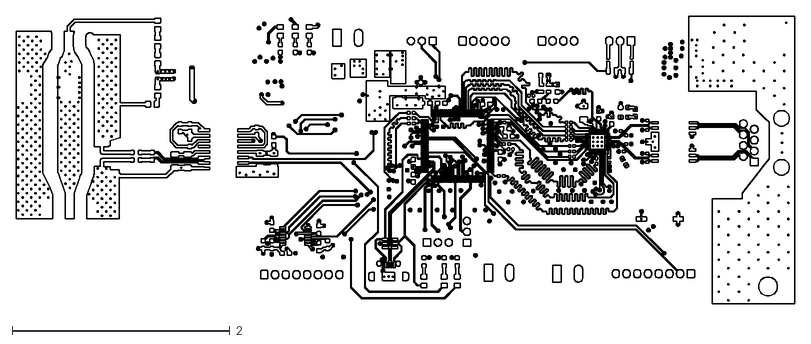
[picture p206: CAD file, 2026-10-15]
v1.0/PCB/PFM_9/gerber/PFM-F_Cu.dxf
7.15 x 2.64
