martinrybka2000/openacme-pfm/v1.0/PCB/PFM_9/gerber/PFM-In1_Cu.dxf

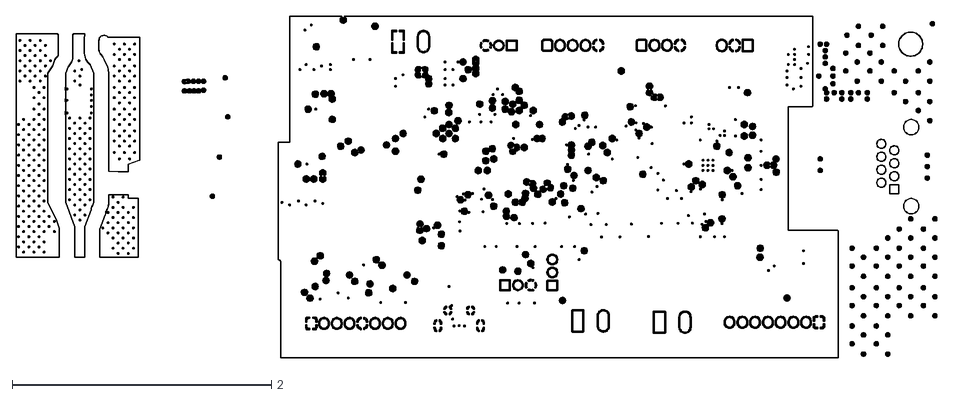
[picture p207: CAD file, 2026-10-15]
v1.0/PCB/PFM_9/gerber/PFM-In1_Cu.dxf
7.11 x 2.64
