martinrybka2000/openacme-pfm/v1.0/PCB/PFM_9/gerber/PFM-Edge_Cuts.dxf

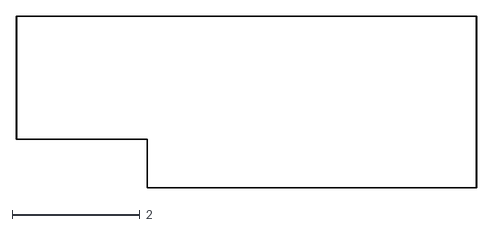
[picture p210: CAD file, 2026-10-15]
v1.0/PCB/PFM_9/gerber/PFM-Edge_Cuts.dxf
7.20 x 2.68
