martinrybka2000/openacme-pfm/(list of files, cad)

Other CAD files:
v1.0/PCB/PFM_9/gerber/PFM-B_Mask.dxf
v1.0/PCB/PFM_9/gerber/PFM-B_Paste.dxf
v1.0/PCB/PFM_9/gerber/PFM-B_Silkscreen.dxf
v1.0/PCB/PFM_9/gerber/PFM-F_Mask.dxf
v1.0/PCB/PFM_9/gerber/PFM-F_Paste.dxf
v1.0/PCB/PFM_9/gerber/PFM-F_Silkscreen.dxf
