martinrybka2000/openacme-pfm/docs/user-guide/building.md

# Building

TBD — will cover:

- **Firmware:** prerequisites (arm-none-eabi-gcc, CMake, STM32CubeMX), configure + build + flash.
- **Hardware:** KiCad 9 project, generate Gerbers/BOM, order boards (e.g. JLCPCB).
- **Host app:** build/install instructions.

See `.github/workflows/` for CI examples.
