martinrybka2000/openacme-pfm/v1.0/pomiary/kalibracja I/calib_I_results.txt

Parametr;Wartość Wzorcowa;Średnia Wyliczona;Błąd (Śr-Wz);Odchylenie (+);Odchylenie (-)
Natężenie prądu [A];-20,000000;-20,024663;-0,024663;0,027942;0,015656
Natężenie prądu [A];-16,000000;-16,016984;-0,016984;0,029402;0,017737
Natężenie prądu [A];-13,000000;-12,987395;0,012605;0,028898;0,017507
Natężenie prądu [A];-10,000000;-9,993285;0,006715;0,029435;0,016767
Natężenie prądu [A];-8,000000;-7,994962;0,005038;0,029861;0,016590
Natężenie prądu [A];-5,000000;-4,997280;0,002720;0,030739;0,016673
Natężenie prądu [A];-3,000000;-2,998196;0,001804;0,029511;0,016168
Natężenie prądu [A];-1,000000;-0,999581;0,000419;0,029313;0,015147
Natężenie prądu [A];1,000000;0,999055;-0,000945;0,013562;0,025744
Natężenie prądu [A];3,000000;2,997724;-0,002276;0,014694;0,025399
Natężenie prądu [A];5,000000;4,998199;-0,001801;0,014839;0,026541
Natężenie prądu [A];8,000000;7,994754;-0,005246;0,015246;0,026679
Natężenie prądu [A];10,000000;10,009238;0,009238;0,014596;0,026276
Natężenie prądu [A];13,000000;12,992380;-0,007620;0,017298;0,028865
Natężenie prądu [A];16,000000;16,020801;0,020801;0,015351;0,027769
