martinrybka2000/openacme-pfm/v1.0/pomiary/kalibracja U/calib_u_results.txt

Parametr;Wartość Wzorcowa;Średnia Wyliczona;Błąd (Śr-Wz);Odchylenie (+);Odchylenie (-)
Napięcie [V];-200,000000;-200,003836;-0,003836;0,150626;0,154916
Napięcie [V];-150,000000;-149,990878;0,009122;0,123080;0,120175
Napięcie [V];-100,000000;-99,999370;0,000630;0,072658;0,074658
Napięcie [V];-75,000000;-75,009715;-0,009715;0,074962;0,072995
Napięcie [V];-50,000000;-50,003096;-0,003096;0,069170;0,075689
Napięcie [V];-40,000000;-40,008186;-0,008186;0,085426;0,081337
Napięcie [V];-30,000000;-30,010122;-0,010122;0,068720;0,064713
Napięcie [V];-20,000000;-20,009521;-0,009521;0,056633;0,055966
Napięcie [V];-10,000000;-10,007029;-0,007029;0,059964;0,057550
Napięcie [V];0,000000;0,001013;0,001013;0,065222;0,064470
Napięcie [V];10,000000;10,004452;0,004452;0,059807;0,061233
Napięcie [V];20,000000;20,007213;0,007213;0,056992;0,057638
Napięcie [V];30,000000;30,007215;0,007215;0,067086;0,066560
Napięcie [V];40,000000;40,006403;0,006403;0,080023;0,075842
Napięcie [V];50,000000;50,000404;0,000404;0,073681;0,075454
Napięcie [V];75,000000;75,006875;0,006875;0,063232;0,067956
Napięcie [V];100,000000;99,996005;-0,003995;0,066487;0,073993
Napięcie [V];150,000000;149,991938;-0,008062;0,128194;0,126170
Napięcie [V];200,000000;199,999169;-0,000831;0,157340;0,152688
