martinrybka2000/openacme-pfm/v1.0/pomiary/Pomiary urzadzen/Grid/PC_stress_test.csv

Elapsed (s) | STM/U_rms/U_rms | STM/U_rms/U1_rms | STM/I_rms/I_rms | STM/I_rms/I1_rms | STM/Power/P | STM/Power/P1 | STM/Power/Q1 | STM/Power/S | STM/Power/S1 | STM/Power/Q | STM/Freq/Frequency | STM/THD/Voltage THD | STM/THD/Current THD | STM/Power factor/PF | STM/Power factor/DPF/Cos(fi) | STM/Power factor/DF | STM/AVG plots/avg Voltage | STM/AVG plots/avg Current | STM/All as data/avg Voltage | STM/All as data/avg Current | STM/All as data/U_rms | STM/All as data/U1_rms | STM/All as data/I_rms | STM/All as data/I1_rms | STM/All as data/Frequency | STM/All as data/P | STM/All as data/P1 | STM/All as data/Q | STM/All as data/Q1 | STM/All as data/S | STM/All as data/S1 | STM/All as data/THD voltage | STM/All as data/THD Current | STM/All as data/PF | STM/All as data/DPF/Cos(fi) | STM/All as data/DF | STM/All as data/peak Voltage | STM/All as data/peak Current | STM/Gaugages/avg Voltage | STM/Gaugages/avg Current | STM/Gaugages/PEAK Voltage | STM/Gaugages/PEAK Current | STM/THD/Voltage THD | STM/THD/Current THD | STM/RMS/U_rms | STM/RMS/U1_rms | STM/RMS/I_rms | STM/RMS/I1_rms | STM/Freq/Frequency | STM/Power/P | STM/Power/P1 | STM/Power/Q | STM/Power/Q1 | STM/Power/S | STM/Power/S1
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
