martinrybka2000/openacme-pfm/v1.0/pomiary/kalibracja I/8A.png

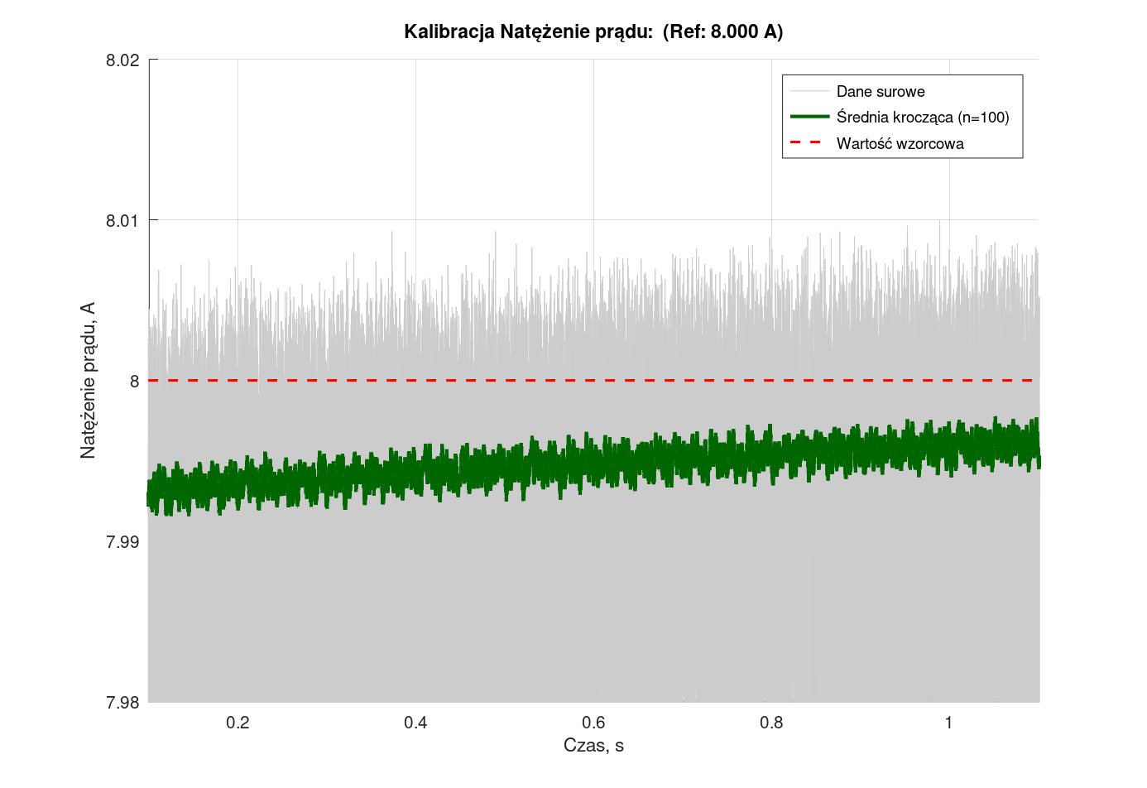
v1.0/pomiary/kalibracja I/8A.png
