martinrybka2000/openacme-pfm/v1.0/pomiary/kalibracja I/10A_drift.png

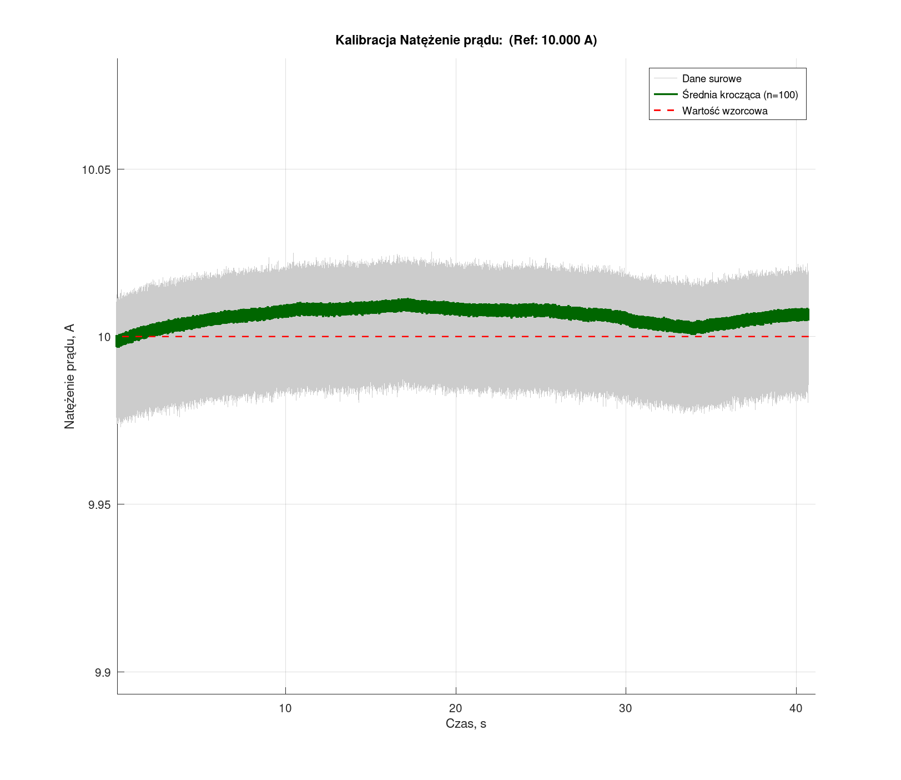
v1.0/pomiary/kalibracja I/10A_drift.png
