martinrybka2000/openacme-pfm/v1.0/pomiary/kalibracja I/16A_drift.png

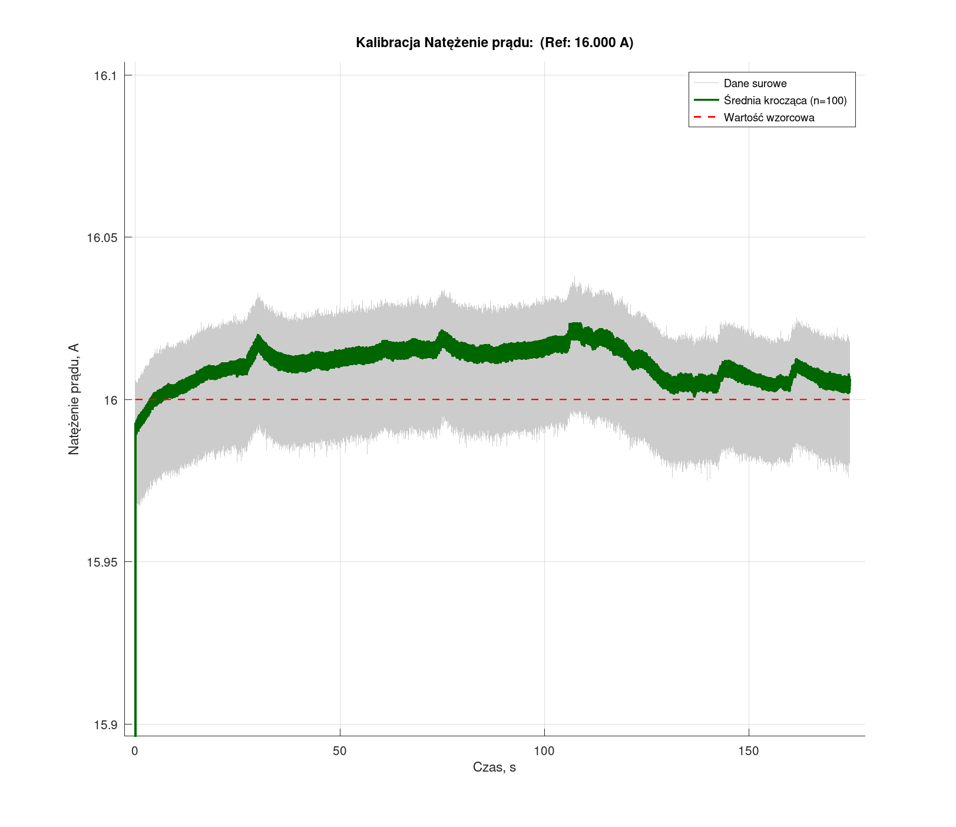
v1.0/pomiary/kalibracja I/16A_drift.png
