martinrybka2000/openacme-pfm/v1.0/pomiary/kalibracja I/-1A.png

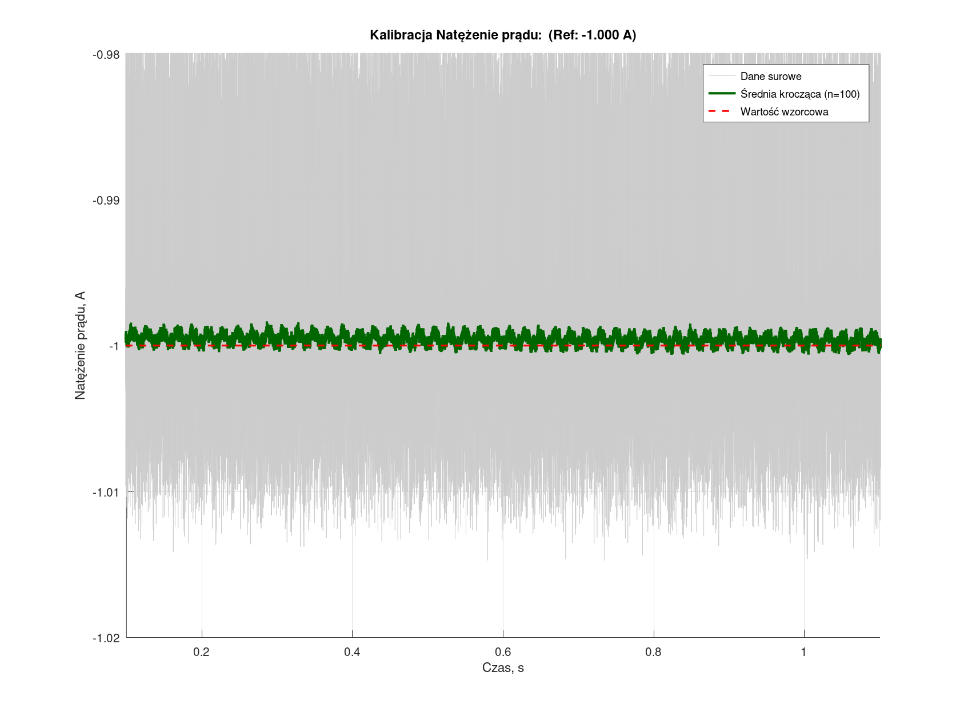
v1.0/pomiary/kalibracja I/-1A.png
