martinrybka2000/openacme-pfm/v1.0/pomiary/kalibracja I/-3A.png

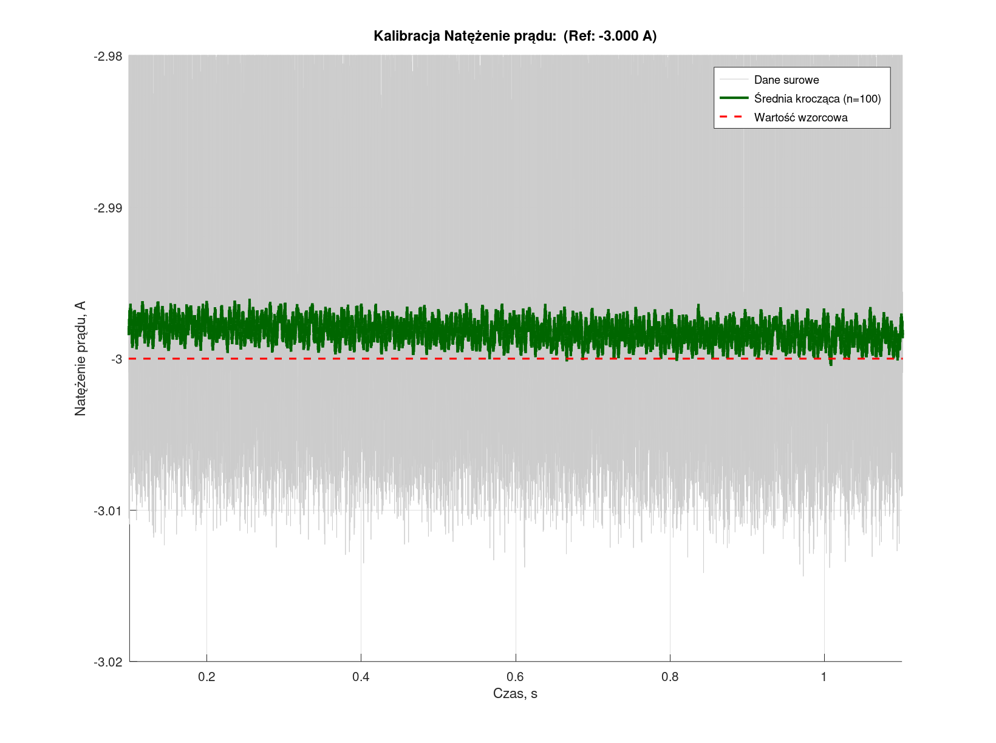
v1.0/pomiary/kalibracja I/-3A.png
