martinrybka2000/openacme-pfm/v1.0/pomiary/kalibracja I/Wyniki_wykres_lisniowy.png

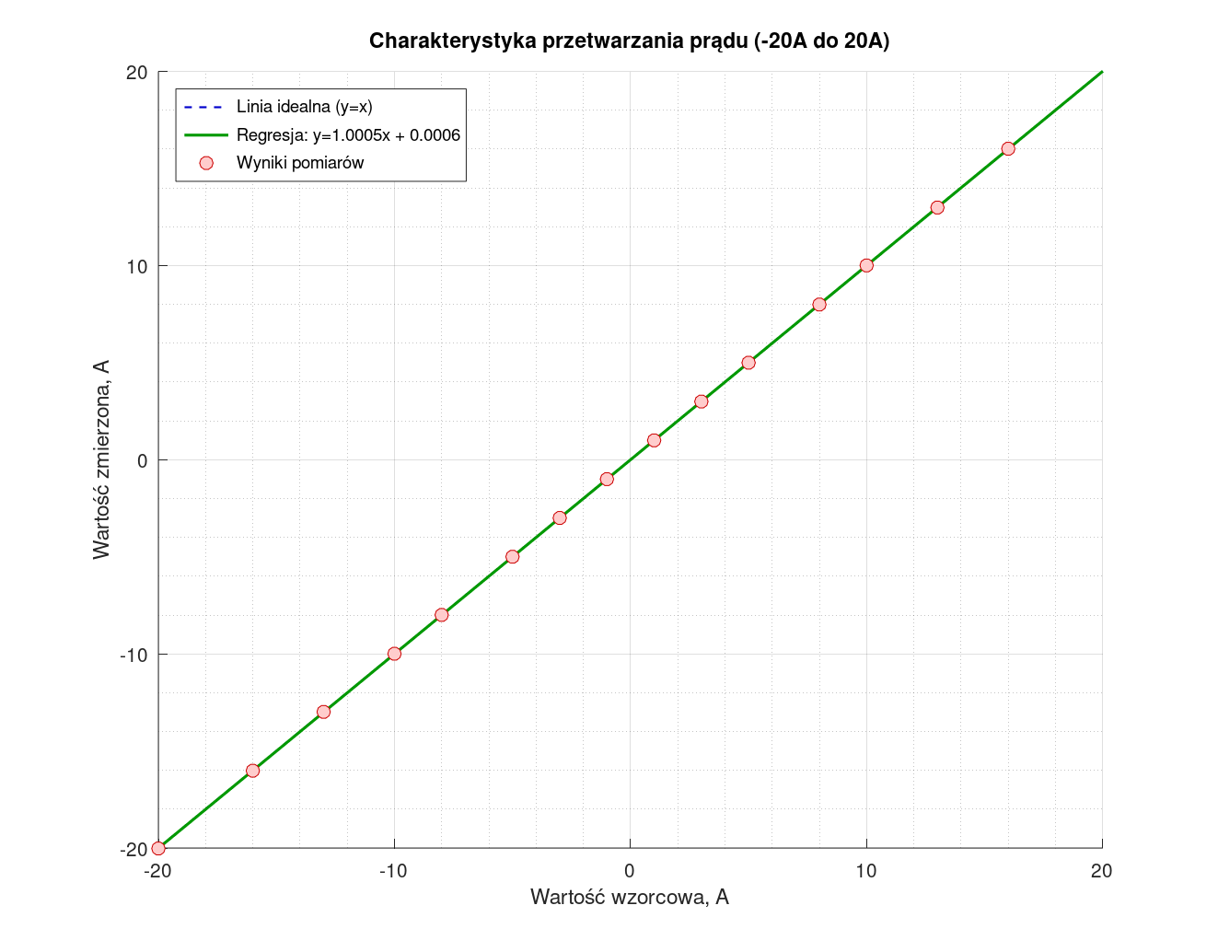
v1.0/pomiary/kalibracja I/Wyniki_wykres_lisniowy.png
