martinrybka2000/openacme-pfm/v1.0/pomiary/kalibracja U/0_2.png

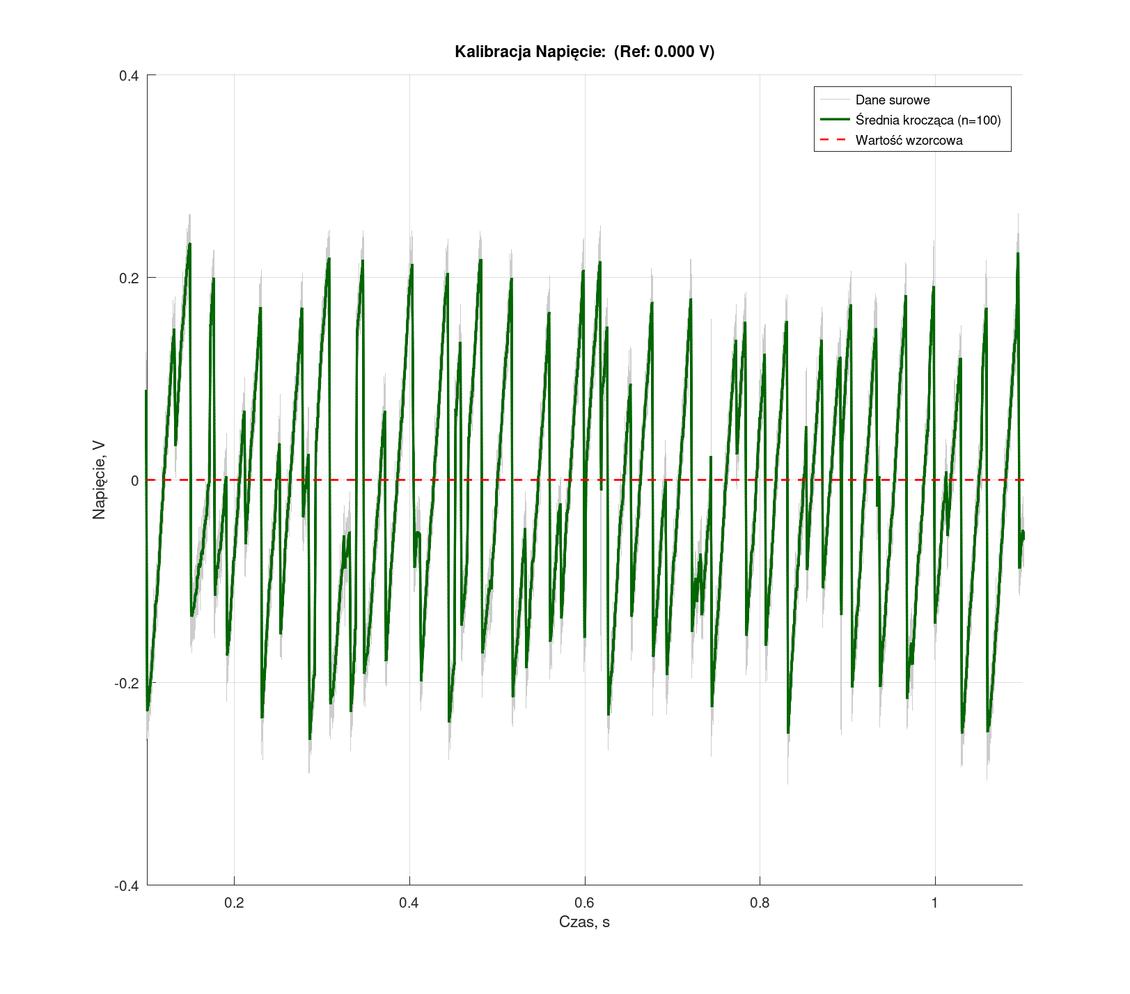
v1.0/pomiary/kalibracja U/0_2.png
