martinrybka2000/openacme-pfm/v1.0/pomiary/kalibracja U/30.png

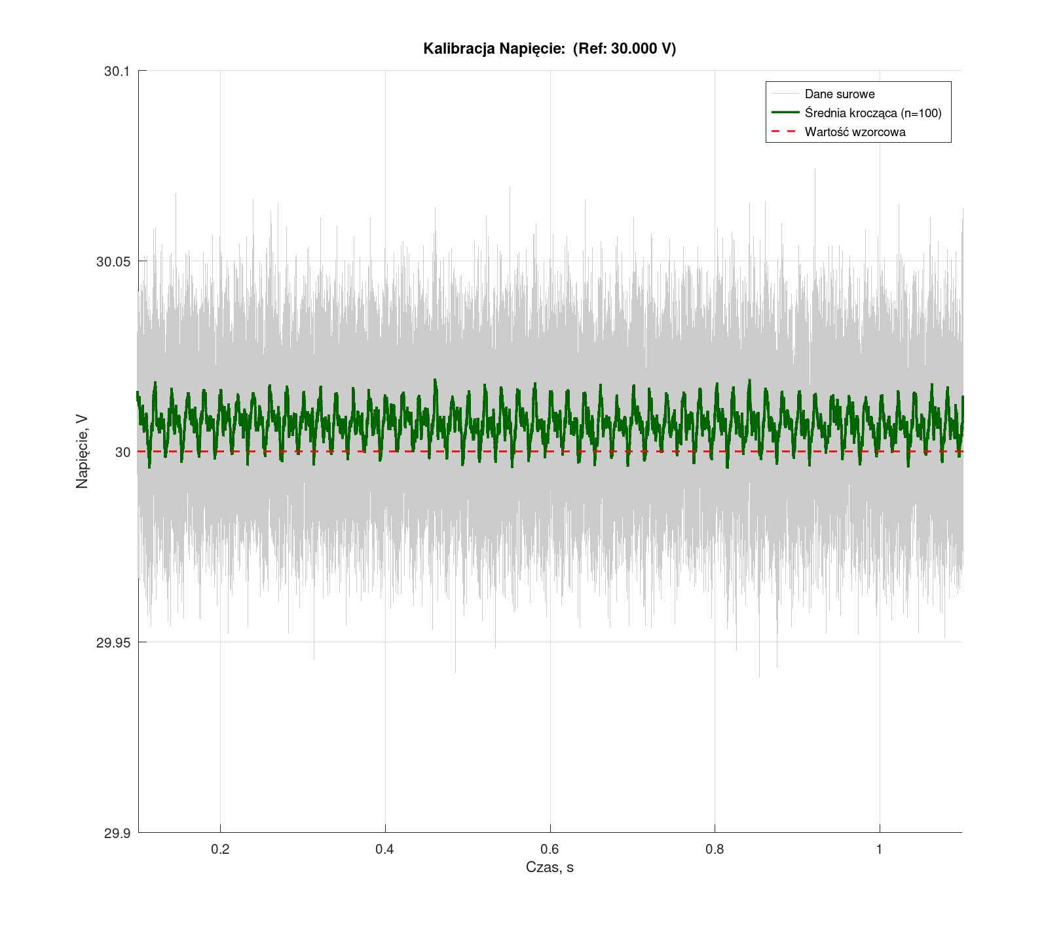
v1.0/pomiary/kalibracja U/30.png
