martinrybka2000/openacme-pfm/v1.0/pomiary/kalibracja U/Wyniki_wykres_liniowy.png

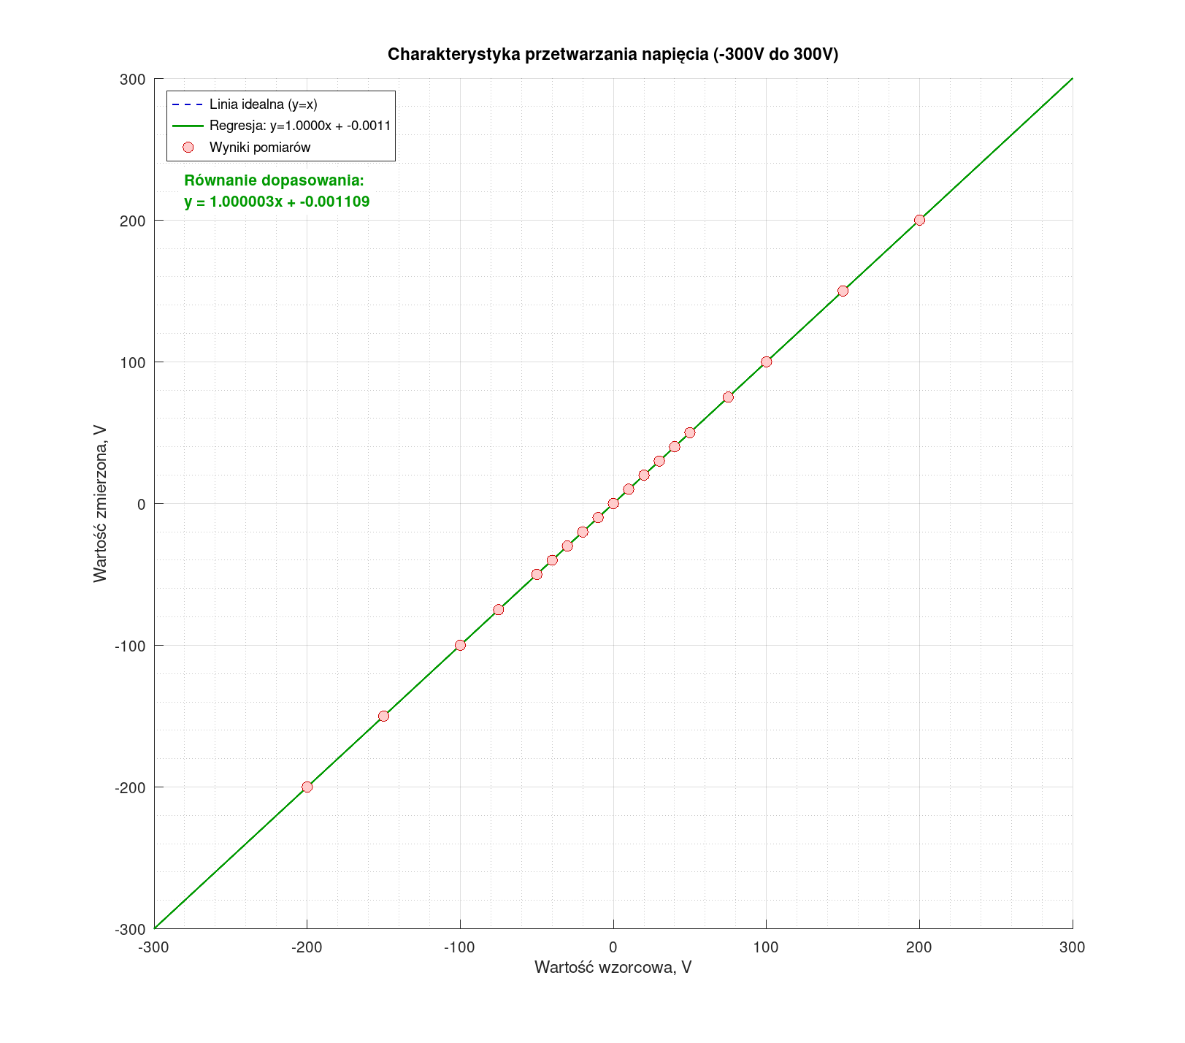
v1.0/pomiary/kalibracja U/Wyniki_wykres_liniowy.png
