martinrybka2000/openacme-pfm/CHANGELOG.md

# Changelog

All notable changes to this project are documented here.
Format follows [Keep a Changelog](https://keepachangelog.com/en/1.1.0/), versions follow [SemVer](https://semver.org/).

## [Unreleased]

### Added

- Repository skeleton: README, licences, docs, CI stubs, directory layout.
- Legacy V1.0 prototype + master's thesis preserved in `v1.0/` (reference dump).

## [0.1.0] - TBD

- Placeholder for the first V2.0 milestone.
