martinrybka2000/openacme-pfm/v1.0/PCB/PFM_9/pdfs/TOP_sec_third_BOT_merged_cropped.pdf

IC2 R26 1 | 2 | 3 | 4 | 5 | 6 1 | 2 | 3 | 4 | 5 | 6 ABCD | ABCD Date: KiCad E.D.A. 9.0.9 Size: A4 | Rev:

# IC2 R²⁶

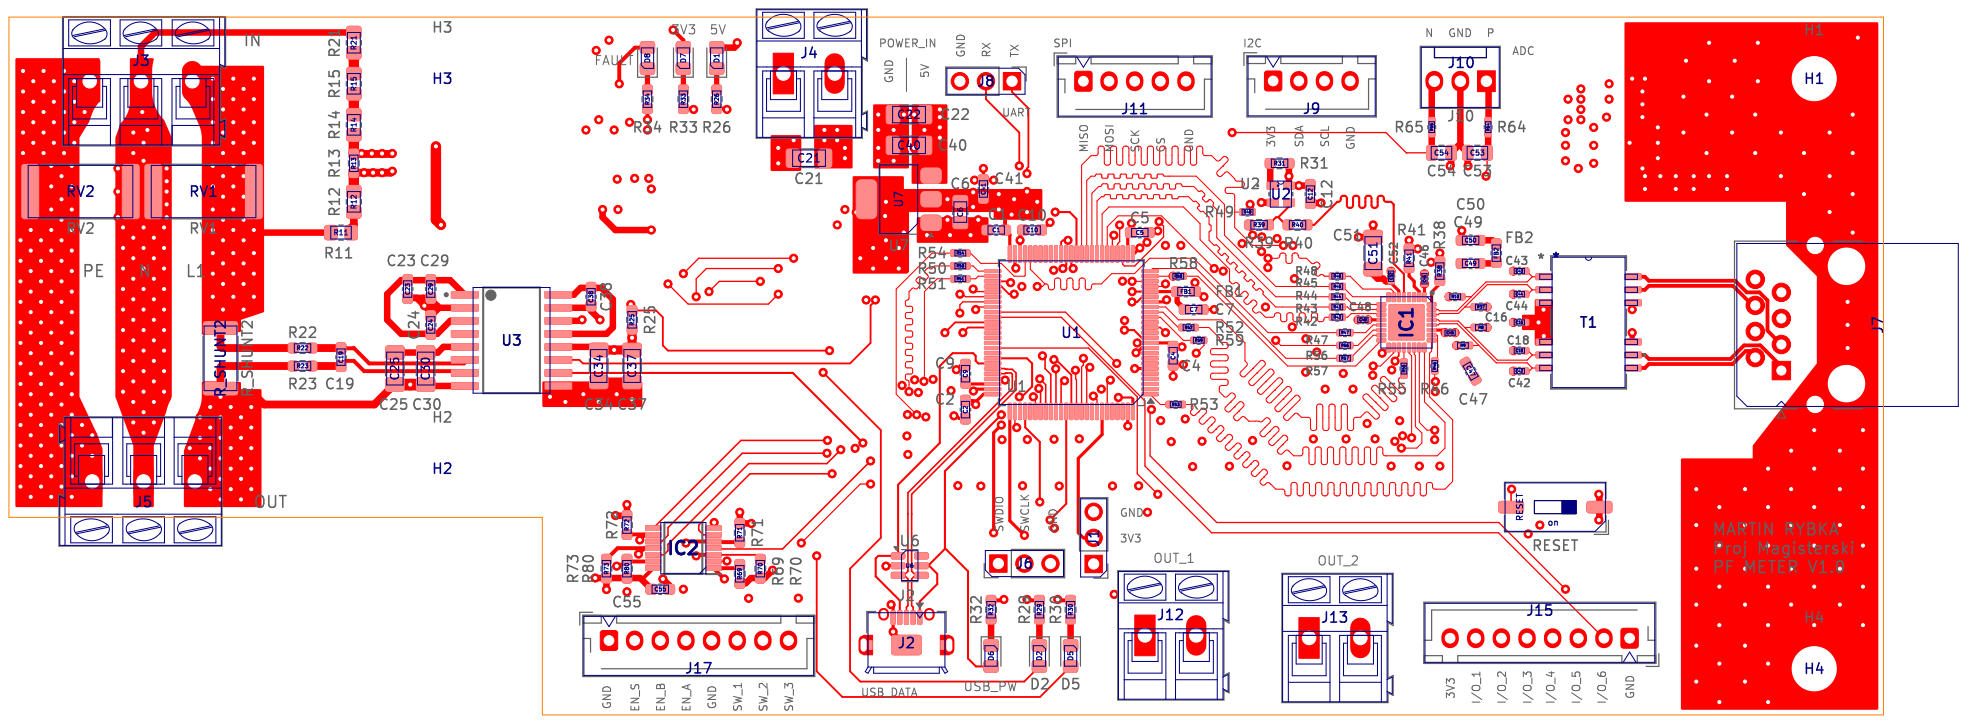
[picture p251: page 1]

Proj Magisterski PF METER V1.0 SWCLK GND

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

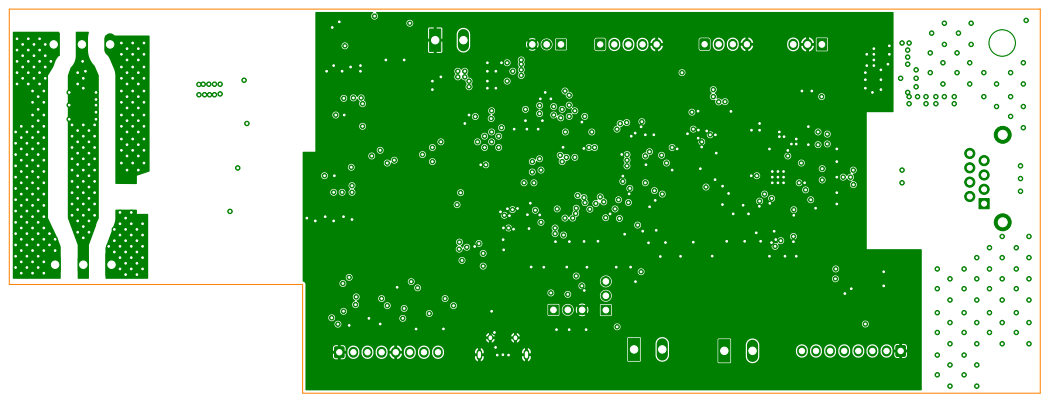
[picture p252: page 2]
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

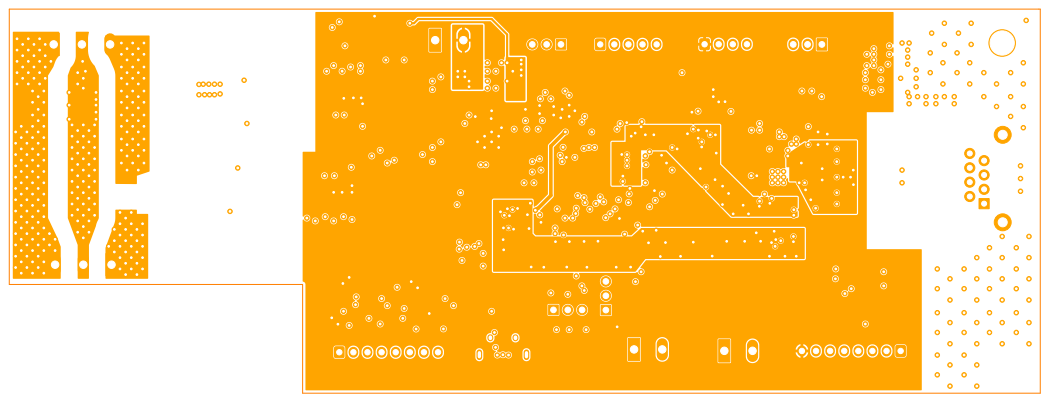
[picture p253: page 3]

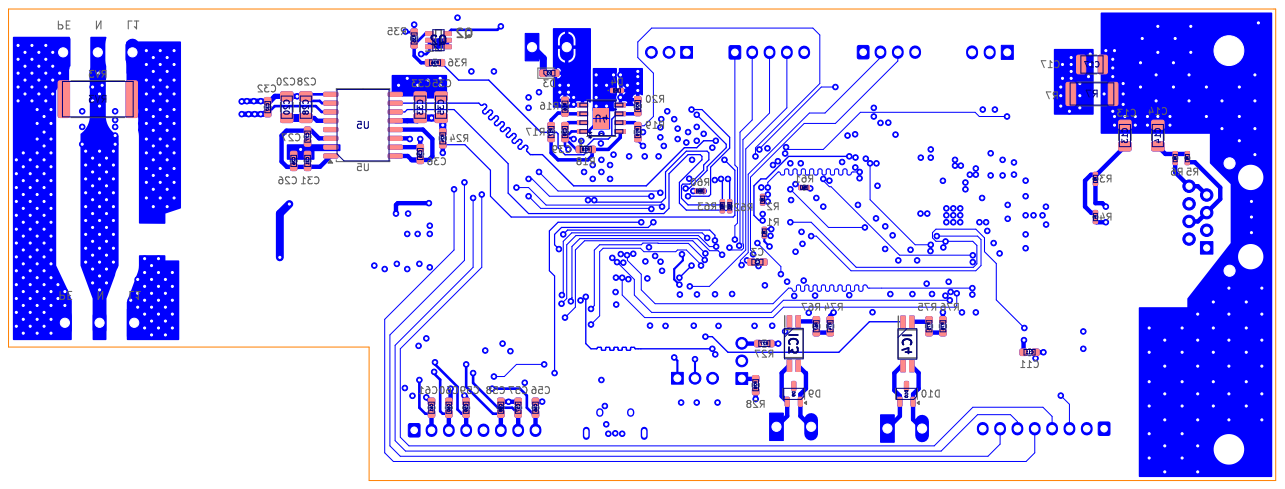
[picture p254: page 4]
