martinrybka2000/openacme-pfm/v1.0/PCB/PFM_9/pdfs/ilovepdf_extracted-pages/TOP_sec_third_BOT_merged_cropped-2.pdf

6 ABCD; ABCD Date: KiCad E.D.A. 9.0.9 Size: A4; Rev:
