martinrybka2000/openacme-pfm/v1.0/PCB/PFM_9/pdfs/sec/sec.pdf

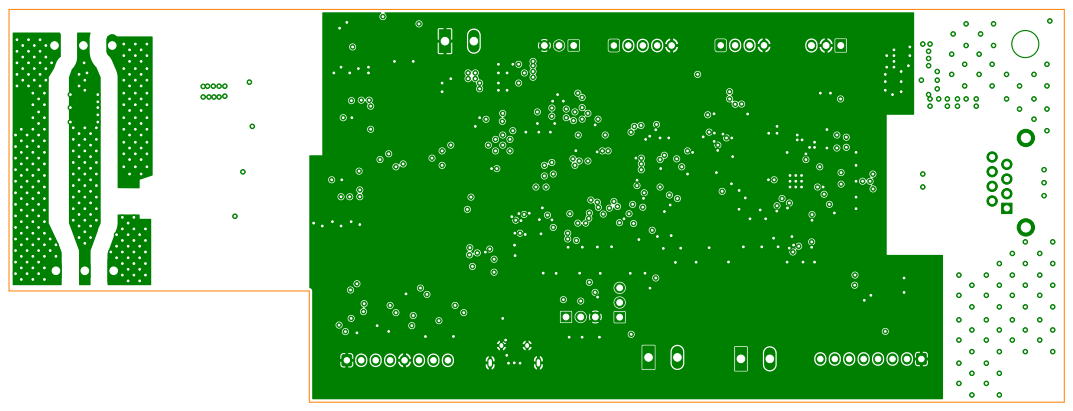
[picture p255: page 1]
D Date: KiCad; E.D.A. 9.0.9 Size: A4; Rev:; Id: /1 Title: File: PFM.kicad_pcb Sheet: Colored; Midd; - 2 Board2Pdf:; Colored; Page
