martinrybka2000/openacme-pfm/v1.0/PCB/PFM_9/pdfs/TOP/TOP.pdf

IC2 R26 1 | 2 | 3 | 4 | 5 | 6

A


Proj Magisterski PF METER V1.0 SWCLK GND

Id: /1 Title: File: PFM.kicad_pcb Sheet: Colored TOP RED
