martinrybka2000/openacme-pfm/v1.0/PCB/PFM_9/PFM/PNGs/PFM-GRID_ADCs1.pdf

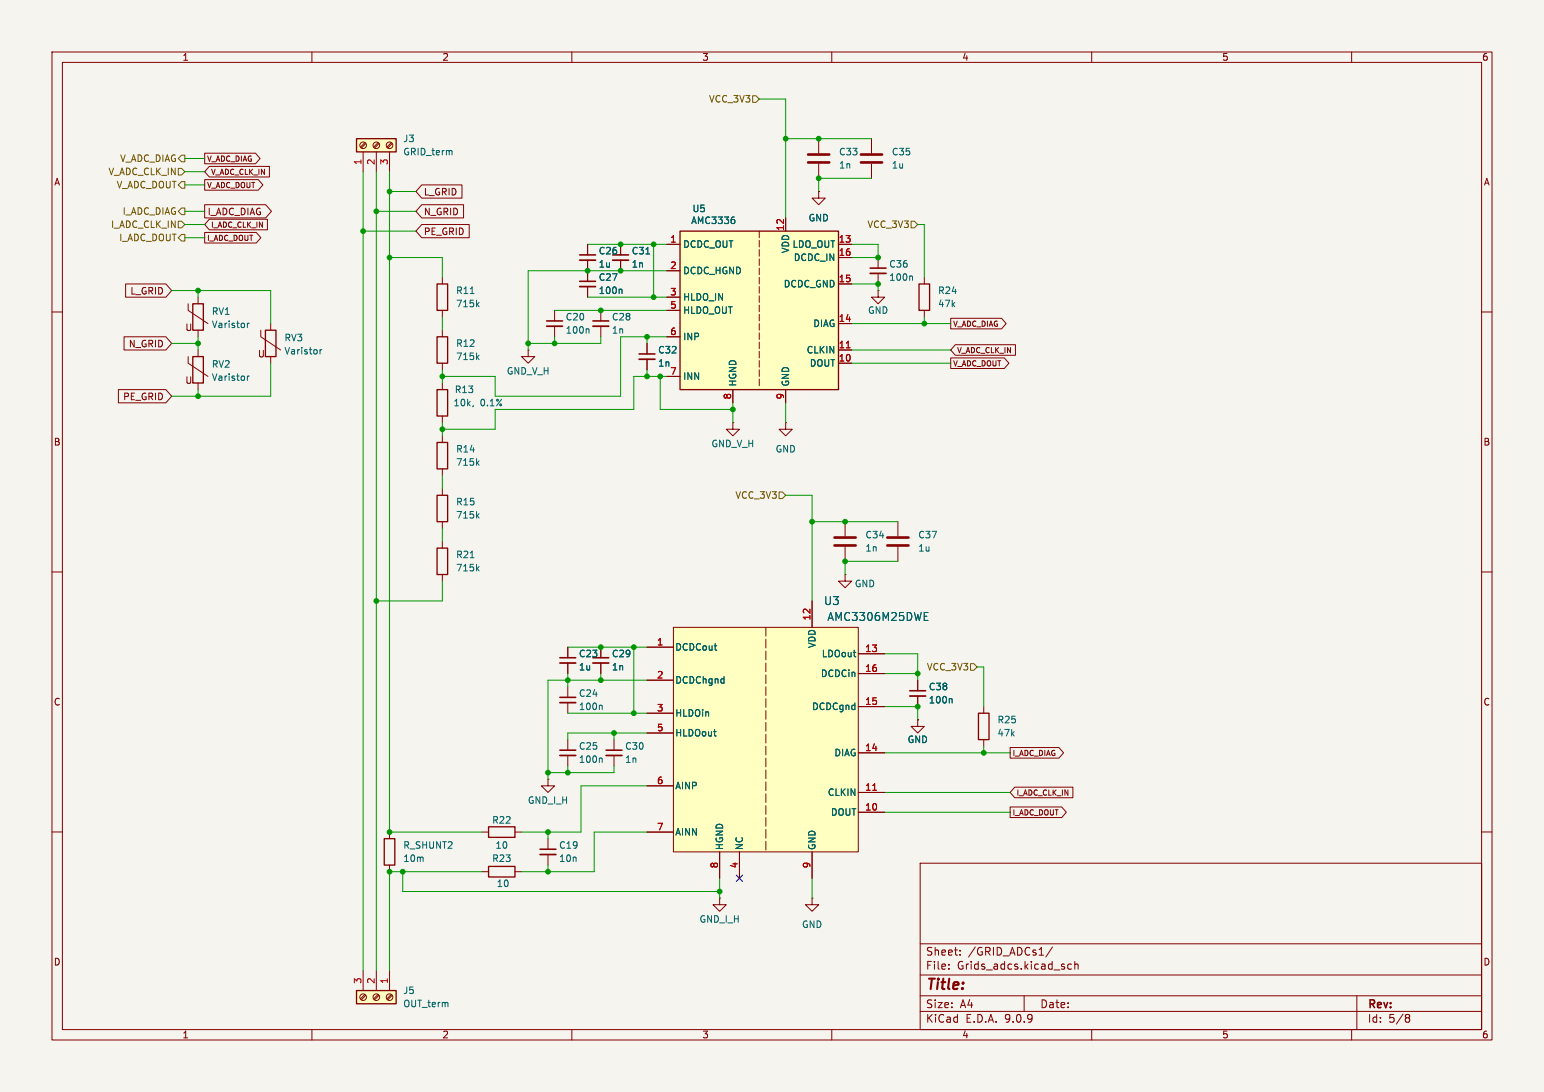
[picture p256: page 1]

Id: 5/8 Title: File: Grids_adcs.kicad_sch Sheet: /GRID_ADCs1/ C29
