martinrybka2000/openacme-pfm/v1.0/PCB/PFM_9/PFM/PNGs/PFM-STM33-Buttons.pdf

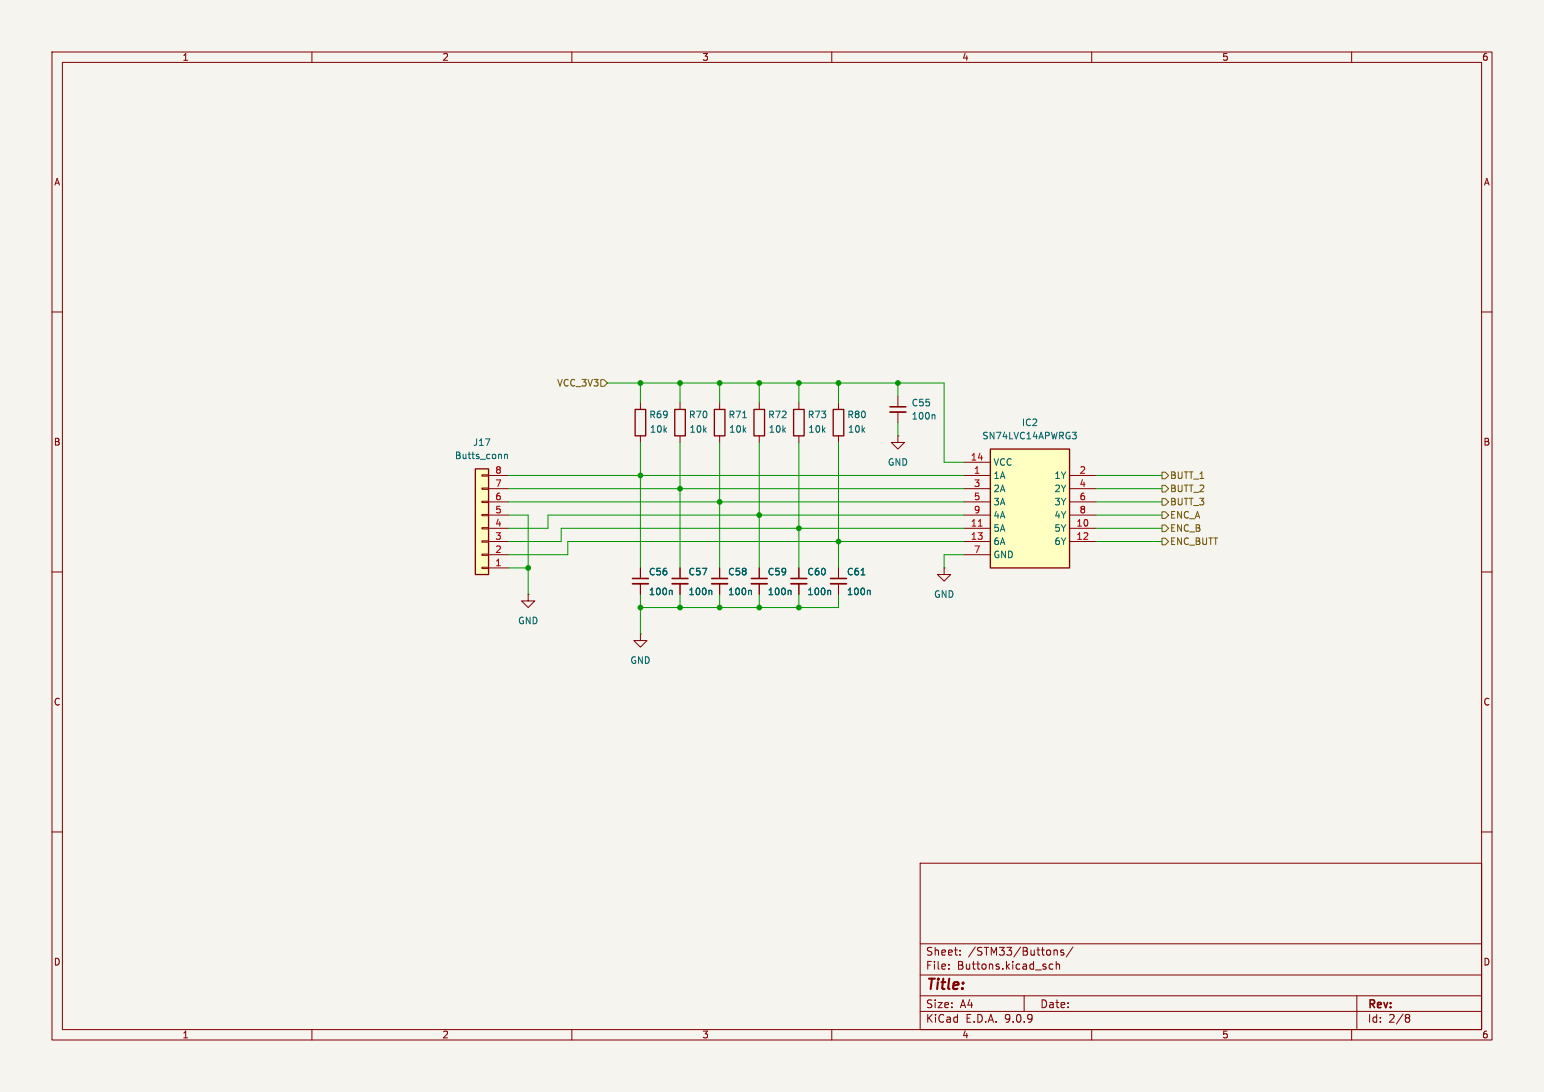
[picture p257: page 1]

Id: 2/8 Title: File: Buttons.kicad_sch Sheet: /STM33/Buttons/ GND

6 | | 3A 5
5 | | 4A 9
