martinrybka2000/openacme-pfm/v1.0/PCB/PFM_9/PFM/PNGs/PFM-STM33-Ethernet.pdf

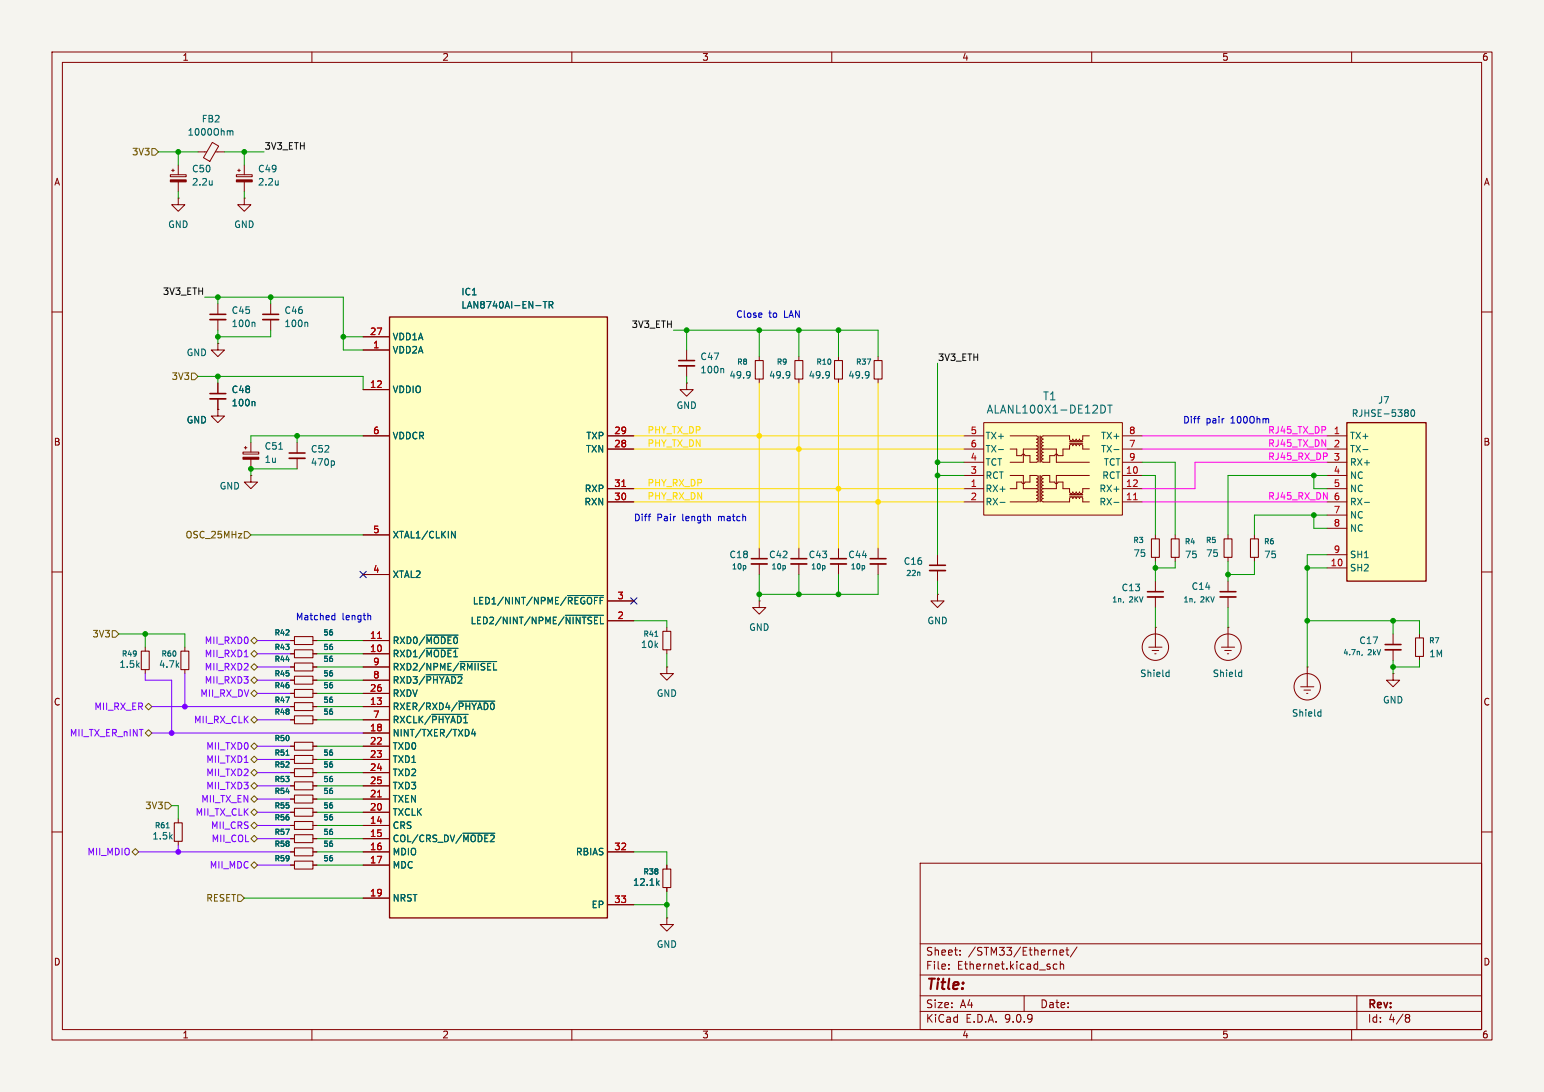
[picture p258: page 1]

Id: 4/8 Title: File: Ethernet.kicad_sch Sheet: /STM33/Ethernet/ GND
