martinrybka2000/openacme-pfm/v1.0/PCB/PFM_9/PFM/PNGs/PFM-STM33-EXT_OUT.pdf

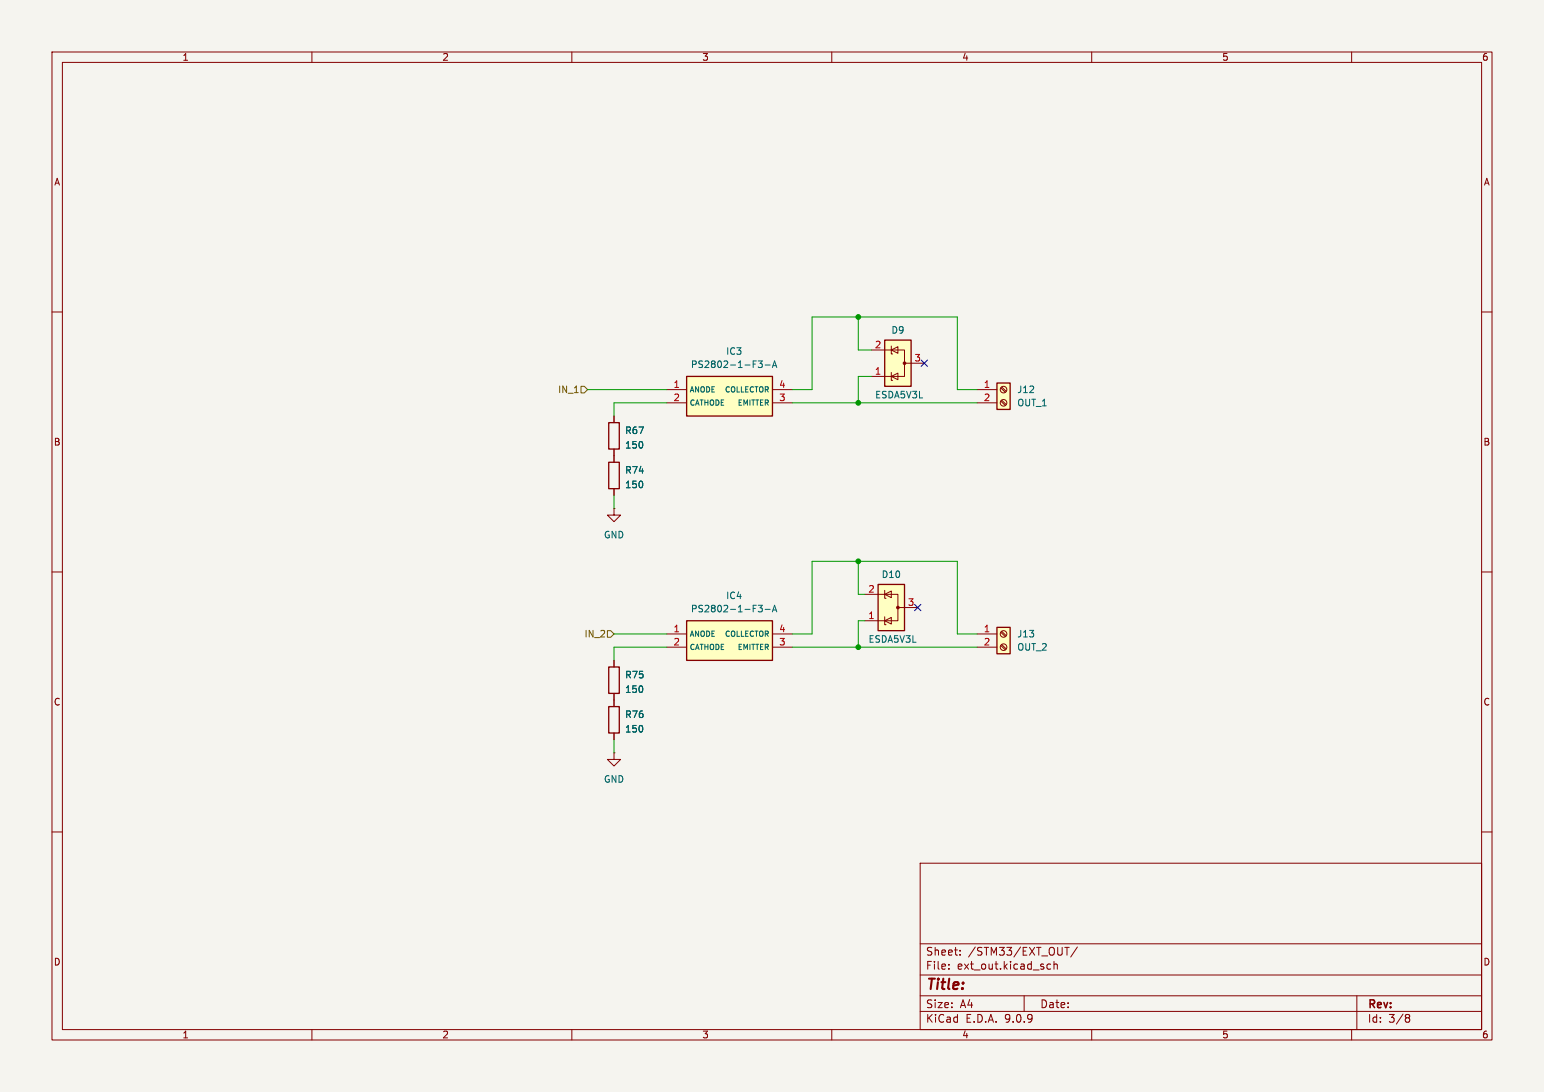
[picture p259: page 1]

Id: 3/8 Title: File: ext_out.kicad_sch Sheet: /STM33/EXT_OUT/
