martinrybka2000/openacme-pfm/v1.0/PCB/PFM_9/PFM/PNGs/PFM-STM33-USB_FS.pdf

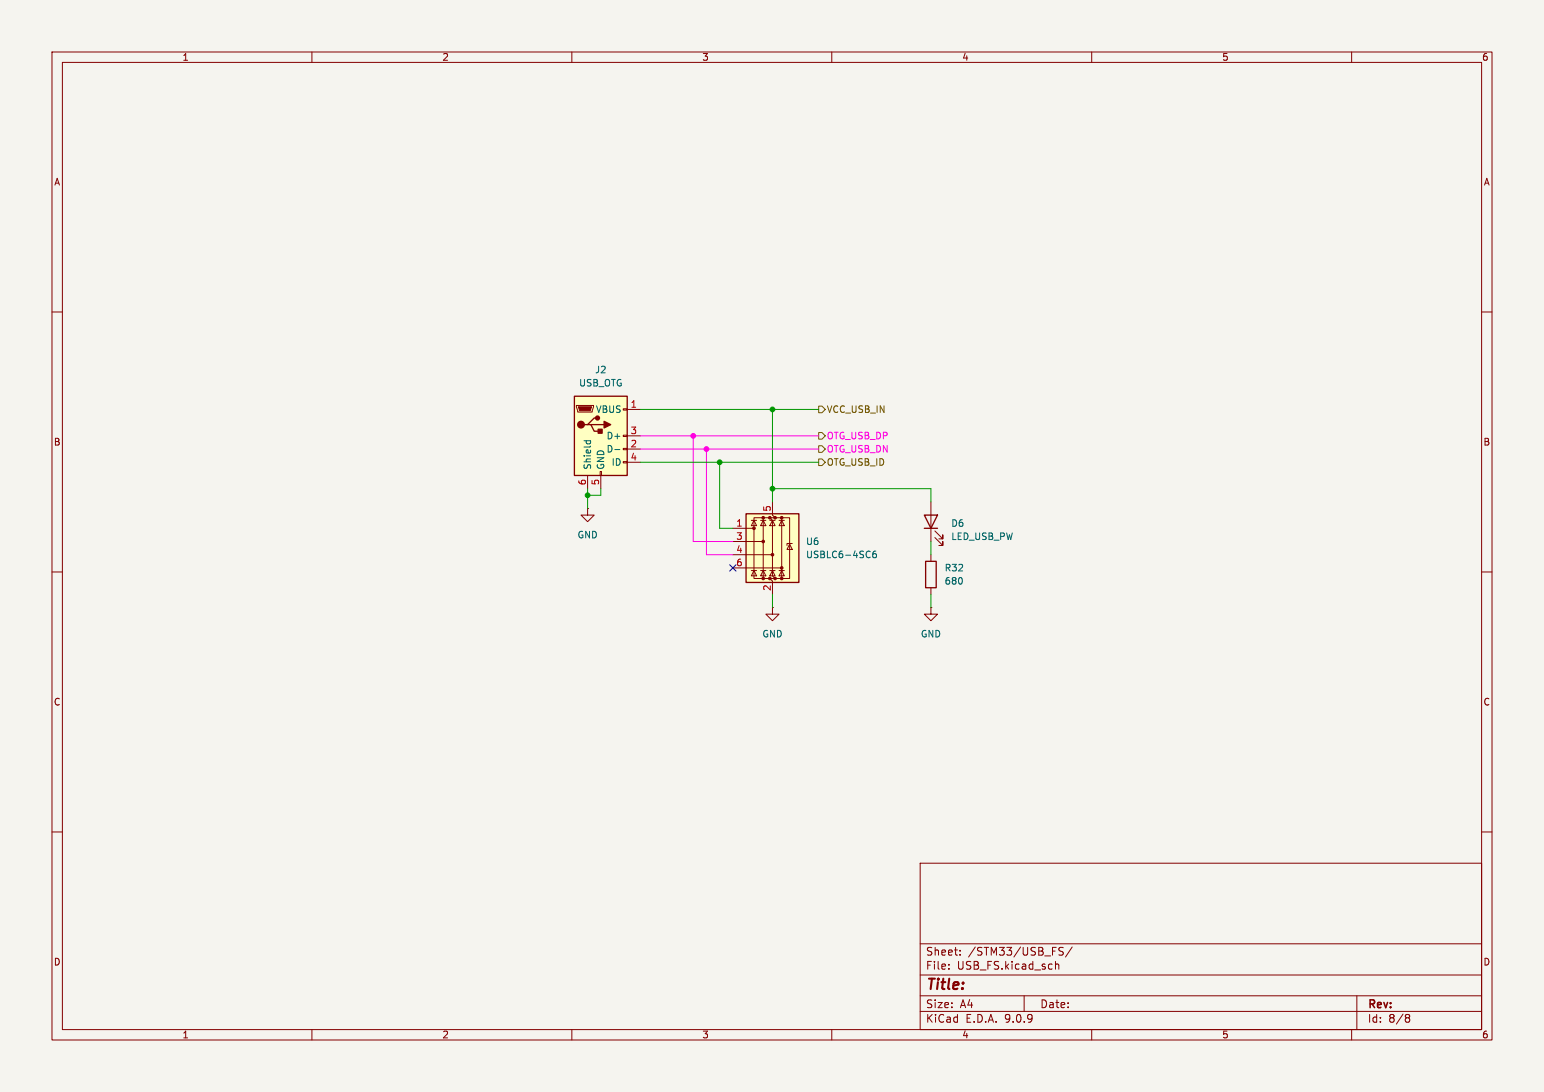
[picture p260: page 1]

Id: 8/8 Title: File: USB_FS.kicad_sch Sheet: /STM33/USB_FS/ R32
