martinrybka2000/openacme-pfm/v1.0/PCB/PFM_9/PFM/PNGs/PFM.pdf

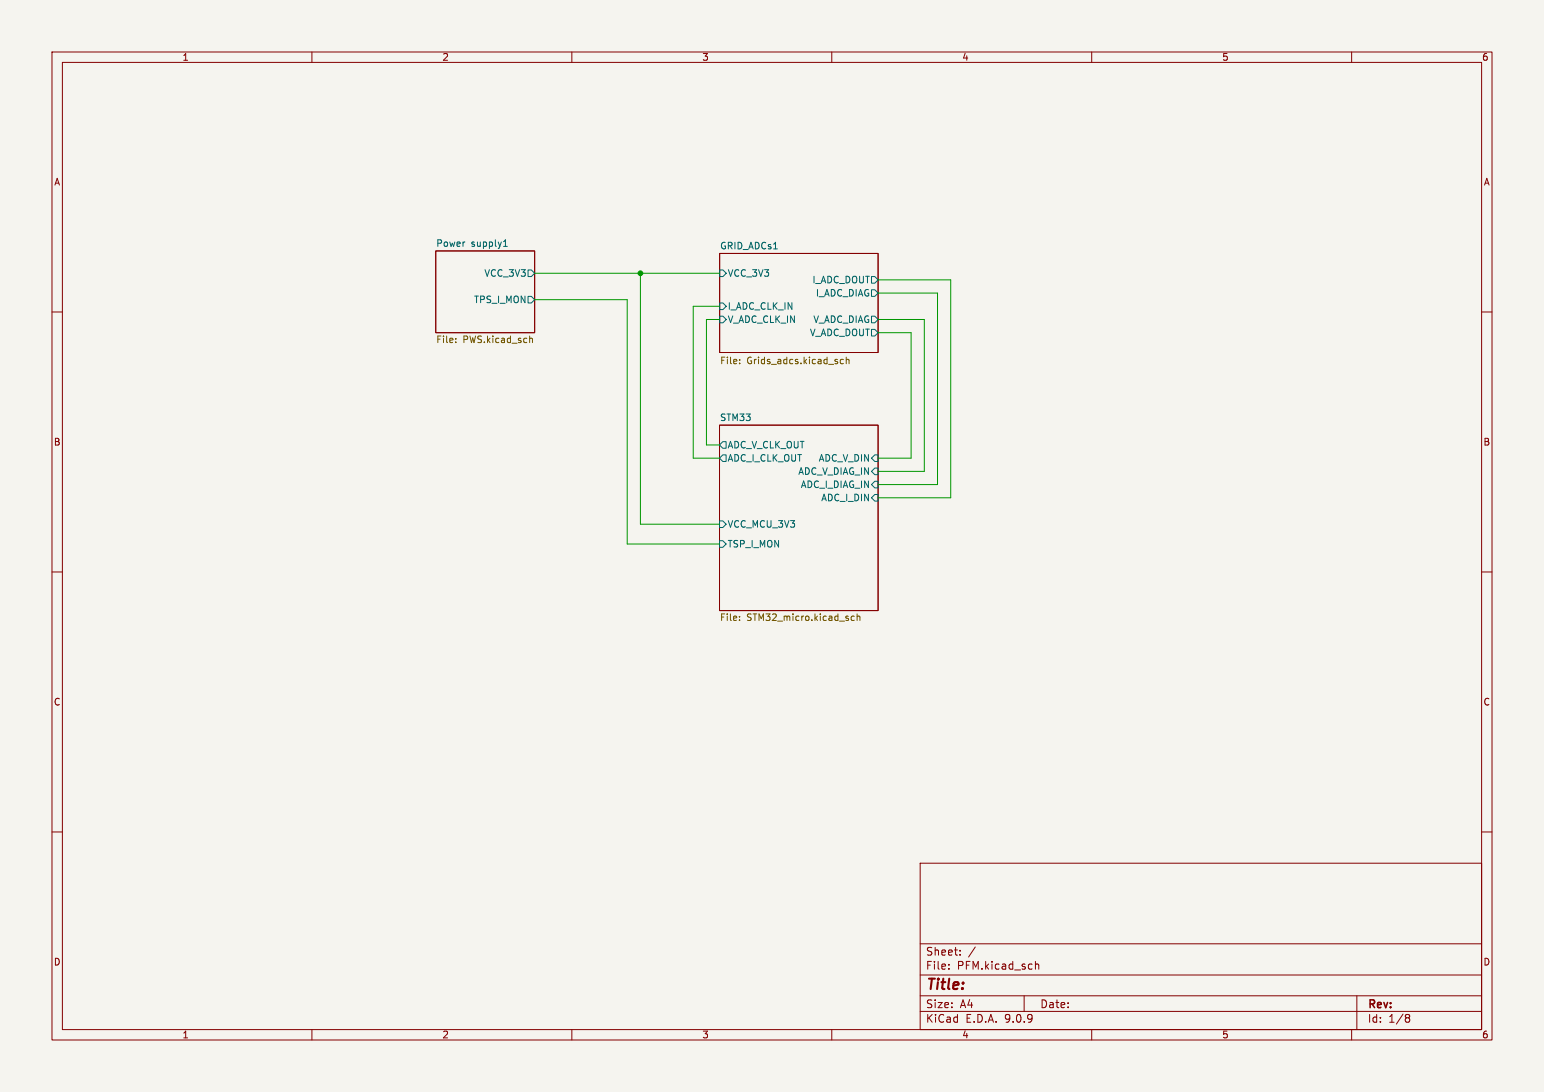
[picture p261: page 1]

Id: 1/8 Title: File: PFM.kicad_sch Sheet: /
