martinrybka2000/openacme-pfm/v1.0/PCB/PFM_9/pdfs/BOT/BOT.pdf

A

A

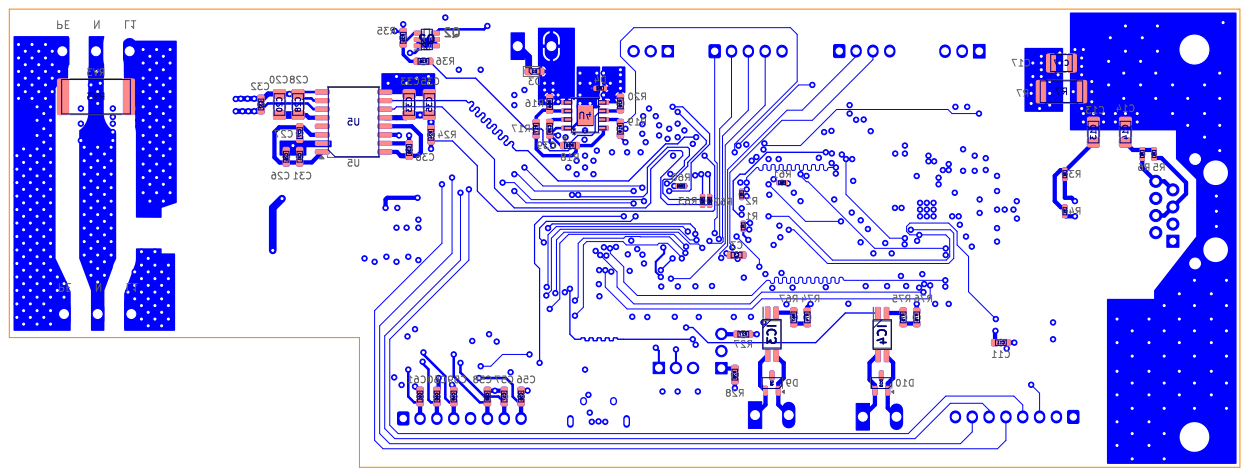
[picture p262: page 1]
