martinrybka2000/openacme-pfm/v1.0/PCB/PFM_9/PFM/PNGs/PFM-Power supply1.pdf

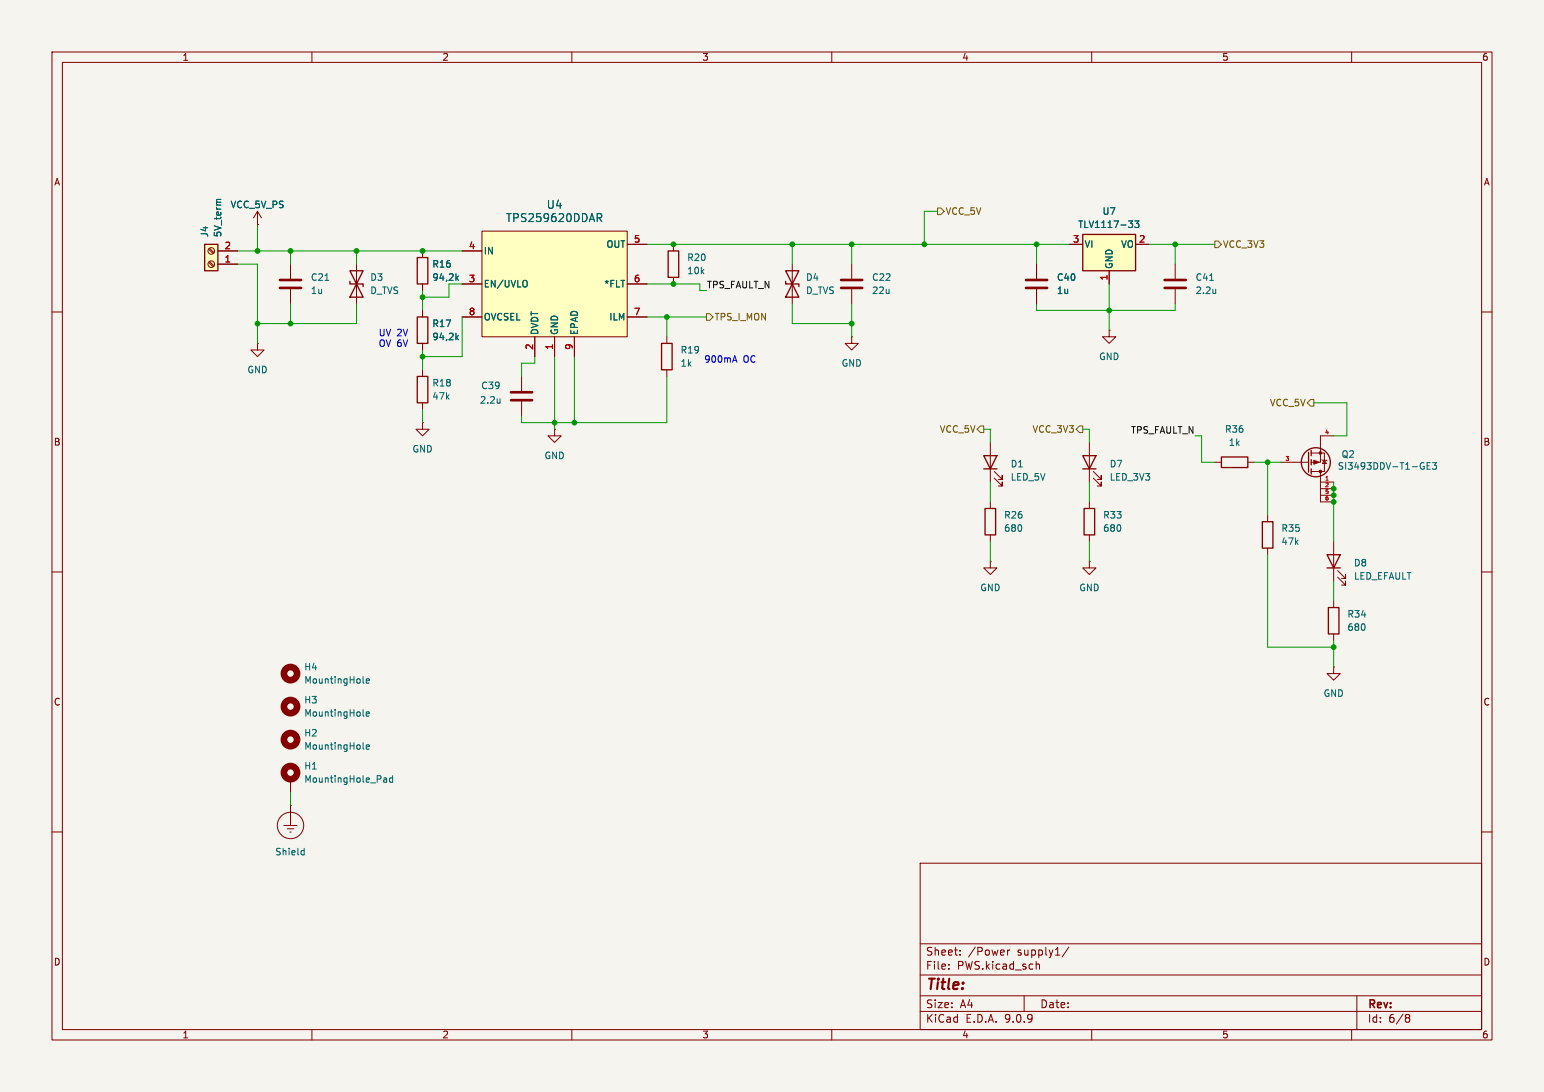
[picture p263: page 1]
