martinrybka2000/openacme-pfm/v1.0/PCB/PFM_9/PFM/PFM.kicad_pcb

## KiCad design v1.0/PCB/PFM_9/PFM/PFM.kicad_pcb (2026-10-15)

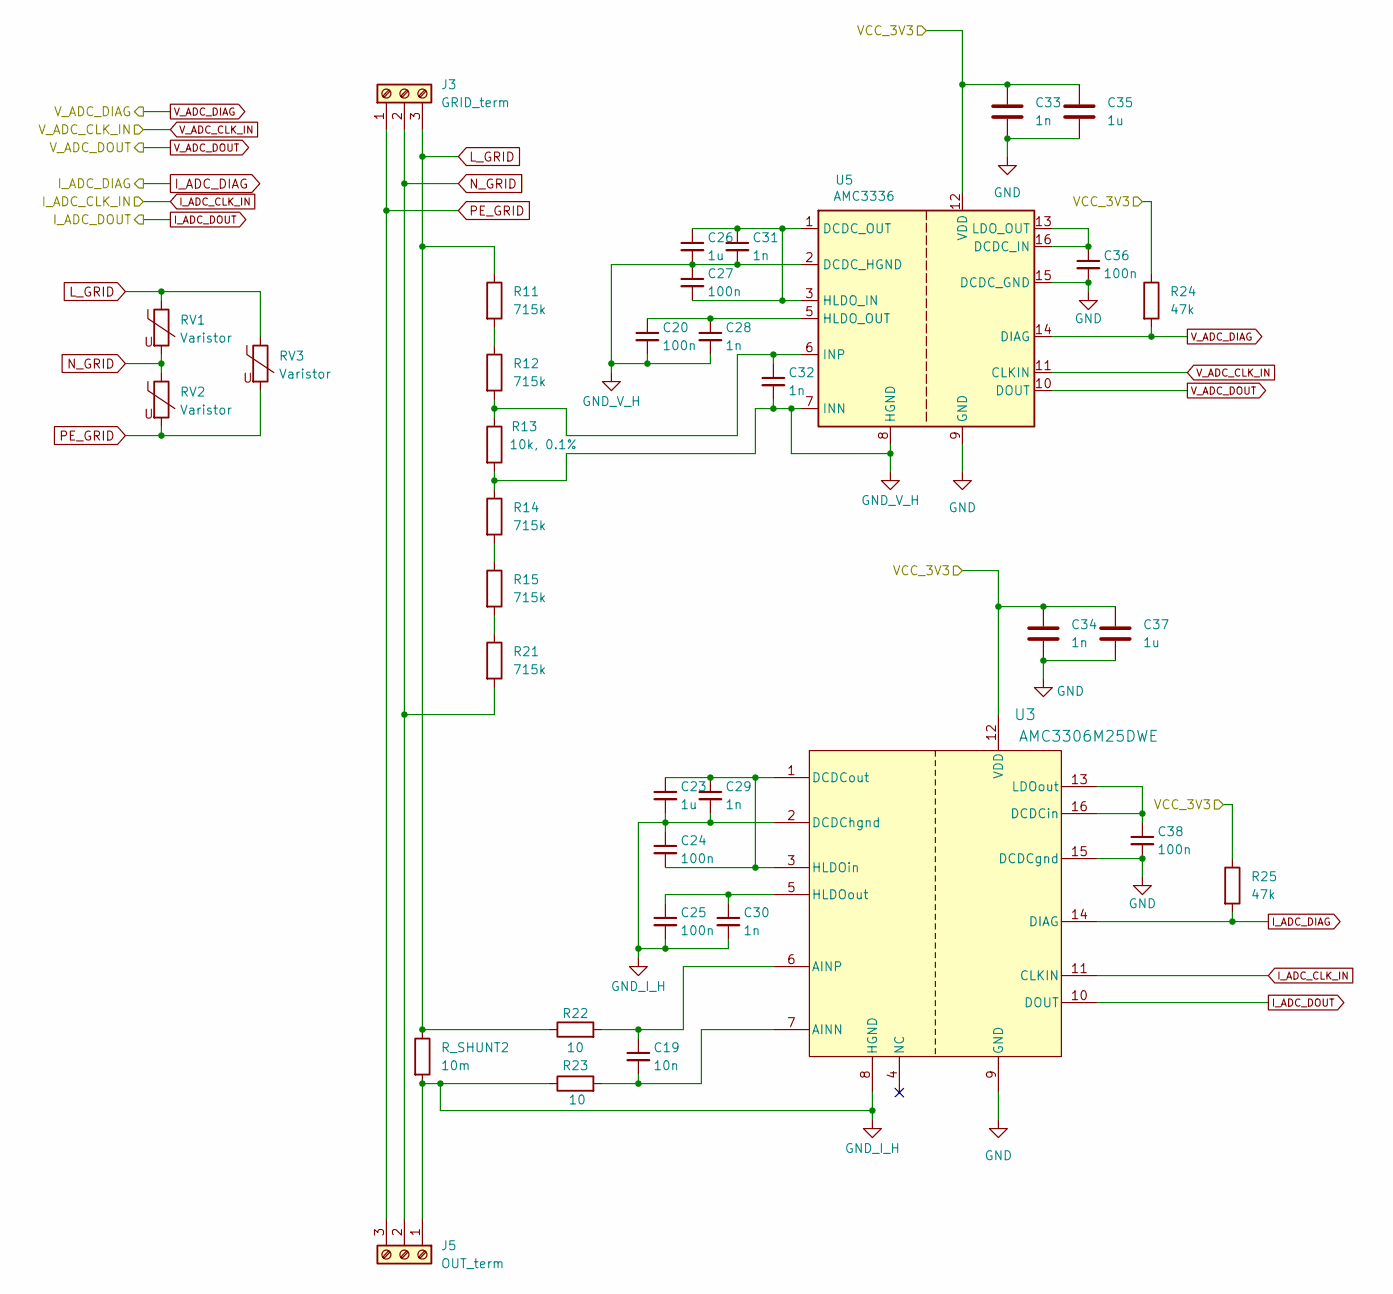
[picture p264: schematic Grids_adcs.kicad_sch]

Parts:
C19: 10n; C_0603_1608Metric_Pad1.08x0.95mm_HandSolder
C20, C25: 100n; C_1206_3216Metric_Pad1.33x1.80mm_HandSolder
C23, C26: 1u; C_0603_1608Metric_Pad1.08x0.95mm_HandSolder
C24, C27, C36, C38: 100n; C_0603_1608Metric_Pad1.08x0.95mm_HandSolder
C28, C30, C33, C34: 1n; C_1206_3216Metric_Pad1.33x1.80mm_HandSolder
C29, C31, C32: 1n; C_0603_1608Metric_Pad1.08x0.95mm_HandSolder
C35, C37: 1u; C_1206_3216Metric_Pad1.33x1.80mm_HandSolder
J3: GRID_term; TerminalBlock_Altech_AK300-3_P5.00mm
J5: OUT_term; TerminalBlock_Altech_AK300-3_P5.00mm
R11, R12, R14, R15, R21: 715k; R_0805_2012Metric_Pad1.20x1.40mm_HandSolder
R13: 10k, 0.1%; R_0603_1608Metric_Pad0.98x0.95mm_HandSolder
R22, R23: 10; R_0603_1608Metric_Pad0.98x0.95mm_HandSolder
R24, R25: 47k; R_0603_1608Metric_Pad0.98x0.95mm_HandSolder
RV1, RV2, RV3: Varistor; R_4020_10251Metric_Pad1.65x5.30mm_HandSolder
R_SHUNT2: 10m; R_2512_6332Metric
U3: AMC3306M25DWE; DWE0016A-IPC_A
U5: AMC3336; SOIC-16W_7.5x10.3mm_P1.27mm

Connections:
/GRID_ADCs1/VCC_3V3: C33.1, C34.1, C35.1, C37.1, R24.1, R25.1, U3.12 (VDD), U5.12 (VDD); also elsewhere on the board
GND: C33.2, C34.2, C35.2, C36.2, C37.2, C38.2, U3.9 (GND), U3.15 (DCDCgnd), U5.9 (GND), U5.15 (DCDC_GND); also elsewhere on the board
GND_I_H: C23.2, C24.1, C25.2, C29.2, C30.2, J5.1, R23.1, R_SHUNT2.2, U3.2 (DCDChgnd), U3.8 (HGND)
GND_V_H: C20.2, C26.2, C27.1, C28.2, C31.2, C32.2, R13.2, R14.1, U5.2 (DCDC_HGND), U5.7 (INN), U5.8 (HGND)
I_ADC_CLK_IN: U3.11 (CLKIN); also elsewhere on the board
I_ADC_DIAG: R25.2, U3.14 (DIAG); also elsewhere on the board
I_ADC_DOUT: U3.10 (DOUT); also elsewhere on the board
L_GRID: J3.3, R11.1, R22.1, RV1.1, RV3.1, R_SHUNT2.1
N_GRID: J3.2, J5.2, R21.2, RV1.2, RV2.1
unnamed: R11.2, R12.1
unnamed: R14.2, R15.1
unnamed: R15.2, R21.1
unnamed: C19.2, R23.2, U3.7 (AINN)
unnamed: C19.1, R22.2, U3.6 (AINP)
unnamed: C38.1, U3.13 (LDOout), U3.16 (DCDCin)
unnamed: C23.1, C24.2, C29.1, U3.1 (DCDCout), U3.3 (HLDOin)
unnamed: C25.1, C30.1, U3.5 (HLDOout)
unnamed: C36.1, U5.13 (LDO_OUT), U5.16 (DCDC_IN)
unnamed: C26.1, C27.2, C31.1, U5.1 (DCDC_OUT), U5.3 (HLDO_IN)
unnamed: C20.1, C28.1, U5.5 (HLDO_OUT)
unnamed: C32.1, R12.2, R13.1, U5.6 (INP)
PE_GRID: J3.1, J5.3, RV2.2, RV3.2
V_ADC_CLK_IN: U5.11 (CLKIN); also elsewhere on the board
V_ADC_DIAG: R24.2, U5.14 (DIAG); also elsewhere on the board
V_ADC_DOUT: U5.10 (DOUT); also elsewhere on the board

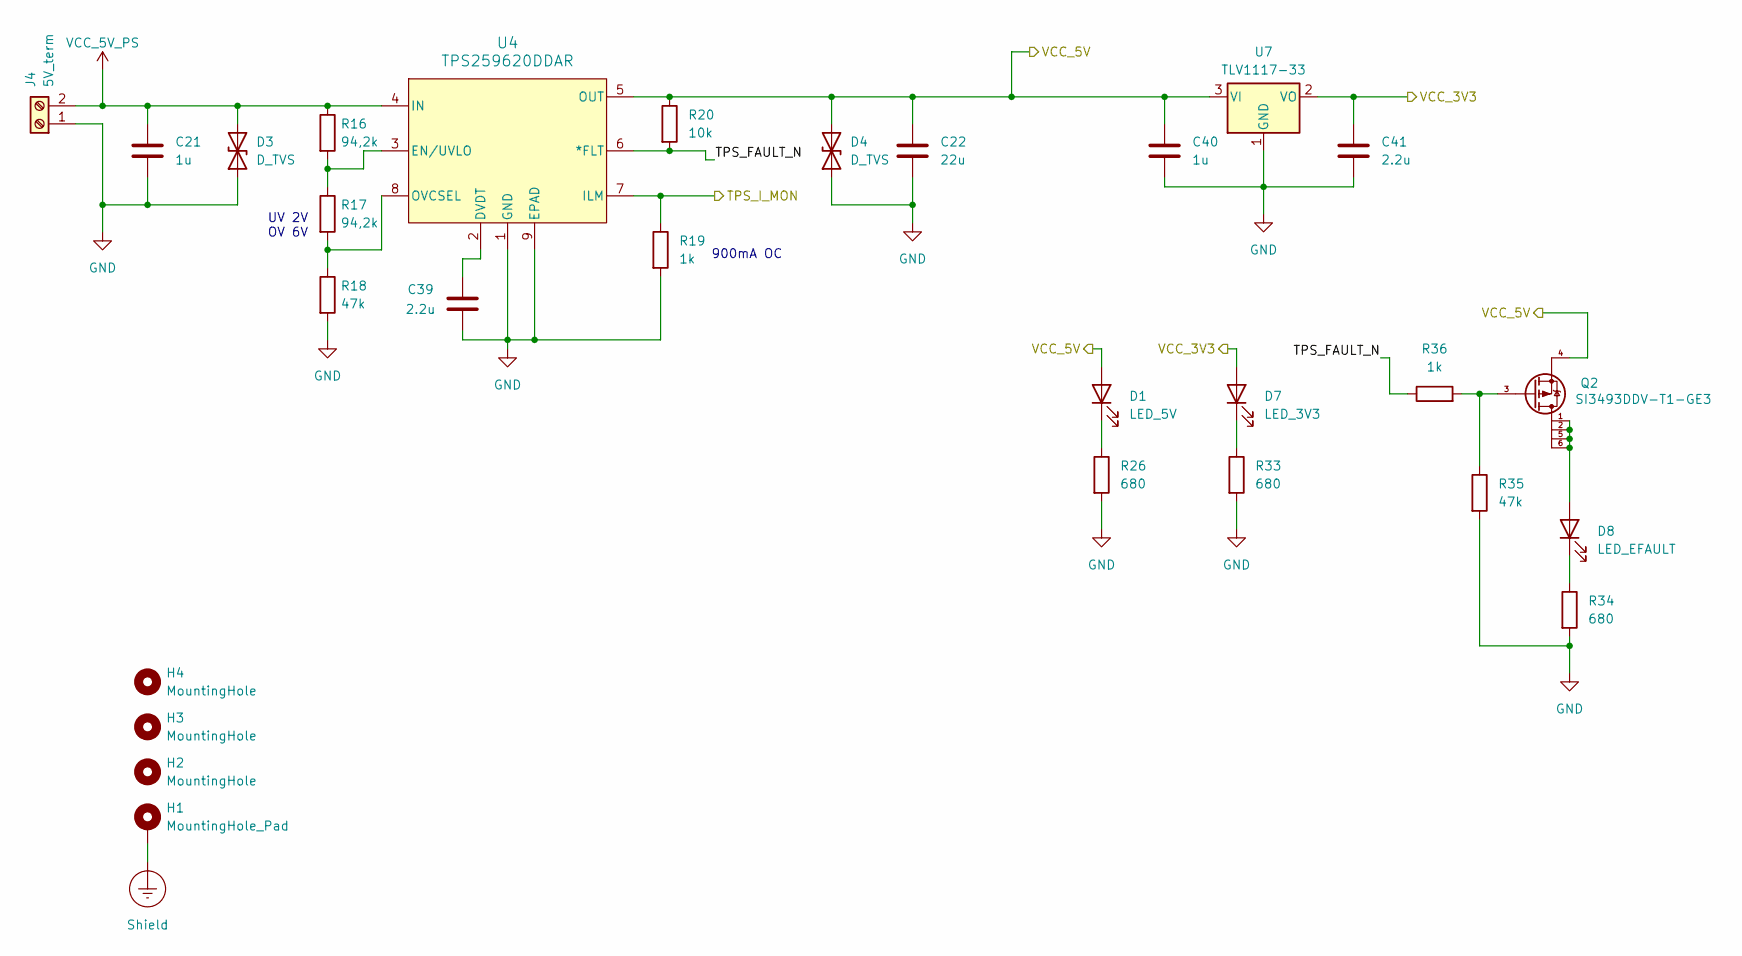
[picture p265: schematic PWS.kicad_sch]

Parts:
C21, C40: 1u; C_1206_3216Metric_Pad1.33x1.80mm_HandSolder
C22: 22u; C_1206_3216Metric_Pad1.33x1.80mm_HandSolder
C39, C41: 2.2u; C_0603_1608Metric_Pad1.08x0.95mm_HandSolder
D1: LED_5V; LED_0805_2012Metric_Pad1.15x1.40mm_HandSolder
D3: D_TVS; D_0603_1608Metric_Pad1.05x0.95mm_HandSolder
D4: D_TVS; D_0402_1005Metric_Pad0.77x0.64mm_HandSolder
D7: LED_3V3; LED_0805_2012Metric_Pad1.15x1.40mm_HandSolder
D8: LED_EFAULT; LED_0805_2012Metric_Pad1.15x1.40mm_HandSolder
H1: MountingHole_Pad; MountingHole_4.3mm_M4_DIN965_Pad_TopBottom
H2, H3, H4: MountingHole; MountingHole_4mm
J4: 5V_term; TerminalBlock_Altech_AK300-2_P5.00mm
Q2: SI3493DDV-T1-GE3; SOT95P284X110-6N; Mouser Part Number 78-SI3493DDV-T1-GE3
R16, R17: 94,2k; R_0603_1608Metric_Pad0.98x0.95mm_HandSolder
R18, R35: 47k; R_0603_1608Metric_Pad0.98x0.95mm_HandSolder
R19, R36: 1k; R_0603_1608Metric_Pad0.98x0.95mm_HandSolder
R20: 10k; R_0603_1608Metric_Pad0.98x0.95mm_HandSolder
R26, R33, R34: 680; R_0603_1608Metric_Pad0.98x0.95mm_HandSolder
U4: TPS259620DDAR; SOIC_20DDAR_TEX
U7: TLV1117-33; SOT-223-3_TabPin2

Connections:
/GRID_ADCs1/VCC_3V3: C41.1, D7.2 (A), U7.2 (VO); also elsewhere on the board
/Power supply1/TPS_FAULT_N: R20.2, R36.1, U4.6 (*FLT)
/Power supply1/TPS_I_MON: R19.1, U4.7 (ILM); also elsewhere on the board
/Power supply1/VCC_5V: C22.1, C40.1, D1.2 (A), D4.2 (A2), Q2.4, R20.1, U4.5 (OUT), U7.3 (VI)
GND: C21.2, C22.2, C39.2, C40.2, C41.2, D3.1 (A1), D4.1 (A1), J4.1, R18.2, R19.2, R26.2, R33.2, R34.2, R35.2, U4.1 (GND), U4.9 (EPAD), U7.1 (GND); also elsewhere on the board
unnamed: D1.1 (K), R26.1
unnamed: D7.1 (K), R33.1
unnamed: D8.2 (A), Q2.1, Q2.2, Q2.5, Q2.6
unnamed: D8.1 (K), R34.1
unnamed: Q2.3, R35.1, R36.2
unnamed: C39.1, U4.2 (DVDT)
unnamed: R16.2, R17.1, U4.3 (EN/UVLO)
unnamed: R17.2, R18.1, U4.8 (OVCSEL)
Shield: H1.1; also elsewhere on the board
VCC_5V_PS: C21.1, D3.2 (A2), J4.2, R16.1, U4.4 (IN)

Notes on the sheet:
900mA OC
UV 2V OV 6V

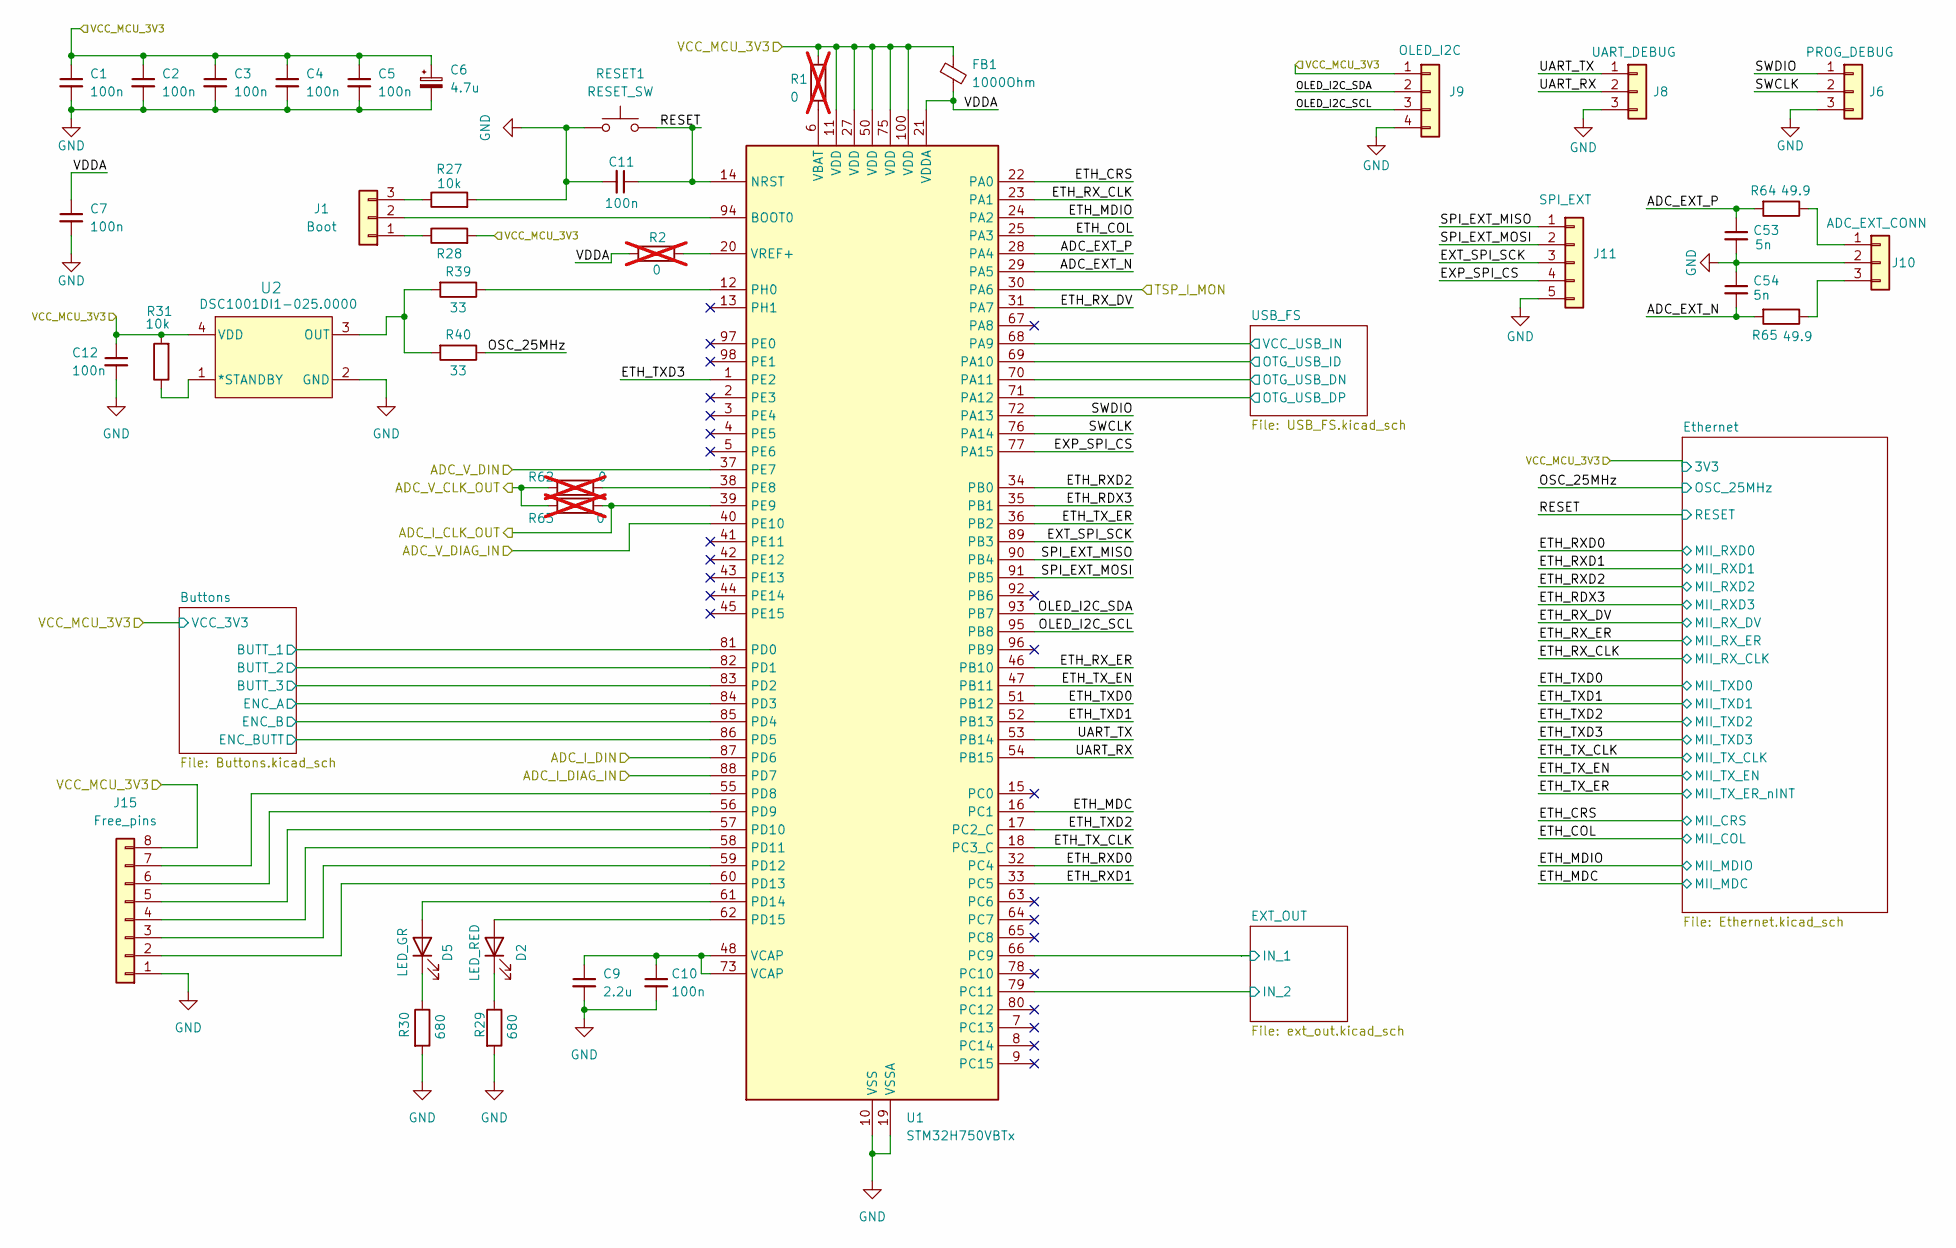
[picture p266: schematic STM32_micro.kicad_sch]

Parts:
C1, C2, C3, C4, C5, C7, C10, C11, C12: 100n; C_0603_1608Metric_Pad1.08x0.95mm_HandSolder
C6: 4.7u; C_0805_2012Metric_Pad1.18x1.45mm_HandSolder
C9: 2.2u; C_0603_1608Metric_Pad1.08x0.95mm_HandSolder
C53, C54: 5n; C_0805_2012Metric
D2: LED_RED; LED_0805_2012Metric_Pad1.15x1.40mm_HandSolder
D5: LED_GR; LED_0805_2012Metric_Pad1.15x1.40mm_HandSolder
FB1: 1000Ohm; L_0603_1608Metric_Pad1.05x0.95mm_HandSolder
J1: Boot; PinHeader_1x03_P2.54mm_Vertical
J6: PROG_DEBUG; PinHeader_1x03_P2.54mm_Vertical
J8: UART_DEBUG; PinHeader_1x03_P2.54mm_Vertical
J9: OLED_I2C; JST_XH_B4B-XH-AM_1x04_P2.50mm_Vertical
J10: ADC_EXT_CONN; FanPinHeader_1x03_P2.54mm_Vertical
J11: SPI_EXT; JST_XH_B5B-XH-AM_1x05_P2.50mm_Vertical
J15: Free_pins; JST_XH_B8B-XH-AM_1x08_P2.50mm_Vertical
R1, R2: 0; R_0402_1005Metric; not fitted
R27, R28, R31: 10k; R_0603_1608Metric_Pad0.98x0.95mm_HandSolder
R29, R30: 680; R_0603_1608Metric_Pad0.98x0.95mm_HandSolder
R39, R40: 33; R_0603_1608Metric_Pad0.98x0.95mm_HandSolder
R62, R63: 0; R_0402_1005Metric_Pad0.72x0.64mm_HandSolder; not fitted
R64, R65: 49.9; R_0402_1005Metric_Pad0.72x0.64mm_HandSolder
RESET1: RESET_SW; SW_DIP_SPSTx01_Slide_9.78x4.72mm_W8.61mm_P2.54mm
U1: STM32H750VBTx; LQFP-100_14x14mm_P0.5mm
U2: DSC1001DI1-025.0000; CDFN4_2P5X2_MCH

Connections:
/GRID_ADCs1/VCC_3V3: C1.1, C2.1, C3.1, C4.1, C5.1, C6.1, C12.1, FB1.1, J9.1, J15.8, R1.1, R28.2, R31.2, U1.11 (VDD), U1.27 (VDD), U1.50 (VDD), U1.75 (VDD), U1.100 (VDD), U2.4 (VDD); also elsewhere on the board
/Power supply1/TPS_I_MON: U1.30 (PA6); also elsewhere on the board
/STM33/ADC_EXT_N: C54.2, R65.2, U1.29 (PA5)
/STM33/ADC_EXT_P: C53.1, R64.2, U1.28 (PA4)
/STM33/Buttons/BUTT_1: U1.81 (PD0); also elsewhere on the board
/STM33/Buttons/BUTT_2: U1.82 (PD1); also elsewhere on the board
/STM33/Buttons/BUTT_3: U1.83 (PD2); also elsewhere on the board
/STM33/Buttons/ENC_A: U1.84 (PD3); also elsewhere on the board
/STM33/Buttons/ENC_B: U1.85 (PD4); also elsewhere on the board
/STM33/Buttons/ENC_BUTT: U1.86 (PD5); also elsewhere on the board
/STM33/ETH_COL: U1.25 (PA3); also elsewhere on the board
/STM33/ETH_CRS: U1.22 (PA0); also elsewhere on the board
/STM33/ETH_MDC: U1.16 (PC1); also elsewhere on the board
/STM33/ETH_MDIO: U1.24 (PA2); also elsewhere on the board
/STM33/ETH_RDX3: U1.35 (PB1); also elsewhere on the board
/STM33/ETH_RXD0: U1.32 (PC4); also elsewhere on the board
/STM33/ETH_RXD1: U1.33 (PC5); also elsewhere on the board
/STM33/ETH_RXD2: U1.34 (PB0); also elsewhere on the board
/STM33/ETH_RX_CLK: U1.23 (PA1); also elsewhere on the board
/STM33/ETH_RX_DV: U1.31 (PA7); also elsewhere on the board
/STM33/ETH_RX_ER: U1.46 (PB10); also elsewhere on the board
/STM33/ETH_TXD0: U1.51 (PB12); also elsewhere on the board
/STM33/ETH_TXD1: U1.52 (PB13); also elsewhere on the board
/STM33/ETH_TXD2: U1.17 (PC2_C); also elsewhere on the board
/STM33/ETH_TXD3: U1.1 (PE2); also elsewhere on the board
/STM33/ETH_TX_CLK: U1.18 (PC3_C); also elsewhere on the board
/STM33/ETH_TX_EN: U1.47 (PB11); also elsewhere on the board
/STM33/ETH_TX_ER: U1.36 (PB2); also elsewhere on the board
/STM33/EXP_SPI_CS: J11.4, U1.77 (PA15)
/STM33/EXT_OUT/IN_1: U1.66 (PC9); also elsewhere on the board
/STM33/EXT_OUT/IN_2: U1.79 (PC11); also elsewhere on the board
/STM33/EXT_SPI_SCK: J11.3, U1.89 (PB3)
/STM33/OLED_I2C_SCL: J9.3, U1.95 (PB8)
/STM33/OLED_I2C_SDA: J9.2, U1.93 (PB7)
/STM33/OSC_25MHz: R40.1; also elsewhere on the board
/STM33/RESET: C11.1, RESET1.2, U1.14 (NRST); also elsewhere on the board
/STM33/SPI_EXT_MISO: J11.1, U1.90 (PB4)
/STM33/SPI_EXT_MOSI: J11.2, U1.91 (PB5)
/STM33/SWCLK: J6.2, U1.76 (PA14)
/STM33/SWDIO: J6.1, U1.72 (PA13)
/STM33/UART_RX: J8.2, U1.54 (PB15)
/STM33/UART_TX: J8.1, U1.53 (PB14)
/STM33/USB_FS/OTG_USB_DN: U1.70 (PA11); also elsewhere on the board
/STM33/USB_FS/OTG_USB_DP: U1.71 (PA12); also elsewhere on the board
/STM33/USB_FS/OTG_USB_ID: U1.69 (PA10); also elsewhere on the board
/STM33/USB_FS/VCC_USB_IN: U1.68 (PA9); also elsewhere on the board
/STM33/VDDA: C7.1, FB1.2, R2.1, U1.21 (VDDA)
GND: C1.2, C2.2, C3.2, C4.2, C5.2, C6.2, C7.2, C9.2, C10.2, C11.2, C12.2, C53.2, C54.1, J6.3, J8.3, J9.4, J10.2, J11.5, J15.1, R27.2, R29.2, R30.2, RESET1.1, U1.10 (VSS), U1.19 (VSSA), U1.26 (VSS), U1.49 (VSS), U1.74 (VSS), U1.99 (VSS), U2.2 (GND); also elsewhere on the board
I_ADC_CLK_IN: R63.1, U1.39 (PE9); also elsewhere on the board
I_ADC_DIAG: U1.88 (PD7); also elsewhere on the board
I_ADC_DOUT: U1.87 (PD6); also elsewhere on the board
unnamed: C9.1, C10.1, U1.48 (VCAP), U1.73 (VCAP)
unnamed: D2.2 (A), U1.62 (PD15)
unnamed: D2.1 (K), R29.1
unnamed: D5.2 (A), U1.61 (PD14)
unnamed: D5.1 (K), R30.1
unnamed: J1.1, R28.1
unnamed: J1.2, U1.94 (BOOT0)
unnamed: J1.3, R27.1
unnamed: J10.1, R64.1
unnamed: J10.3, R65.1
unnamed: J15.2, U1.60 (PD13)
unnamed: J15.3, U1.59 (PD12)
unnamed: J15.4, U1.58 (PD11)
unnamed: J15.5, U1.57 (PD10)
unnamed: J15.6, U1.56 (PD9)
unnamed: J15.7, U1.55 (PD8)
unnamed: R62.1, U1.38 (PE8)
unnamed: R39.1, U1.12 (PH0)
unnamed: R1.2, U1.6 (VBAT)
unnamed: R2.2, U1.20 (VREF+)
unnamed: R31.1, U2.1 (*STANDBY)
unnamed: R39.2, R40.2, U2.3 (OUT)
V_ADC_CLK_IN: R62.2, R63.2; also elsewhere on the board
V_ADC_DIAG: U1.40 (PE10); also elsewhere on the board
V_ADC_DOUT: U1.37 (PE7); also elsewhere on the board

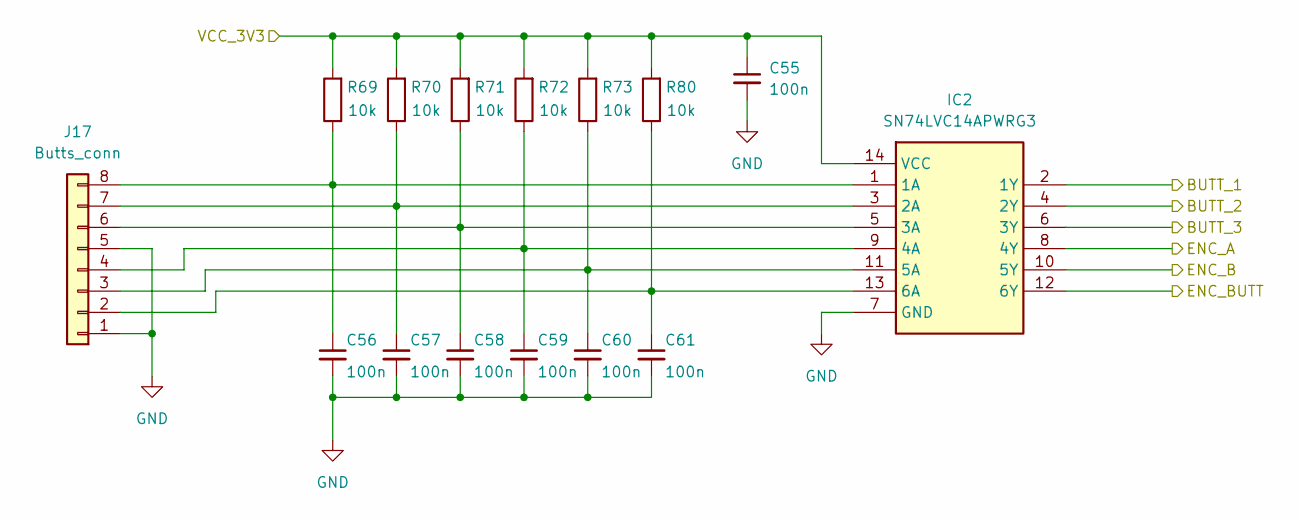
[picture p267: schematic Buttons.kicad_sch]

Parts:
C55, C56, C57, C58, C59, C60, C61: 100n; C_0603_1608Metric_Pad1.08x0.95mm_HandSolder
IC2: SN74LVC14APWRG3; SOP65P640X120-14N; Mouser Part Number 595-SN74LVC14APWRG3
J17: Butts_conn; JST_XH_B8B-XH-AM_1x08_P2.50mm_Vertical
R69, R70, R71, R72, R73, R80: 10k; R_0603_1608Metric_Pad0.98x0.95mm_HandSolder

Connections:
/GRID_ADCs1/VCC_3V3: C55.1, IC2.14 (VCC), R69.2, R70.2, R71.2, R72.2, R73.2, R80.2; also elsewhere on the board
/STM33/Buttons/BUTT_1: IC2.2 (1Y); also elsewhere on the board
/STM33/Buttons/BUTT_2: IC2.4 (2Y); also elsewhere on the board
/STM33/Buttons/BUTT_3: IC2.6 (3Y); also elsewhere on the board
/STM33/Buttons/ENC_A: IC2.8 (4Y); also elsewhere on the board
/STM33/Buttons/ENC_B: IC2.10 (5Y); also elsewhere on the board
/STM33/Buttons/ENC_BUTT: IC2.12 (6Y); also elsewhere on the board
GND: C55.2, C56.2, C57.2, C58.2, C59.2, C60.2, C61.2, IC2.7 (GND), J17.1, J17.5; also elsewhere on the board
unnamed: C56.1, IC2.1 (1A), J17.8, R69.1
unnamed: C57.1, IC2.3 (2A), J17.7, R70.1
unnamed: C58.1, IC2.5 (3A), J17.6, R71.1
unnamed: C59.1, IC2.9 (4A), J17.4, R72.1
unnamed: C60.1, IC2.11 (5A), J17.3, R73.1
unnamed: C61.1, IC2.13 (6A), J17.2, R80.1

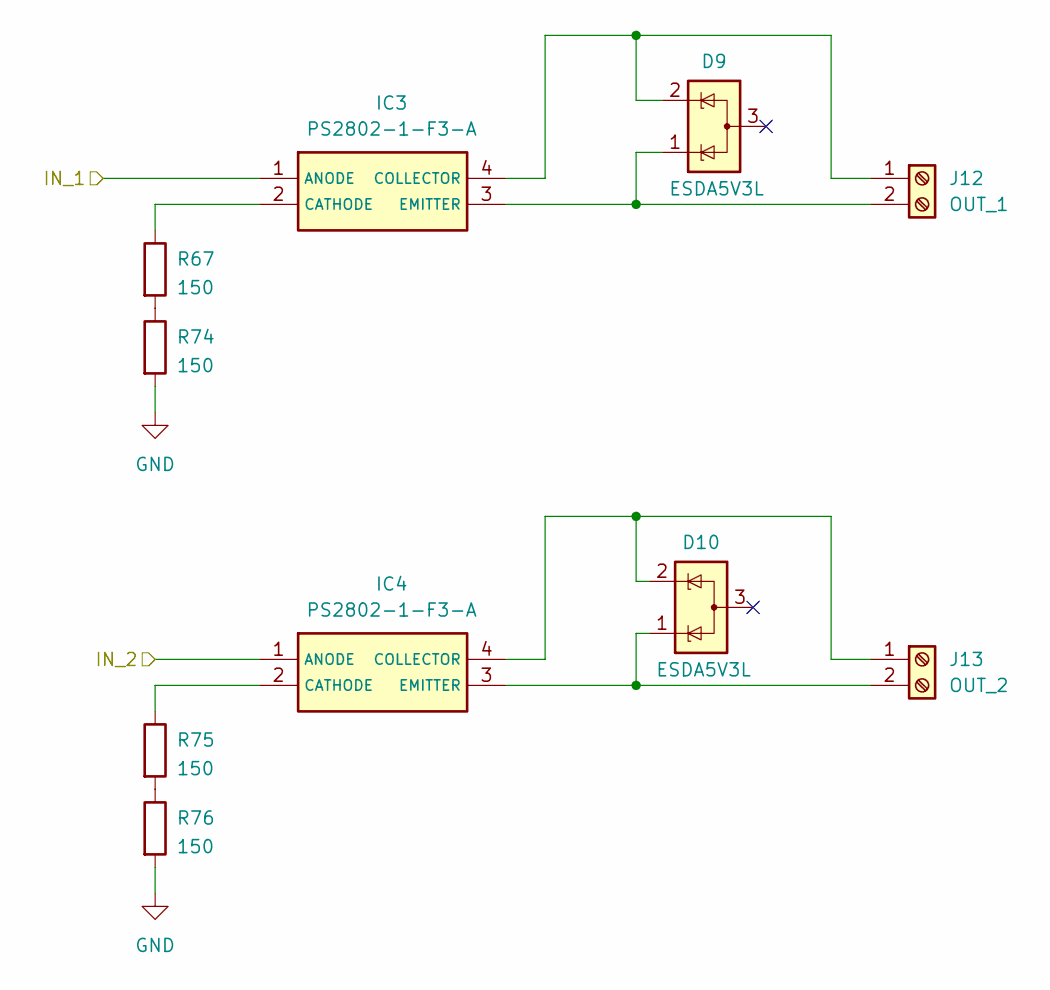
[picture p268: schematic ext_out.kicad_sch]

Parts:
D9, D10: ESDA5V3L; SOT-23-3
IC3, IC4: PS2802-1-F3-A; SOIC127P700X210-4N; Mouser Part Number 551-PS2802-1-F3-A
J12: OUT_1; TerminalBlock_Altech_AK300-2_P5.00mm
J13: OUT_2; TerminalBlock_Altech_AK300-2_P5.00mm
R67, R74, R75, R76: 150; R_0603_1608Metric_Pad0.98x0.95mm_HandSolder

Connections:
/STM33/EXT_OUT/IN_1: IC3.1 (ANODE); also elsewhere on the board
/STM33/EXT_OUT/IN_2: IC4.1 (ANODE); also elsewhere on the board
GND: R74.2, R76.2; also elsewhere on the board
unnamed: IC3.2 (CATHODE), R67.1
unnamed: D9.2 (K), IC3.4 (COLLECTOR), J12.1
unnamed: D9.1 (K), IC3.3 (EMITTER), J12.2
unnamed: IC4.2 (CATHODE), R75.1
unnamed: D10.2 (K), IC4.4 (COLLECTOR), J13.1
unnamed: D10.1 (K), IC4.3 (EMITTER), J13.2
unnamed: R67.2, R74.1
unnamed: R75.2, R76.1

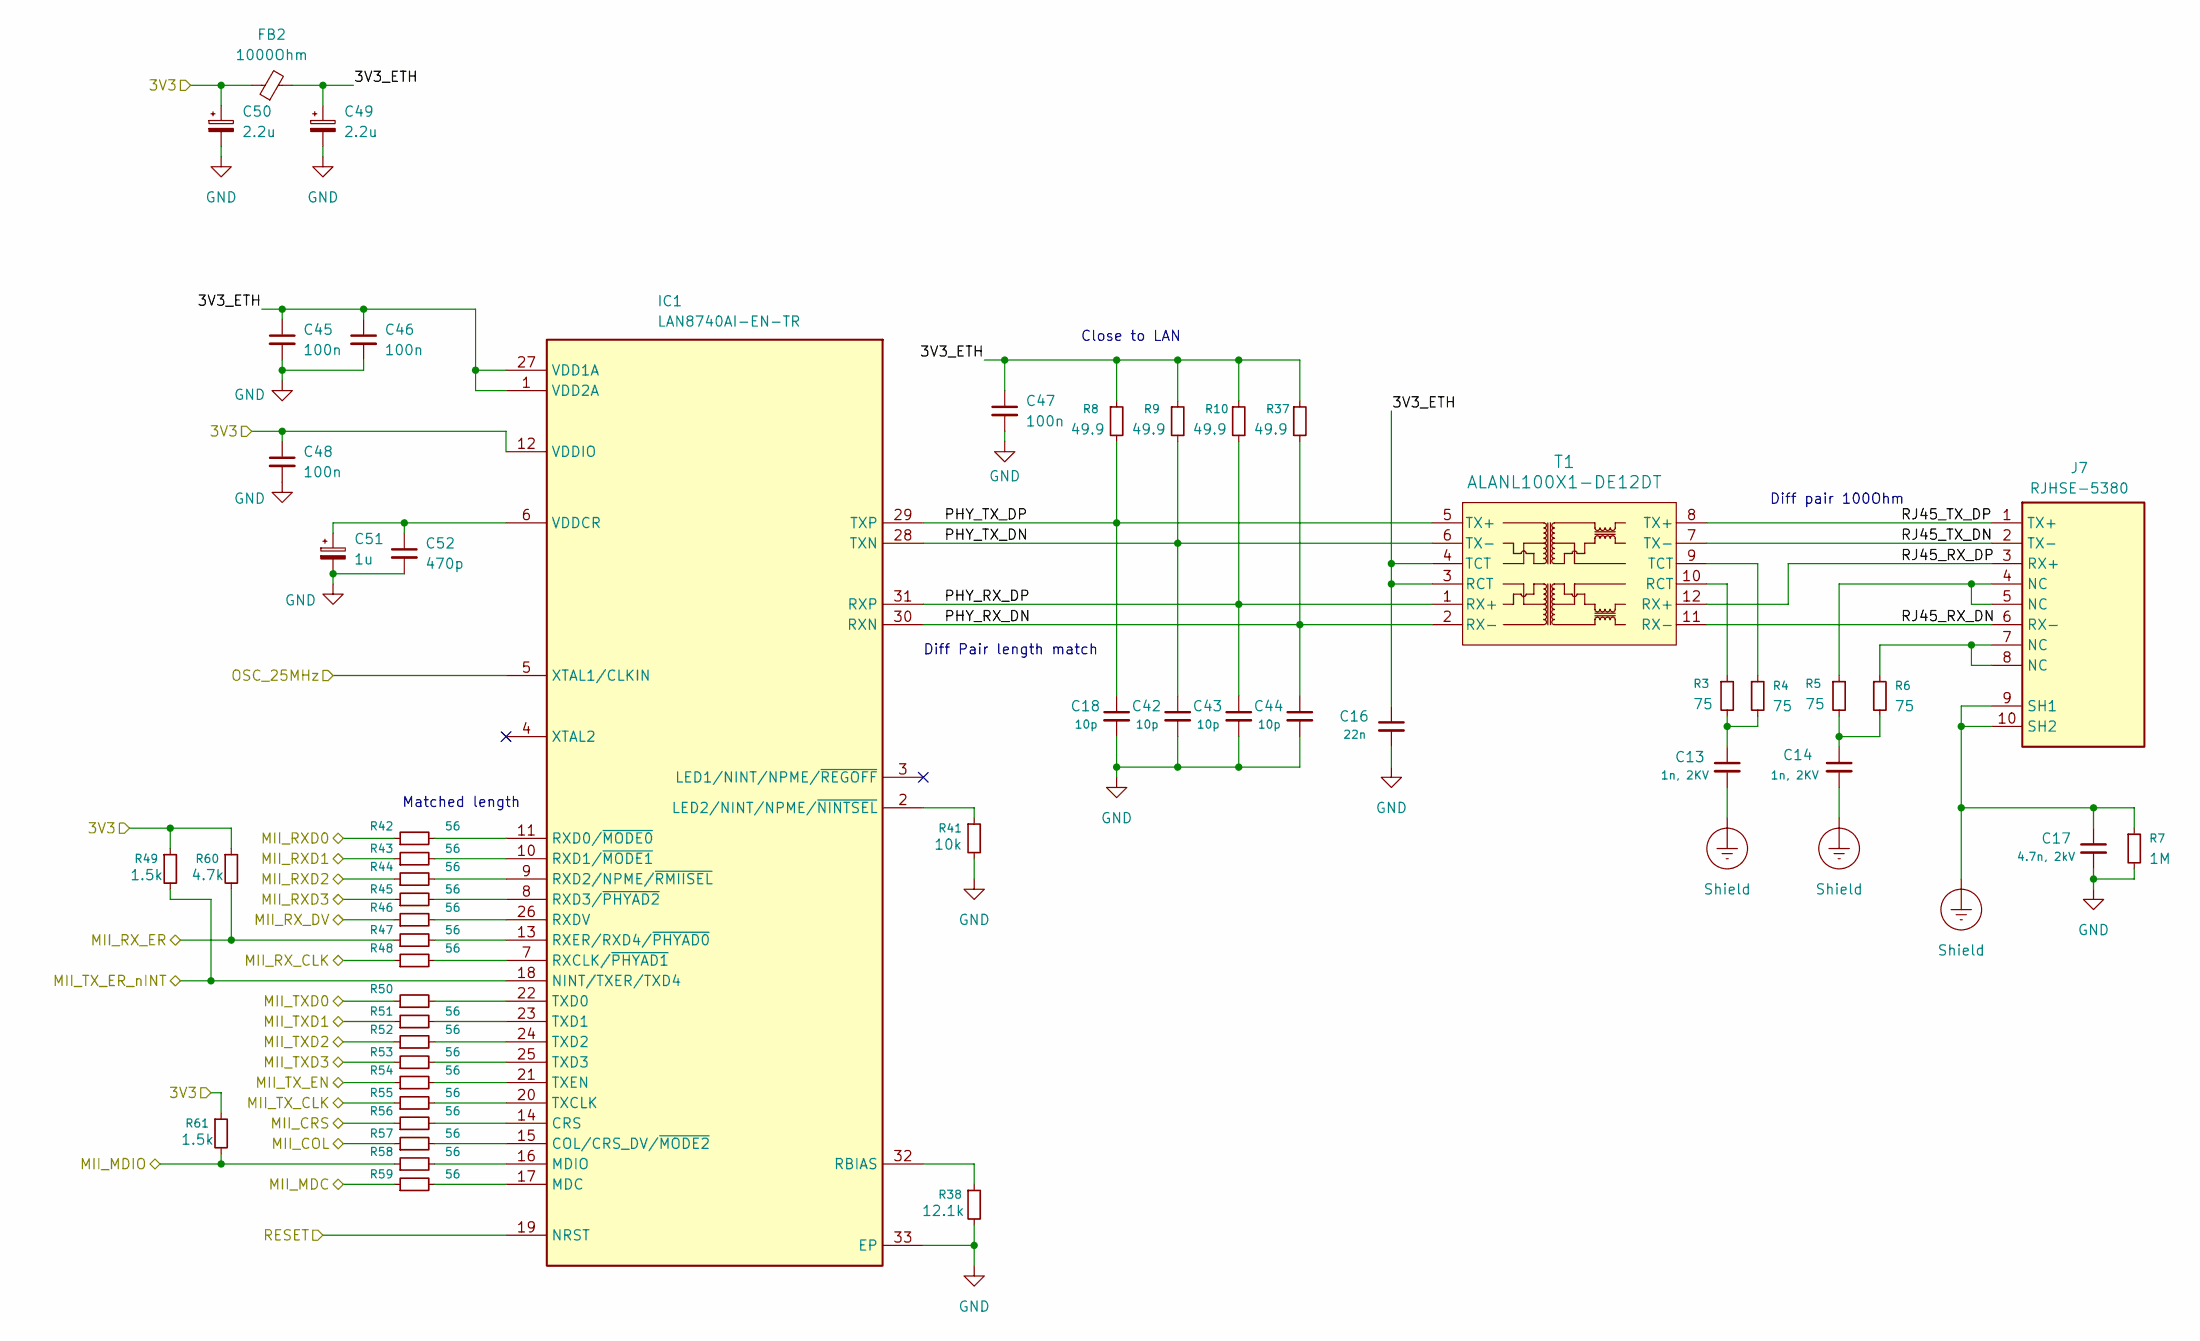
[picture p269: schematic Ethernet.kicad_sch]

Parts:
C13, C14: 1n, 2KV; C_1206_3216Metric_Pad1.33x1.80mm_HandSolder
C16: 22n; C_0402_1005Metric_Pad0.74x0.62mm_HandSolder
C17: 4.7n, 2kV; C_1210_3225Metric_Pad1.33x2.70mm_HandSolder
C18, C42, C43, C44: 10p; C_0402_1005Metric_Pad0.74x0.62mm_HandSolder
C45, C46, C48: 100n; C_0402_1005Metric
C47: 100n; C_0603_1608Metric_Pad1.08x0.95mm_HandSolder
C49, C50: 2.2u; C_0603_1608Metric_Pad1.08x0.95mm_HandSolder
C51: 1u; C_1206_3216Metric_Pad1.33x1.80mm_HandSolder
C52: 470p; C_0402_1005Metric
FB2: 1000Ohm; L_0603_1608Metric_Pad1.05x0.95mm_HandSolder
IC1: LAN8740AI-EN-TR; QFN50P500X500X100-33N-D; Mouser Part Number 579-LAN8740AI-EN-TR
J7: RJHSE-5380; RJ45_HALO_HFJ11-x2450HRL_Horizontal; Manufacturer_Part_Number RJHSE-5380
R3, R4, R5, R6: 75; R_0402_1005Metric_Pad0.72x0.64mm_HandSolder
R7: 1M; R_2512_6332Metric_Pad1.40x3.35mm_HandSolder
R8, R9, R10, R37: 49.9; R_0402_1005Metric_Pad0.72x0.64mm_HandSolder
R38: 12.1k; C_0603_1608Metric_Pad1.08x0.95mm_HandSolder
R41: 10k; R_0603_1608Metric_Pad0.98x0.95mm_HandSolder
R42, R43, R44, R45, R46, R47, R48, R56, R57, R58, R59: 56; R_0402_1005Metric
R49, R61: 1.5k; R_0402_1005Metric
R50, R51, R52, R53, R54, R55: 56; R_0402_1005Metric_Pad0.72x0.64mm_HandSolder
R60: 4.7k; R_0402_1005Metric
T1: ALANL100X1-DE12DT; SOIC12_ALANL100X1_ABR

Connections:
/GRID_ADCs1/VCC_3V3: C48.1, C50.1, FB2.1, IC1.12 (VDDIO), R49.1, R60.1, R61.1; also elsewhere on the board
/STM33/ETH_COL: R57.1; also elsewhere on the board
/STM33/ETH_CRS: R56.1; also elsewhere on the board
/STM33/ETH_MDC: R59.1; also elsewhere on the board
/STM33/ETH_MDIO: R58.1, R61.2; also elsewhere on the board
/STM33/ETH_RDX3: R45.1; also elsewhere on the board
/STM33/ETH_RXD0: R42.1; also elsewhere on the board
/STM33/ETH_RXD1: R43.1; also elsewhere on the board
/STM33/ETH_RXD2: R44.1; also elsewhere on the board
/STM33/ETH_RX_CLK: R48.1; also elsewhere on the board
/STM33/ETH_RX_DV: R46.1; also elsewhere on the board
/STM33/ETH_RX_ER: R47.1, R60.2; also elsewhere on the board
/STM33/ETH_TXD0: R50.1; also elsewhere on the board
/STM33/ETH_TXD1: R51.1; also elsewhere on the board
/STM33/ETH_TXD2: R52.1; also elsewhere on the board
/STM33/ETH_TXD3: R53.1; also elsewhere on the board
/STM33/ETH_TX_CLK: R55.1; also elsewhere on the board
/STM33/ETH_TX_EN: R54.1; also elsewhere on the board
/STM33/ETH_TX_ER: IC1.18 (NINT/TXER/TXD4), R49.2; also elsewhere on the board
/STM33/Ethernet/3V3_ETH: C16.1, C45.1, C46.1, C47.1, C49.1, FB2.2, IC1.1 (VDD2A), IC1.27 (VDD1A), R8.1, R9.1, R10.1, R37.1, T1.3 (RCT), T1.4 (TCT)
/STM33/Ethernet/PHY_RX_DN: C44.1, IC1.30 (RXN), R37.2, T1.2 (RX-)
/STM33/Ethernet/PHY_RX_DP: C43.1, IC1.31 (RXP), R10.2, T1.1 (RX+)
/STM33/Ethernet/PHY_TX_DN: C42.1, IC1.28 (TXN), R9.2, T1.6 (TX-)
/STM33/Ethernet/PHY_TX_DP: C18.1, IC1.29 (TXP), R8.2, T1.5 (TX+)
/STM33/Ethernet/RJ45_RX_DN: J7.6 (RX-), T1.11 (RX-)
/STM33/Ethernet/RJ45_RX_DP: J7.3 (RX+), T1.12 (RX+)
/STM33/Ethernet/RJ45_TX_DN: J7.2 (TX-), T1.7 (TX-)
/STM33/Ethernet/RJ45_TX_DP: J7.1 (TX+), T1.8 (TX+)
/STM33/OSC_25MHz: IC1.5 (XTAL1/CLKIN); also elsewhere on the board
/STM33/RESET: IC1.19 (NRST); also elsewhere on the board
GND: C16.2, C17.2, C18.2, C42.2, C43.2, C44.2, C45.2, C46.2, C47.2, C48.2, C49.2, C50.2, C51.2, C52.2, IC1.33 (EP), R7.2, R38.2, R41.2; also elsewhere on the board
unnamed: C13.1, R3.2, R4.2
unnamed: C14.1, R5.2, R6.2
unnamed: IC1.15 (COL/CRS_DV/~MODE2), R57.2
unnamed: IC1.14 (CRS), R56.2
unnamed: IC1.2 (LED2/NINT/NPME/~NINTSEL), R41.1
unnamed: IC1.17 (MDC), R59.2
unnamed: IC1.16 (MDIO), R58.2
unnamed: IC1.32 (RBIAS), R38.1
unnamed: IC1.7 (RXCLK/~PHYAD1), R48.2
unnamed: IC1.11 (RXD0/~MODE0), R42.2
unnamed: IC1.10 (RXD1/~MODE1), R43.2
unnamed: IC1.9 (RXD2/NPME/~RMIISEL), R44.2
unnamed: IC1.8 (RXD3/~PHYAD2), R45.2
unnamed: IC1.26 (RXDV), R46.2
unnamed: IC1.13 (RXER/RXD4/~PHYAD0), R47.2
unnamed: IC1.20 (TXCLK), R55.2
unnamed: IC1.22 (TXD0), R50.2
unnamed: IC1.23 (TXD1), R51.2
unnamed: IC1.24 (TXD2), R52.2
unnamed: IC1.25 (TXD3), R53.2
unnamed: IC1.21 (TXEN), R54.2
unnamed: C51.1, C52.1, IC1.6 (VDDCR)
unnamed: J7.4 (NC), J7.5 (NC), R5.1
unnamed: J7.7 (NC), J7.8 (NC), R6.1
unnamed: R3.1, T1.10 (RCT)
unnamed: R4.1, T1.9 (TCT)
Shield: C13.2, C14.2, C17.1, J7.9 (SH1), J7.10 (SH2), R7.1; also elsewhere on the board

Notes on the sheet:
Diff Pair length match
Matched length
Close to LAN
Diff pair 100Ohm

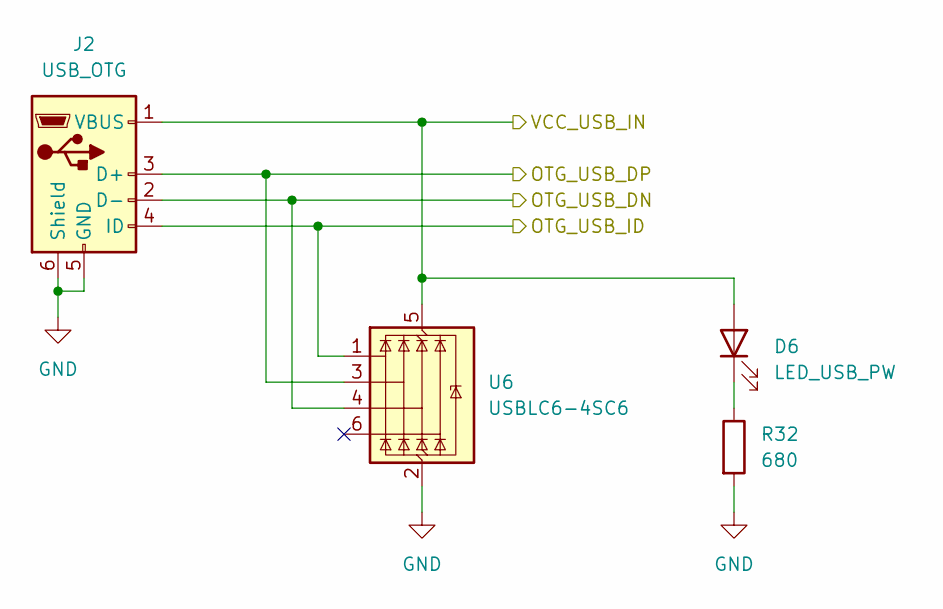
[picture p270: schematic USB_FS.kicad_sch]

Parts:
D6: LED_USB_PW; LED_0805_2012Metric_Pad1.15x1.40mm_HandSolder
J2: USB_OTG; USB_Micro-AB_Molex_47590-0001
R32: 680; R_0603_1608Metric_Pad0.98x0.95mm_HandSolder
U6: USBLC6-4SC6; SOT-23-6

Connections:
/STM33/USB_FS/OTG_USB_DN: J2.2 (D-), U6.4 (I/O3); also elsewhere on the board
/STM33/USB_FS/OTG_USB_DP: J2.3 (D+), U6.3 (I/O2); also elsewhere on the board
/STM33/USB_FS/OTG_USB_ID: J2.4 (ID), U6.1 (I/O1); also elsewhere on the board
/STM33/USB_FS/VCC_USB_IN: D6.2 (A), J2.1 (VBUS), U6.5 (VBUS); also elsewhere on the board
GND: J2.5 (GND), J2.6 (Shield), R32.2, U6.2 (GND); also elsewhere on the board
unnamed: D6.1 (K), R32.1

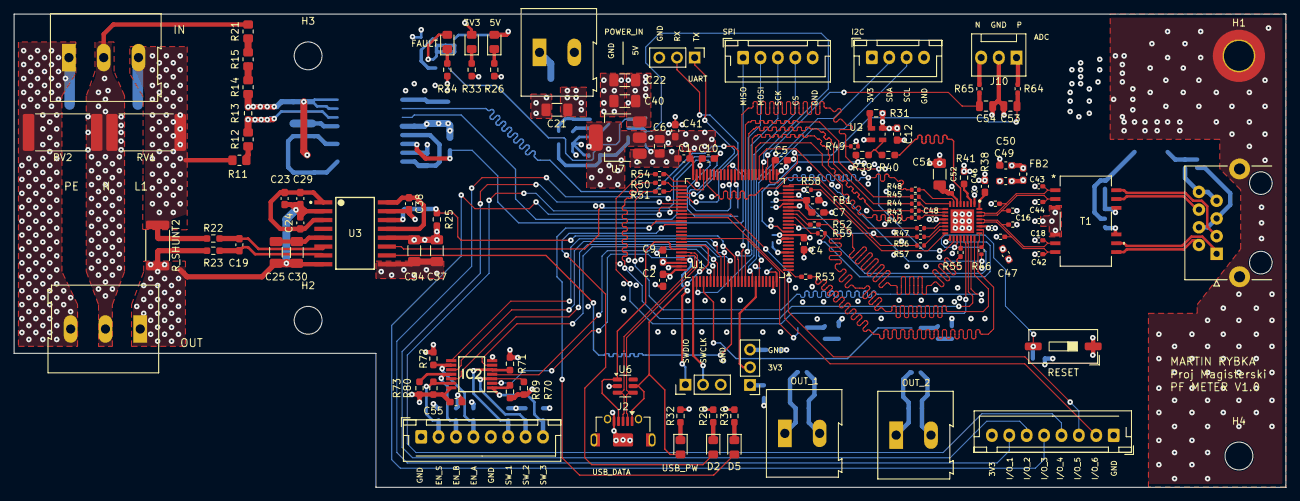
[picture p271: board PFM.kicad_pcb from above]

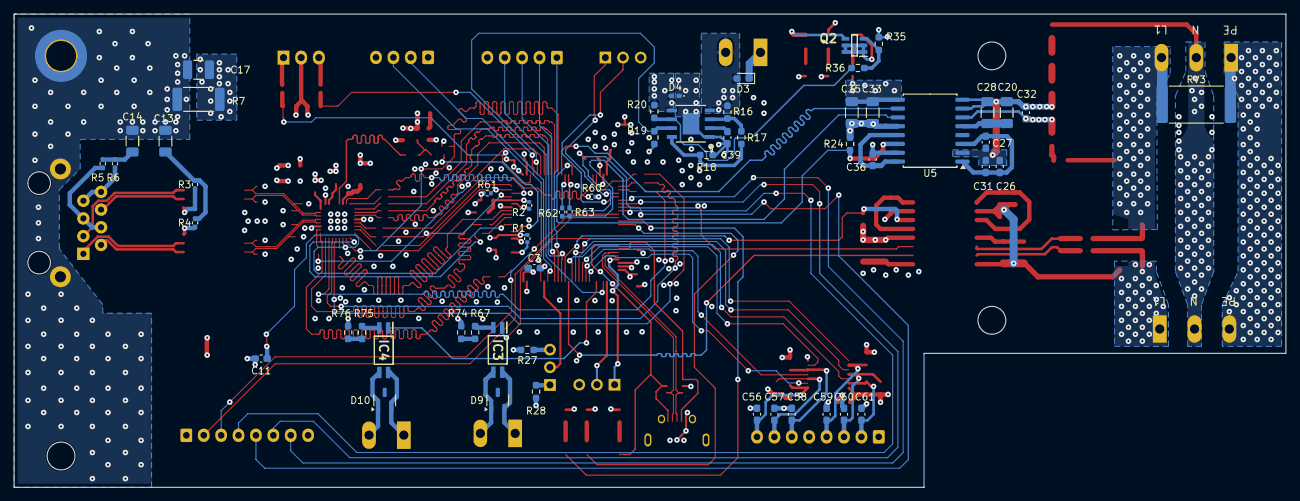
[picture p272: board PFM.kicad_pcb from below]

Board: 4 copper layers, 182.8 x 68.0 mm, 183 parts (56 on the bottom side), 155 nets.

Other parts of the board:
RESET: RESET_SW; SW_DIP_SPSTx01_Slide_9.78x4.72mm_W8.61mm_P2.54mm

Their connections:
/STM33/RESET: RESET.2; also elsewhere on the board
GND: RESET.1; also elsewhere on the board
