martinrybka2000/openacme-pfm/v1.0/PCB/PCB - Copy.ioc

Mcu.UserName=STM32H750VBTx
PA0.Signal=ETH_CRS
PA1.Signal=ETH_RX_CLK
PA10.Signal=USB_OTG_FS_ID
PA11.Signal=USB_OTG_FS_DM
PA12.Signal=USB_OTG_FS_DP
PA2.Signal=ETH_MDIO
PA3.Signal=ETH_COL
PA4.Signal=ADCx_INP18
PA5.Signal=ADCx_INN18
PA6.GPIO_Label=TPS_I_MON
PA6.Signal=ADCx_INP3
PA7.Signal=ETH_RX_DV
PA9.Signal=USB_OTG_FS_VBUS
PB0.Signal=ETH_RXD2
PB1.Signal=ETH_RXD3
PB10.Signal=ETH_RX_ER
PB11.Signal=ETH_TX_EN
PB12.Signal=ETH_TXD0
PB13.Signal=ETH_TXD1
PB14.Signal=USART1_TX
PB15.Signal=USART1_RX
PB2.Signal=ETH_TX_ER
PB5.Signal=SPI1_MOSI
PB6.Signal=I2C1_SCL
PB7.Signal=I2C1_SDA
PC1.Signal=ETH_MDC
PC11.GPIO_Label=OUT_2
PC11.Signal=GPIO_Output
PC2_C.Signal=ETH_TXD2
PC3_C.Signal=ETH_TX_CLK
PC4.Signal=ETH_RXD0
PC5.Signal=ETH_RXD1
PC9.GPIO_Label=OUT_1
PC9.Signal=GPIO_Output
PD0.GPIO_Label=Butt_1
PD0.Signal=GPIO_Input
PD1.GPIO_Label=Butt_2
PD1.Signal=GPIO_Input
PD14.GPIO_Label=LED_GREEN
PD14.Signal=GPIO_Output
PD15.GPIO_Label=LED_RED
PD15.Signal=GPIO_Output
PD2.GPIO_Label=Butt_3
PD2.Signal=GPIO_Input
PD3.GPIO_Label=ENC_A
PD3.Signal=GPIO_Input
PD4.GPIO_Label=ENC_B
PD4.Signal=GPIO_Input
PD5.GPIO_Label=ENC_Butt
PD5.Signal=GPIO_Input
PD6.Signal=S_DATAIN1DFSDM1
PD7.GPIO_Label=ADC_I_DIAG
PD7.Signal=GPIO_Input
PE10.GPIO_Label=ADC_V_DIAG
PE10.Signal=GPIO_Input
PE2.Signal=ETH_TXD3
PE7.Signal=S_DATAIN2DFSDM1
PE8.GPIO_Label=DFSDM_U_CLKOUT2
PE8.Signal=GPIO_Output
PE9.Signal=S_CKOUTDFSDM1
